kevinnaoko/TA-2122024/Poster/FRONTSIDE_BESAR.png

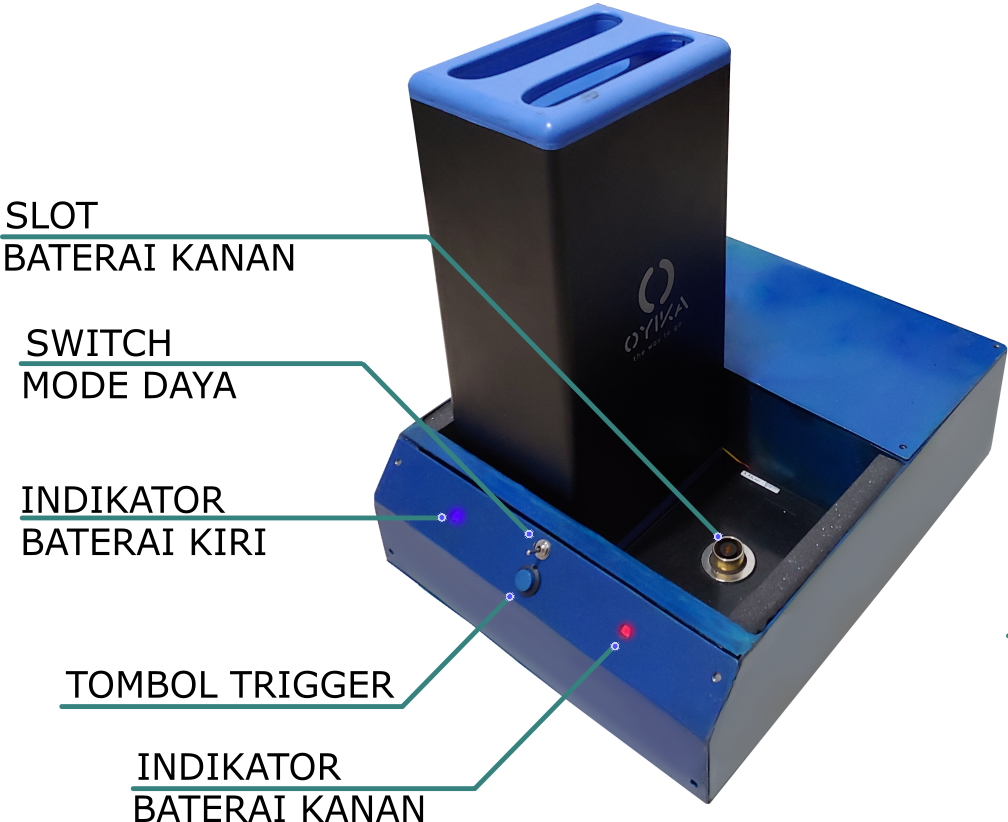
Poster/FRONTSIDE_BESAR.png
