kevinnaoko/TA-2122024/Poster/Brochure 05.jpg

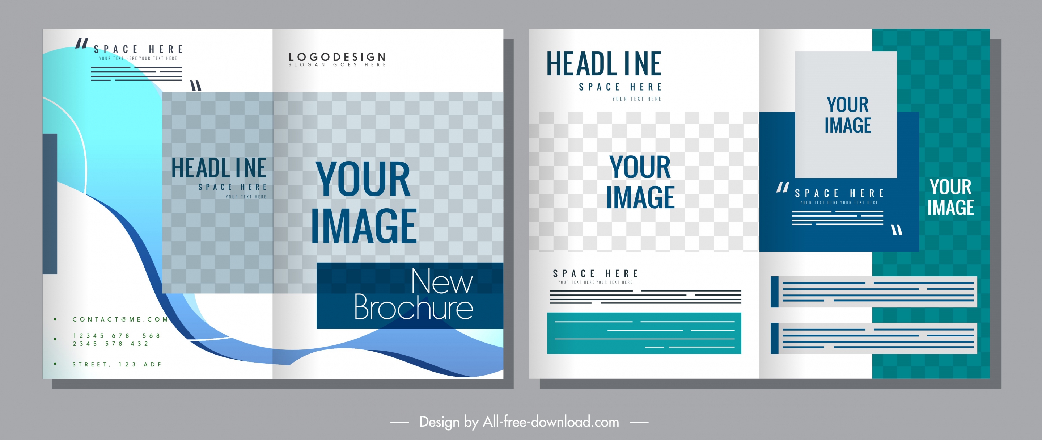
Poster/Brochure 05.jpg
