kevinnaoko/TA-2122024/README.md

# TA-2122024
Capstone Design Kelompok 24
