kevinnaoko/TA-2122024/Eagle/BRD_Charger.png

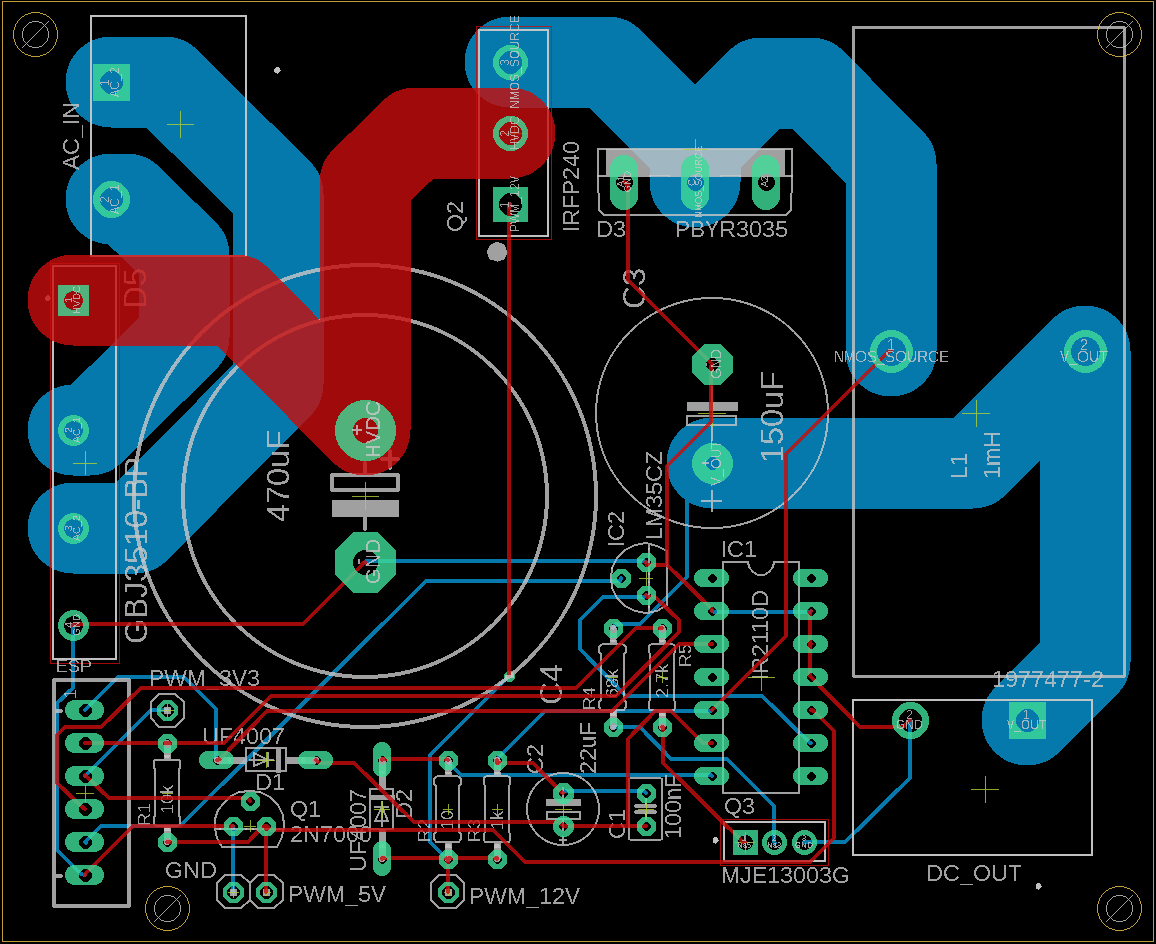
Eagle/BRD_Charger.png
