kevinnaoko/TA-2122024/Eagle/charger board v4_TLP driver circuit (tanya)/chg v4 tlp.png

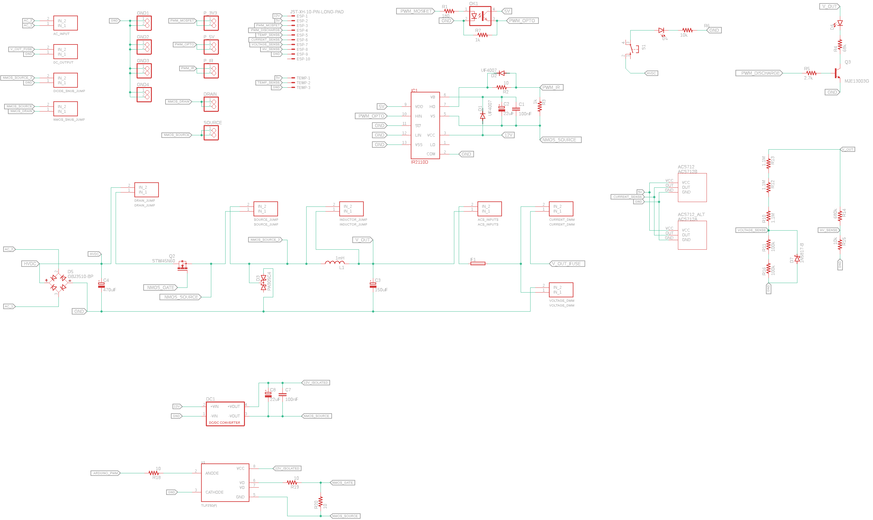
Eagle/charger board v4_TLP driver circuit (tanya)/chg v4 tlp.png
