kevinnaoko/TA-2122024/Eagle/charger board v4_TLP driver circuit/chg v4 tlp.png

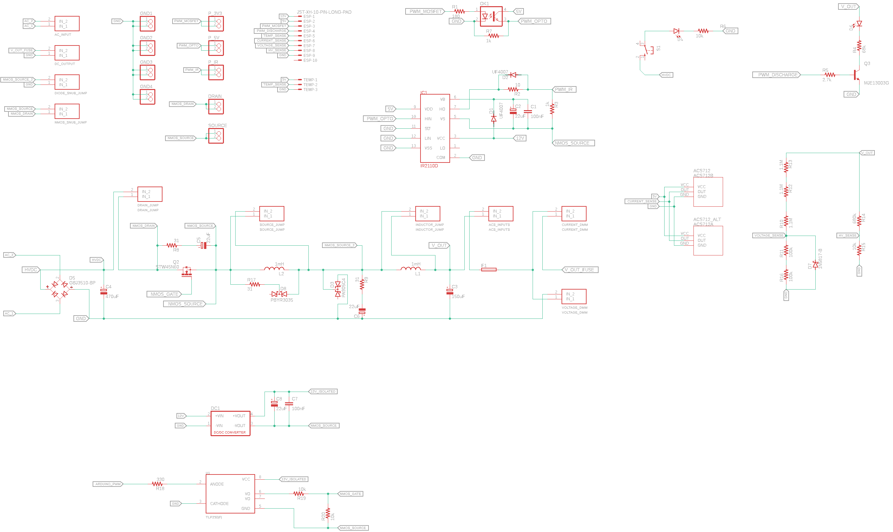
Eagle/charger board v4_TLP driver circuit/chg v4 tlp.png
