kevinnaoko/TA-2122024/Eagle/Pics/charger_v4 - Copy.png

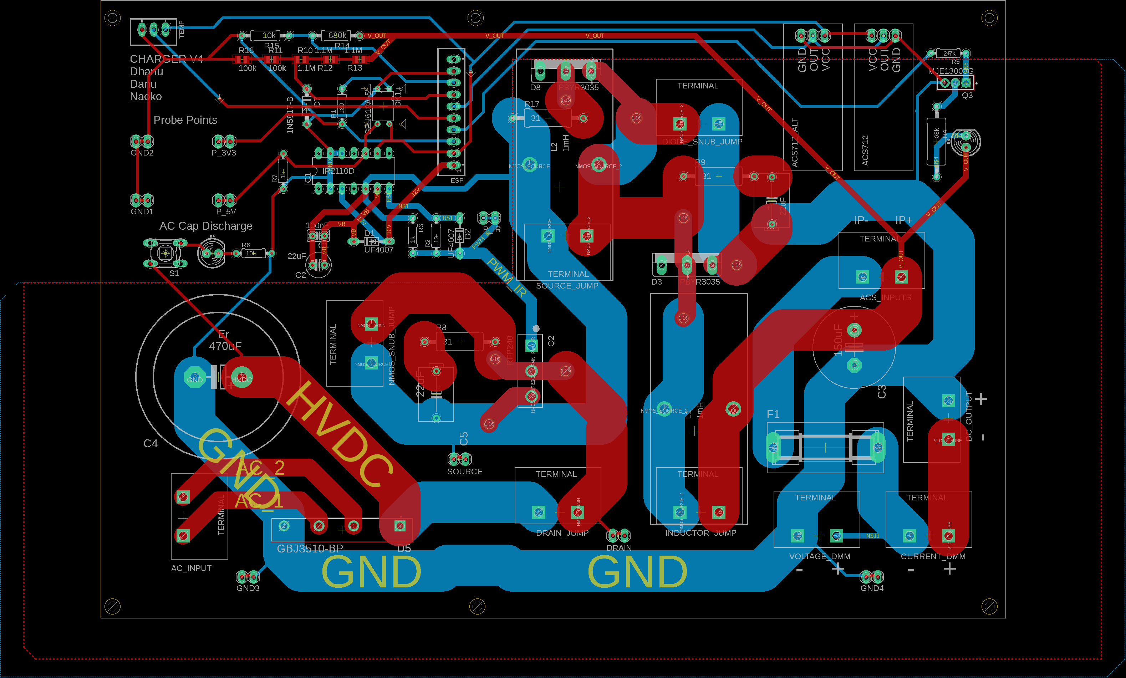
Eagle/Pics/charger_v4 - Copy.png
