kevinnaoko/TA-2122024/Eagle/Pics/charger_v4_gndplane.png

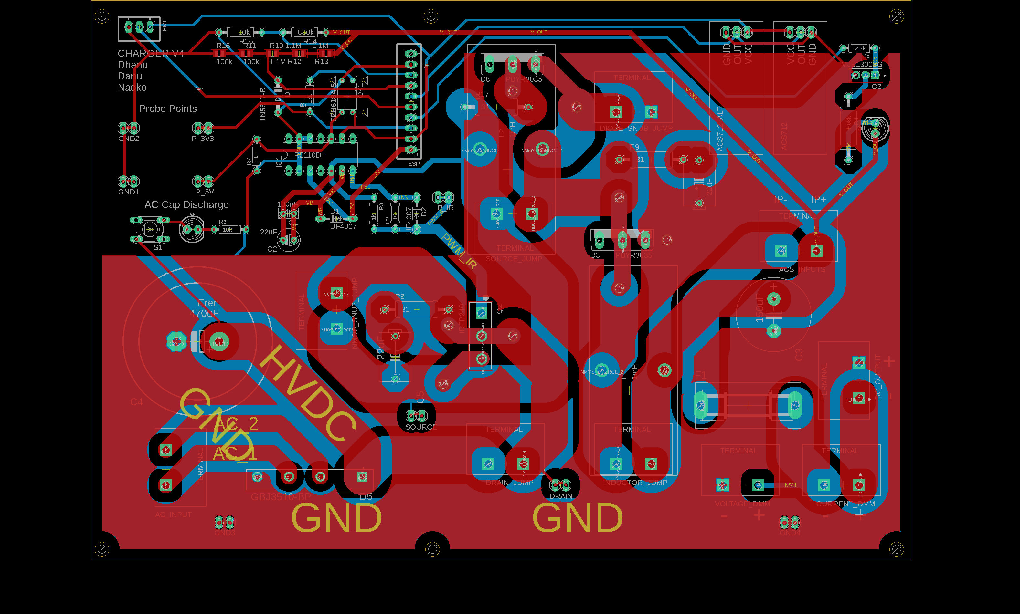
Eagle/Pics/charger_v4_gndplane.png
