kevinnaoko/TA-2122024/Eagle/Pics/charger_v4_gndplane_bottom.png

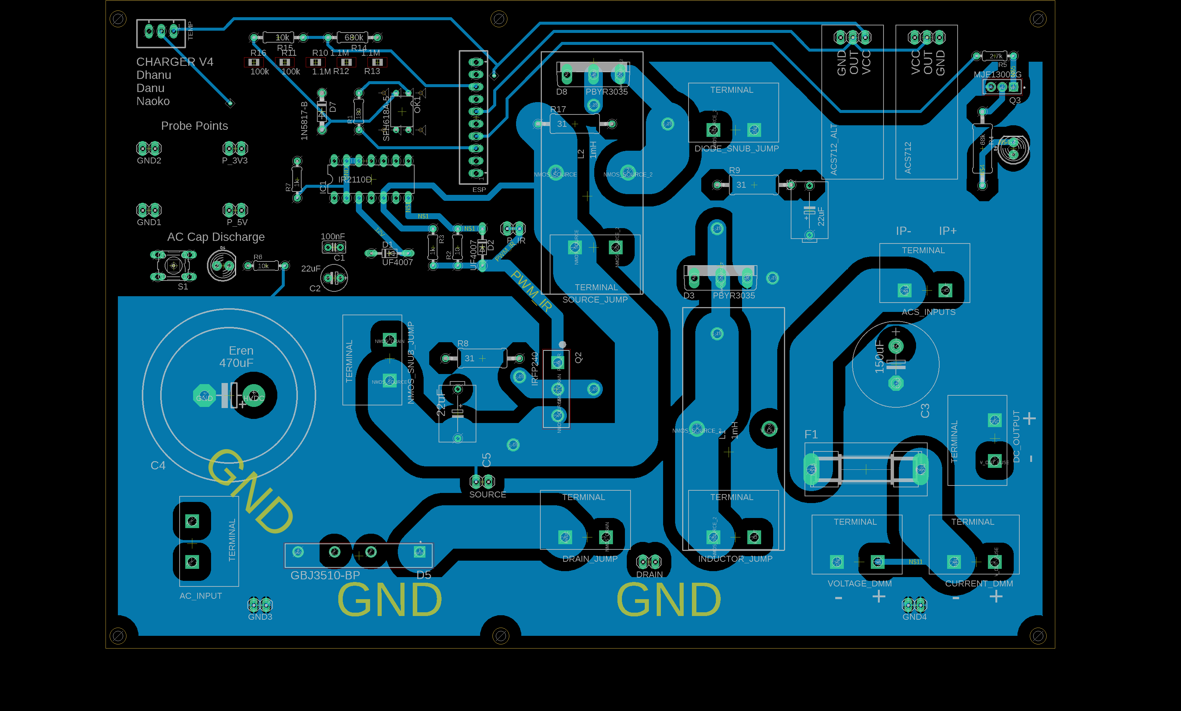
Eagle/Pics/charger_v4_gndplane_bottom.png
