kevinnaoko/TA-2122024/Eagle/Pics/charger_v4_sch.png

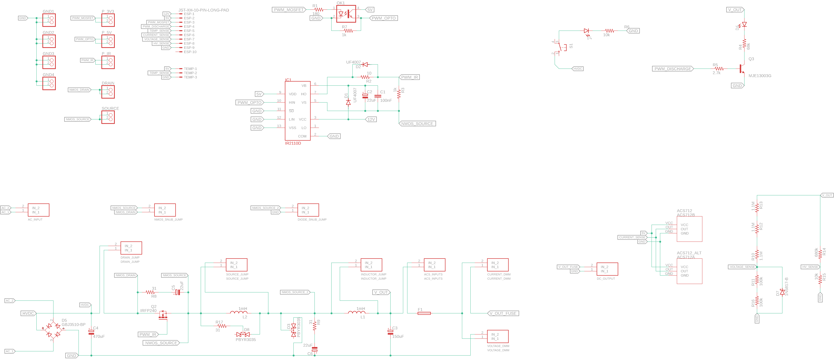
Eagle/Pics/charger_v4_sch.png
