kevinnaoko/TA-2122024/Eagle/Pics/kontrol_v2.png

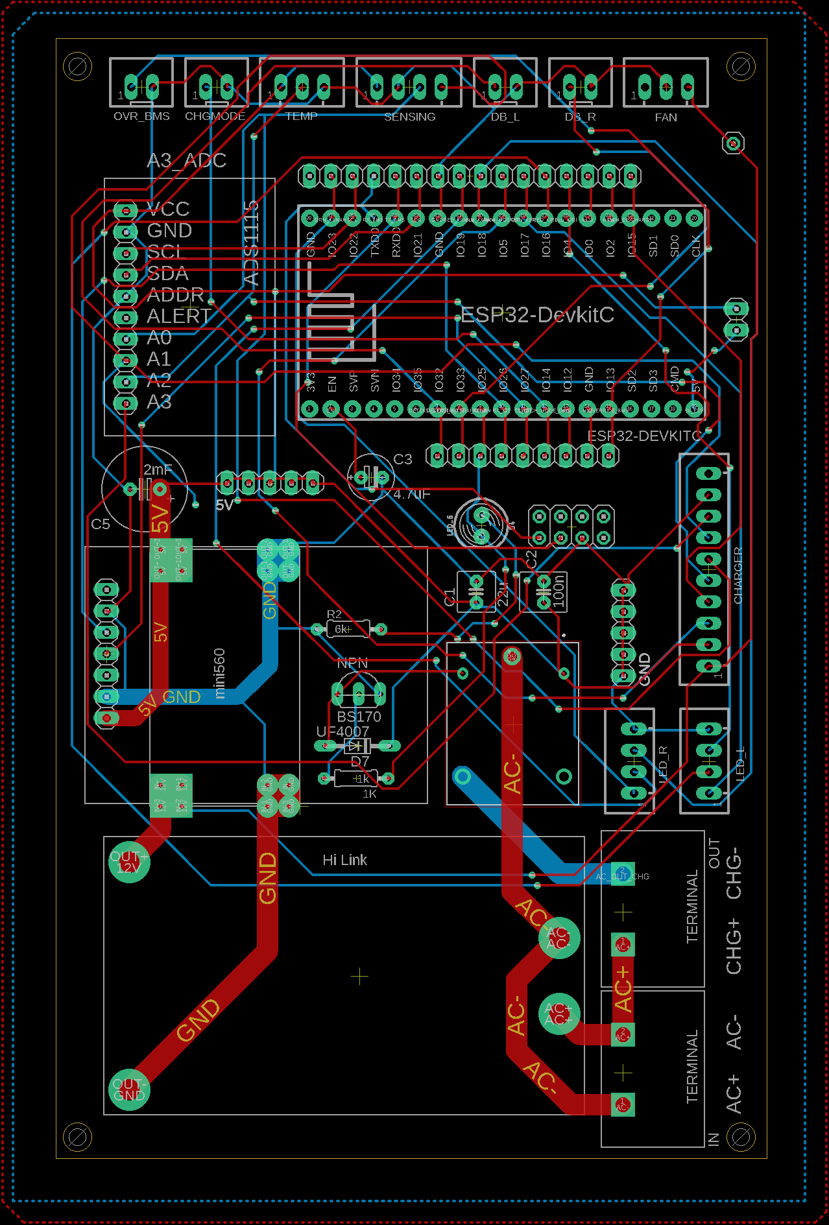
Eagle/Pics/kontrol_v2.png
