kevinnaoko/TA-2122024/Eagle/Pics/kontrol_v2_gndplane_bottom.png

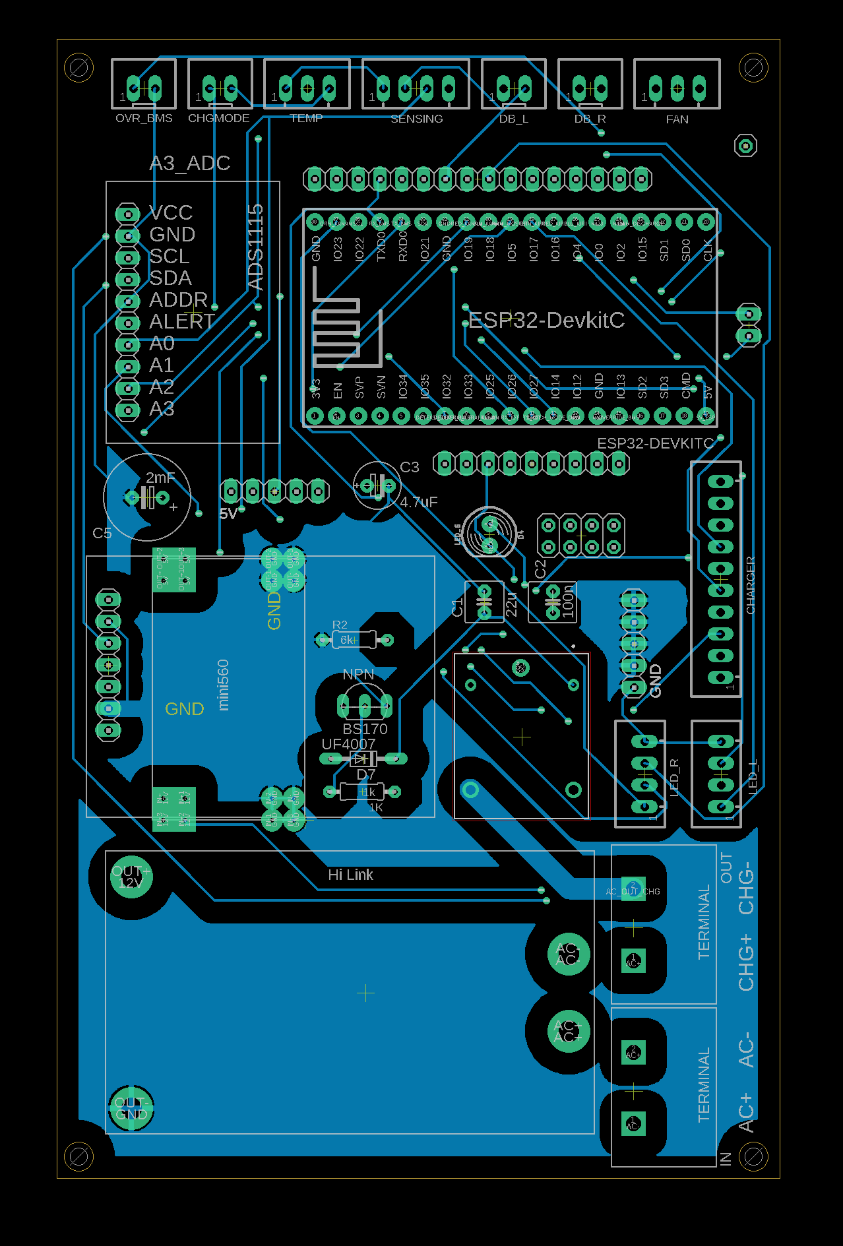
Eagle/Pics/kontrol_v2_gndplane_bottom.png
