kevinnaoko/TA-2122024/Eagle/Pics/kontrol_v2_gndplane_top.png

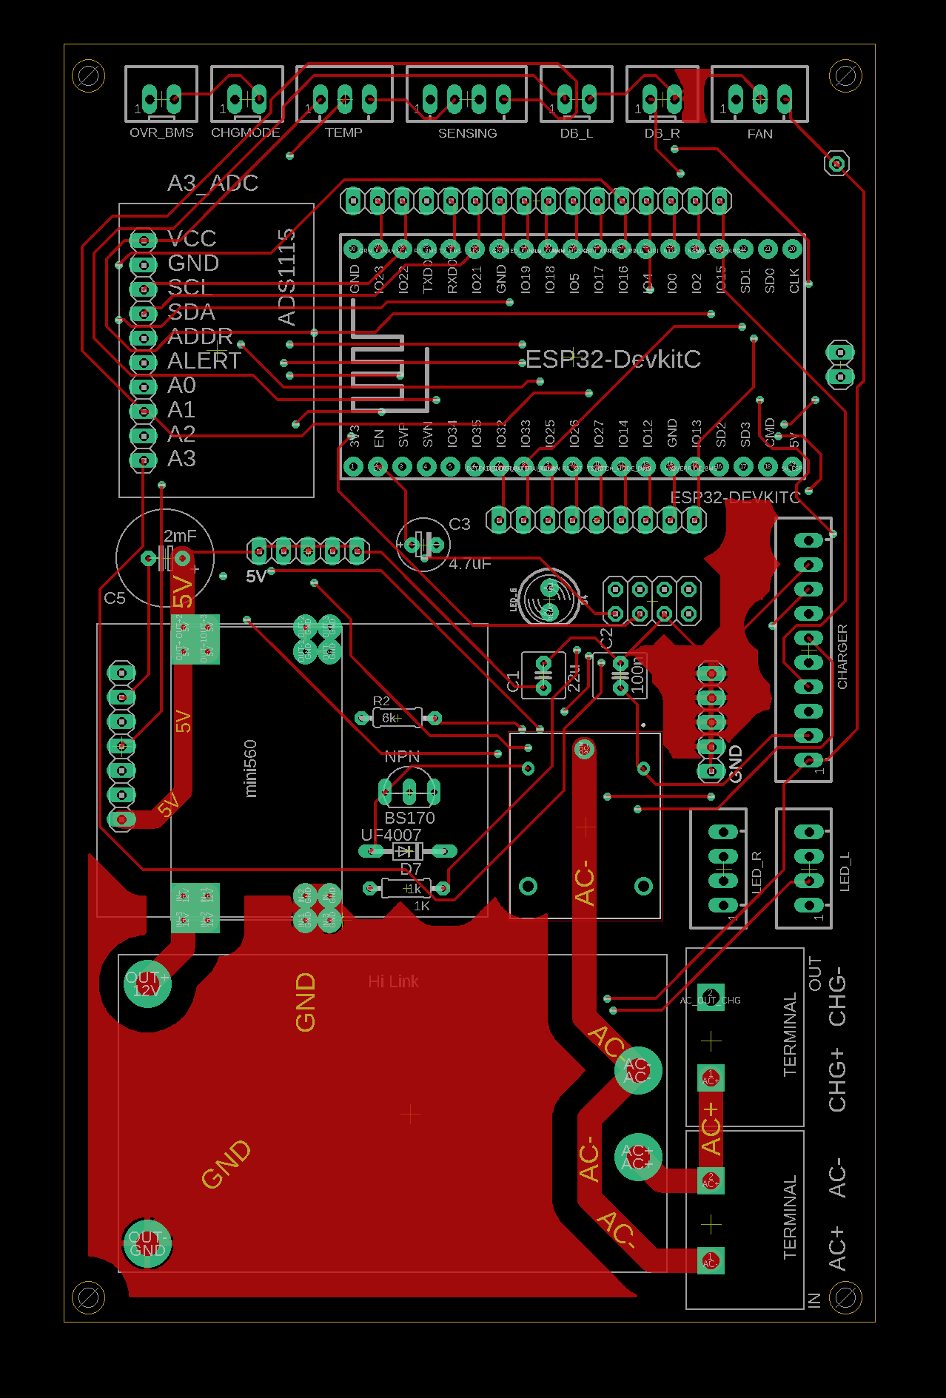
Eagle/Pics/kontrol_v2_gndplane_top.png
