kevinnaoko/TA-2122024/Eagle/SCH_Charger.png

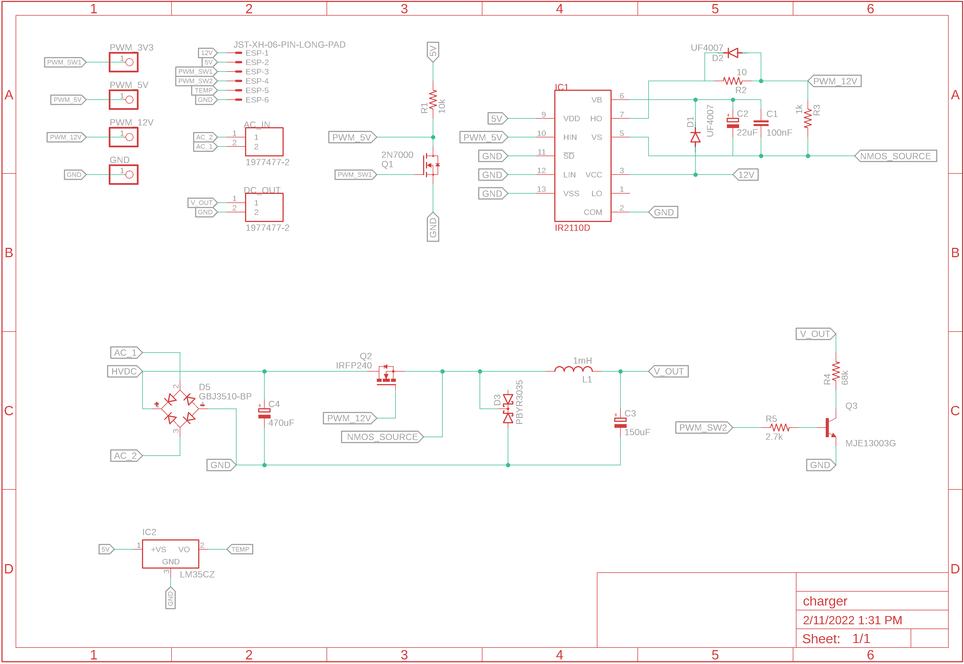
Eagle/SCH_Charger.png
