kevinnaoko/TA-2122024/Poster/BACKSIDE_BESAR.png

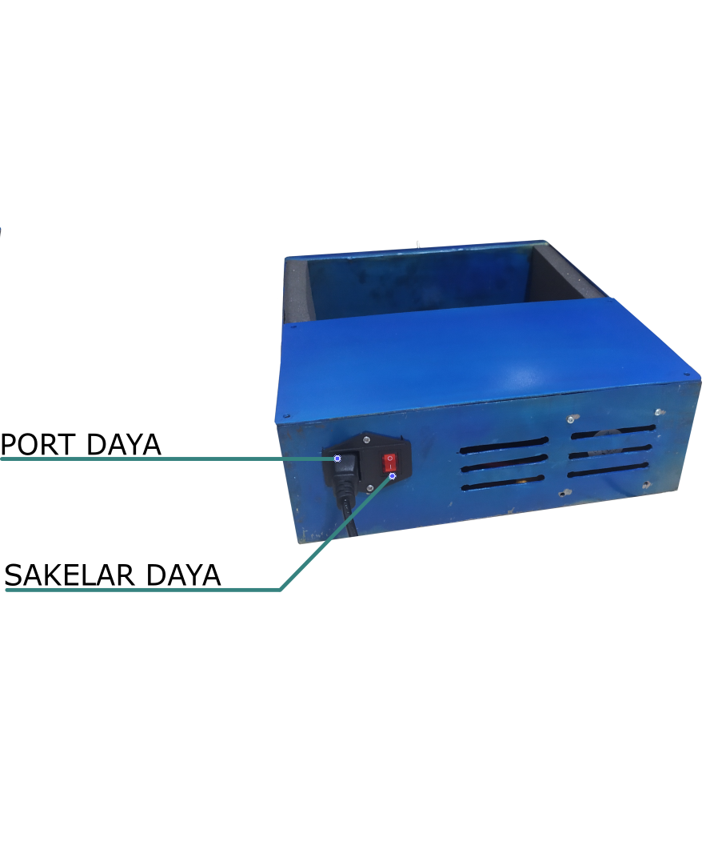
Poster/BACKSIDE_BESAR.png
