kevinnaoko/TA-2122024/Poster/Brosur A5 V2.png

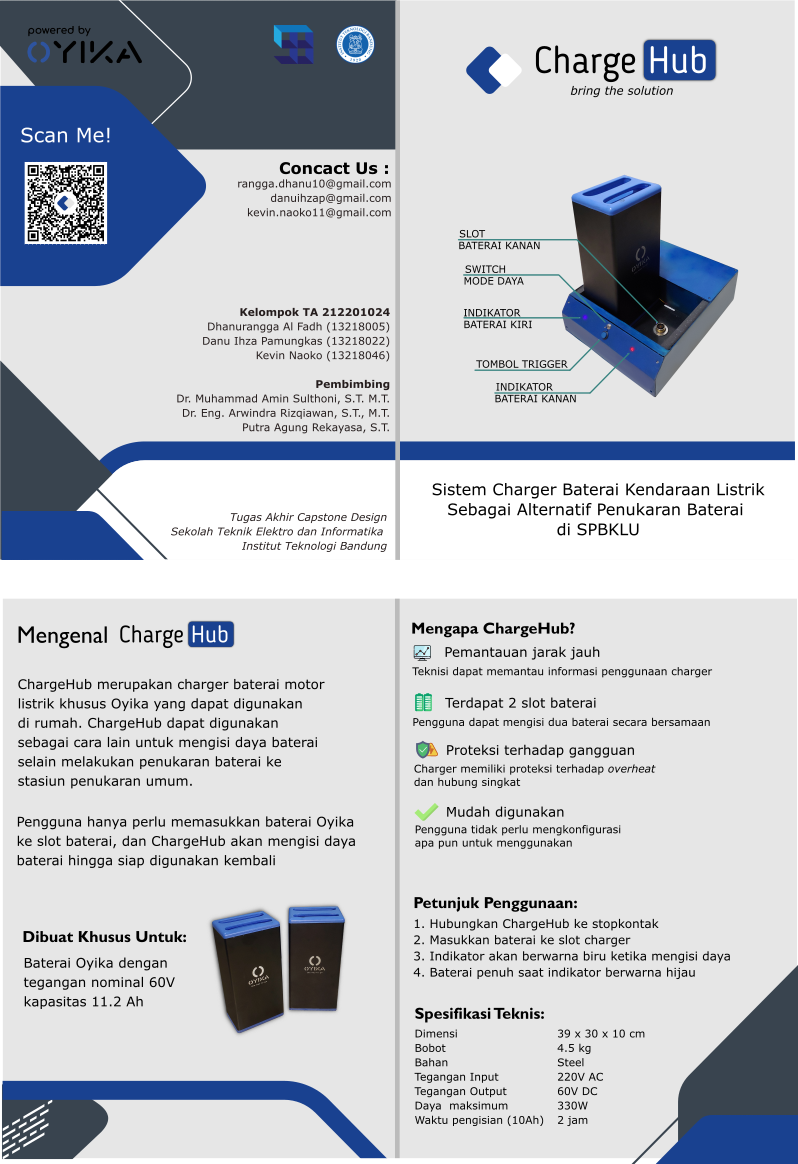
Poster/Brosur A5 V2.png
