kevinnaoko/TA-2122024/Poster/Brosur A5 V3 - Pg 1.png

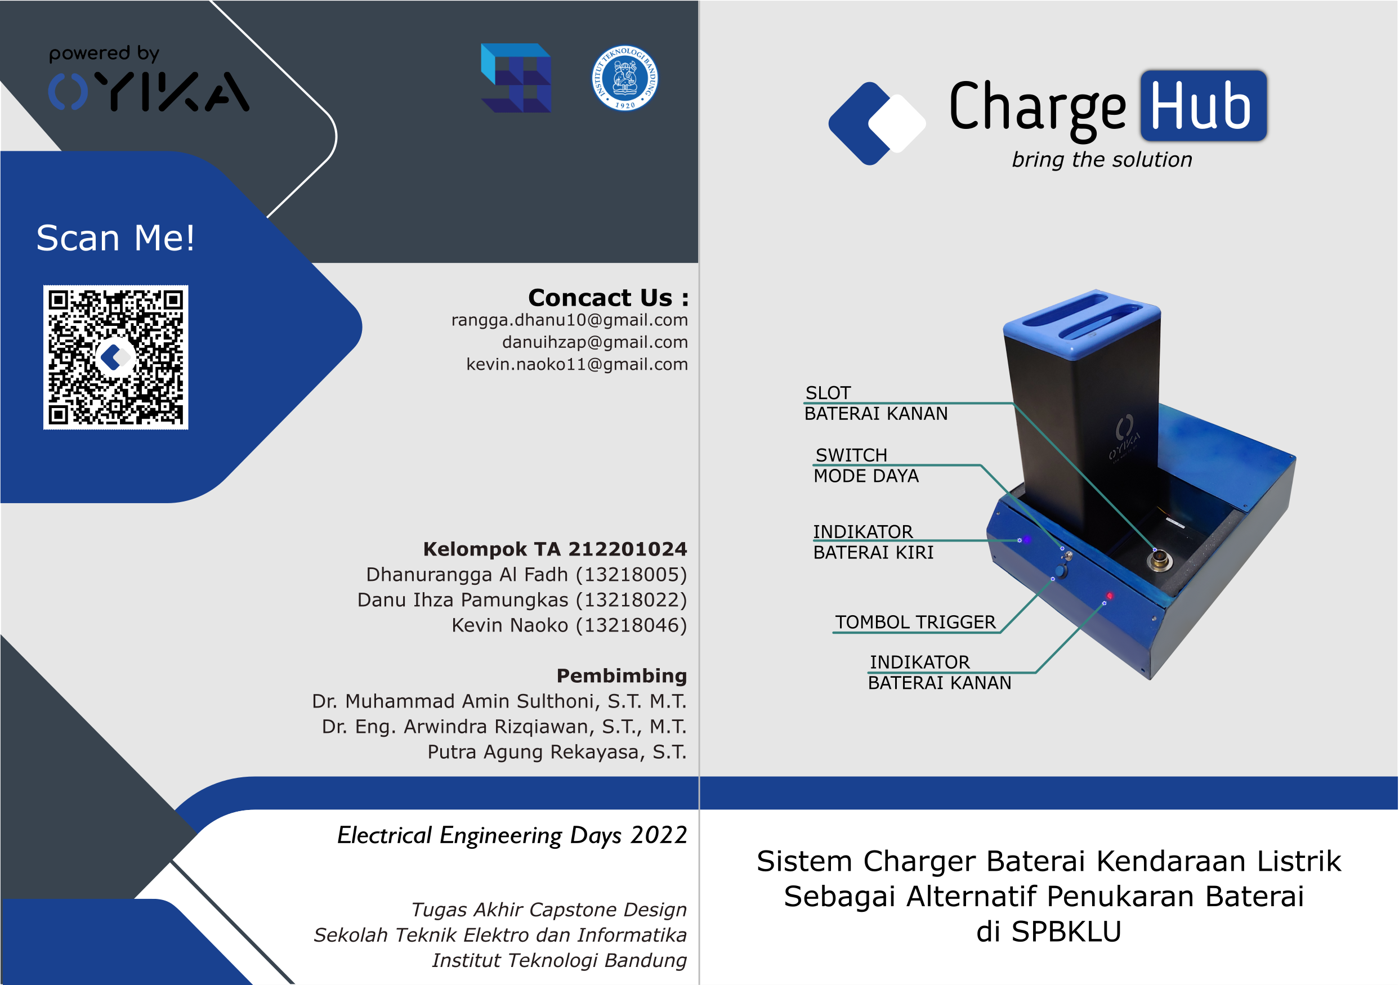
Poster/Brosur A5 V3 - Pg 1.png
