kevinnaoko/TA-2122024/Poster/Brosur A5 V3 - Pg 2.png

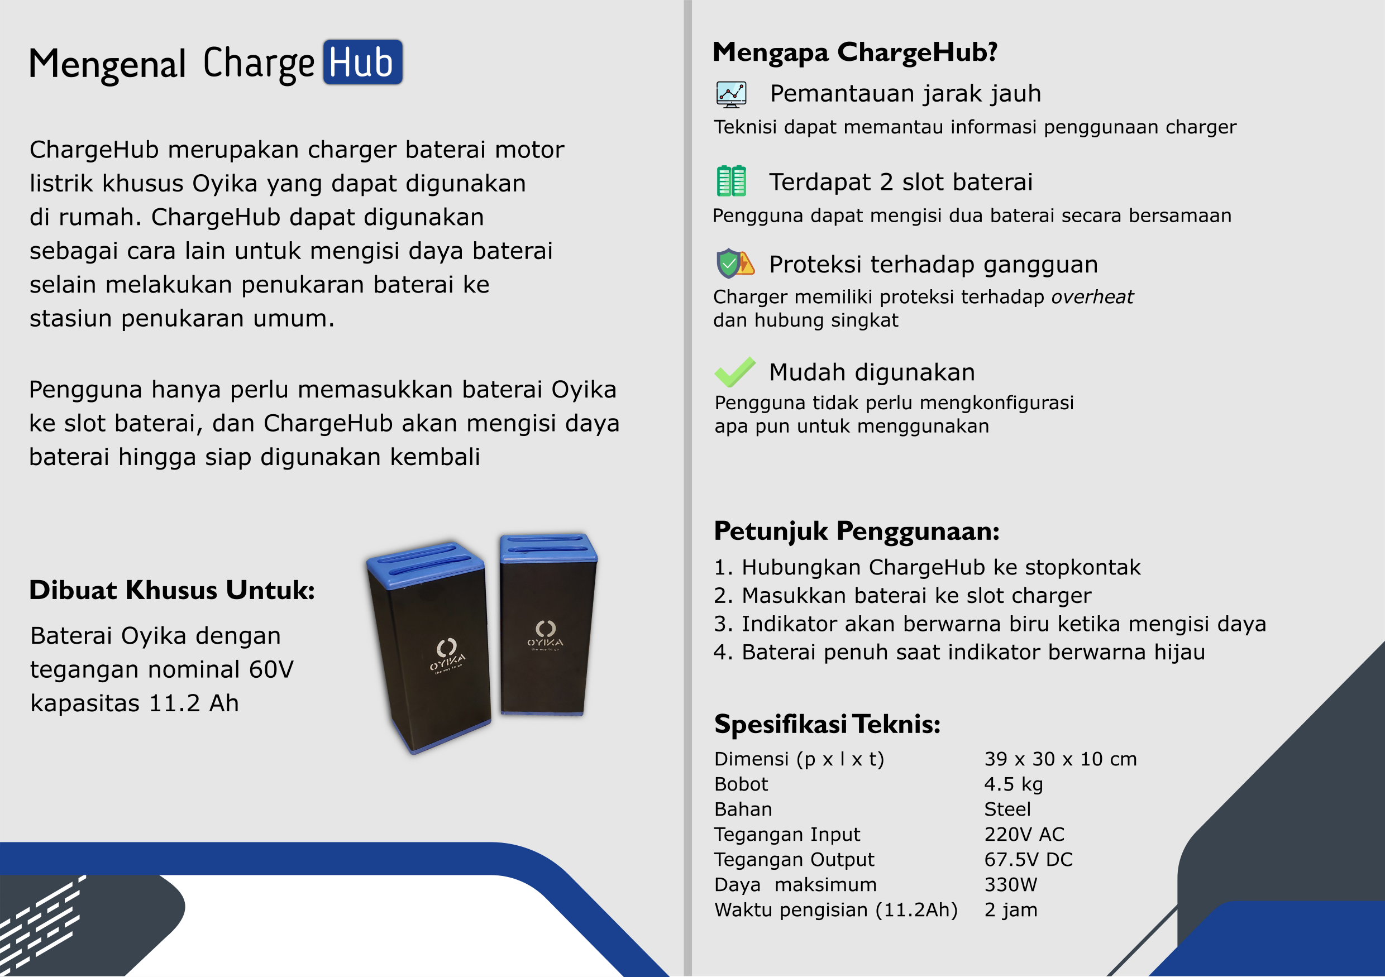
Poster/Brosur A5 V3 - Pg 2.png
