kevinnaoko/TA-2122024/Poster/Chargehub sticker black.png

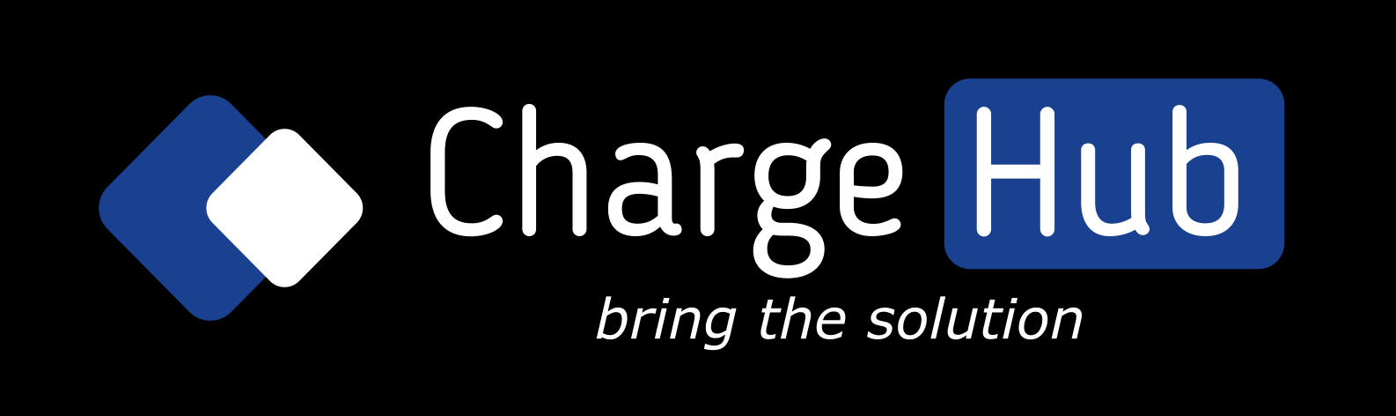
Poster/Chargehub sticker black.png
