kevinnaoko/TA-2122024/Poster/chargehub sticker white.png

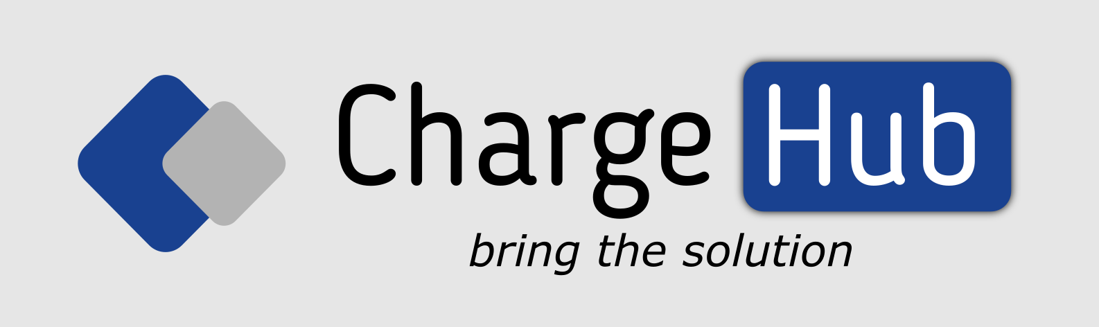
Poster/chargehub sticker white.png
