kevinnaoko/TA-2122024/Poster/CHGHUB MIN.png

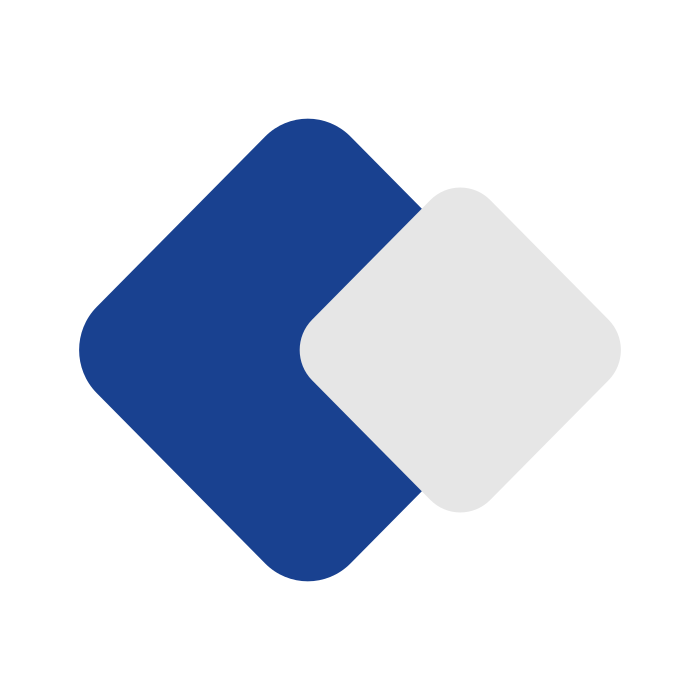
Poster/CHGHUB MIN.png
