kevinnaoko/TA-2122024/Poster/chghub no text.png

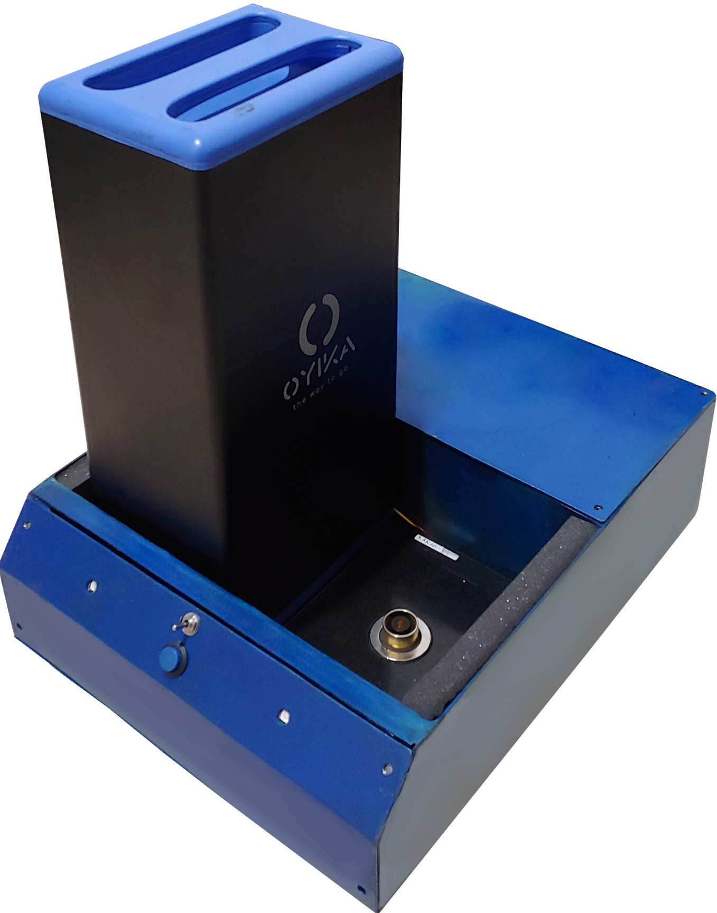
Poster/chghub no text.png
