kevinnaoko/TA-2122024/Poster/g36592.png

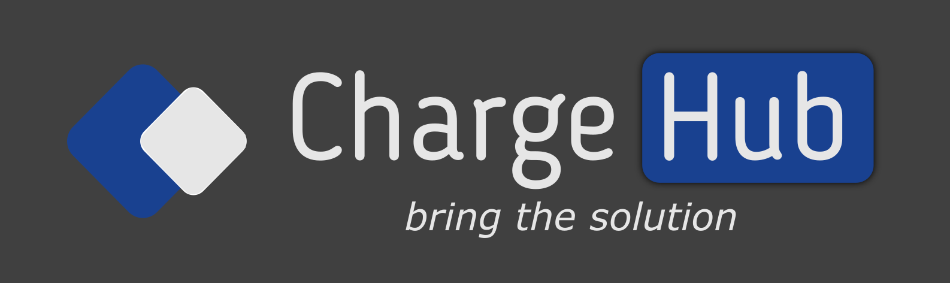
Poster/g36592.png
