kevinnaoko/TA-2122024/Poster/Poster A0 V2.png

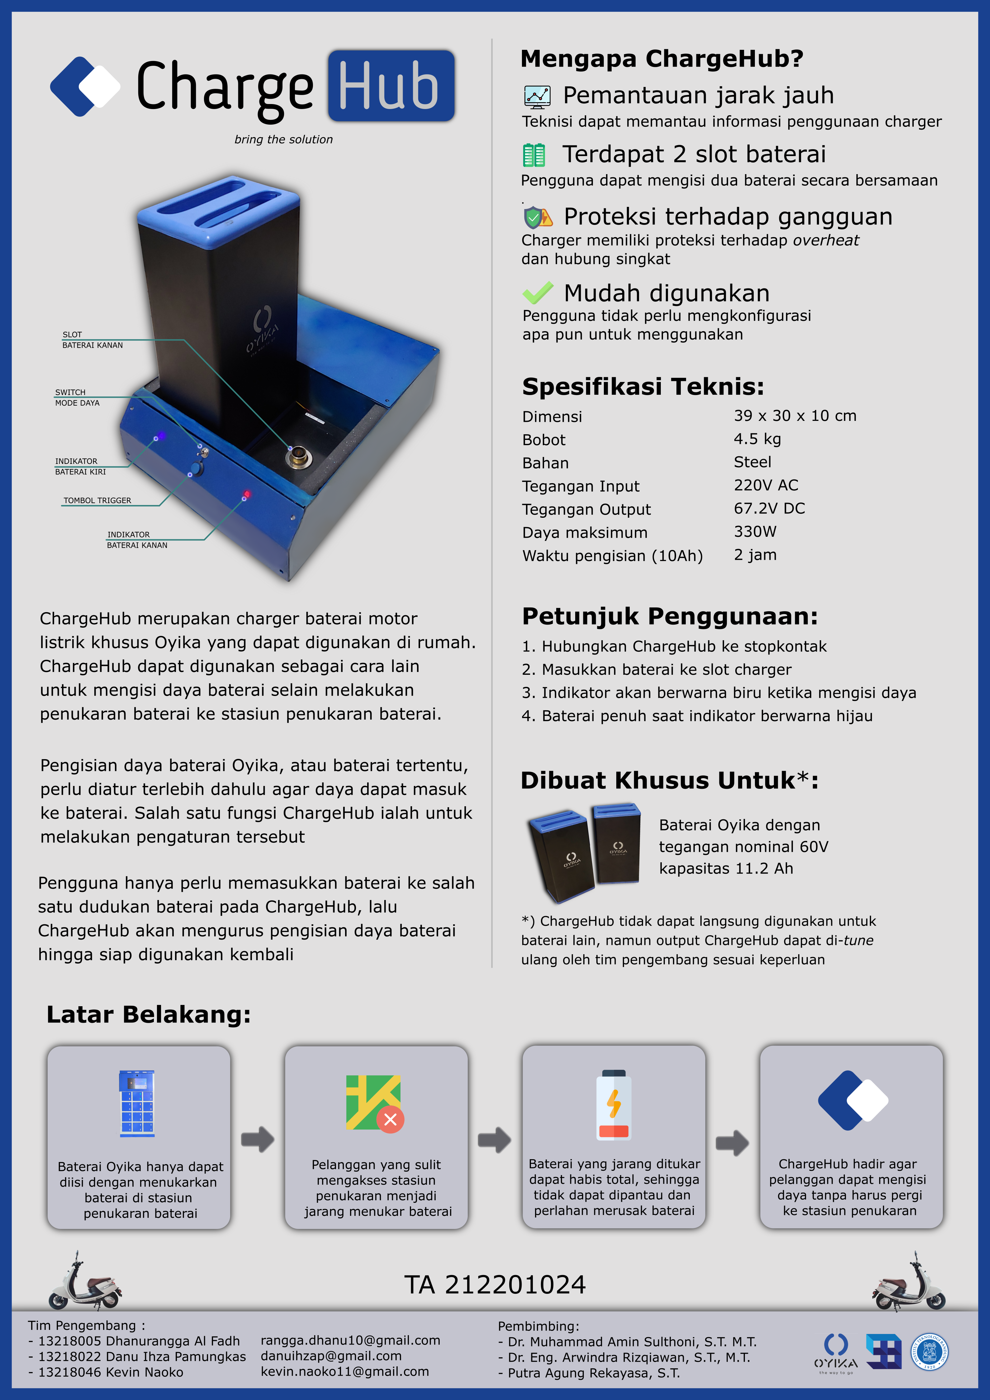
Poster/Poster A0 V2.png
