kevinnaoko/TA-2122024/Poster/Stickers.png

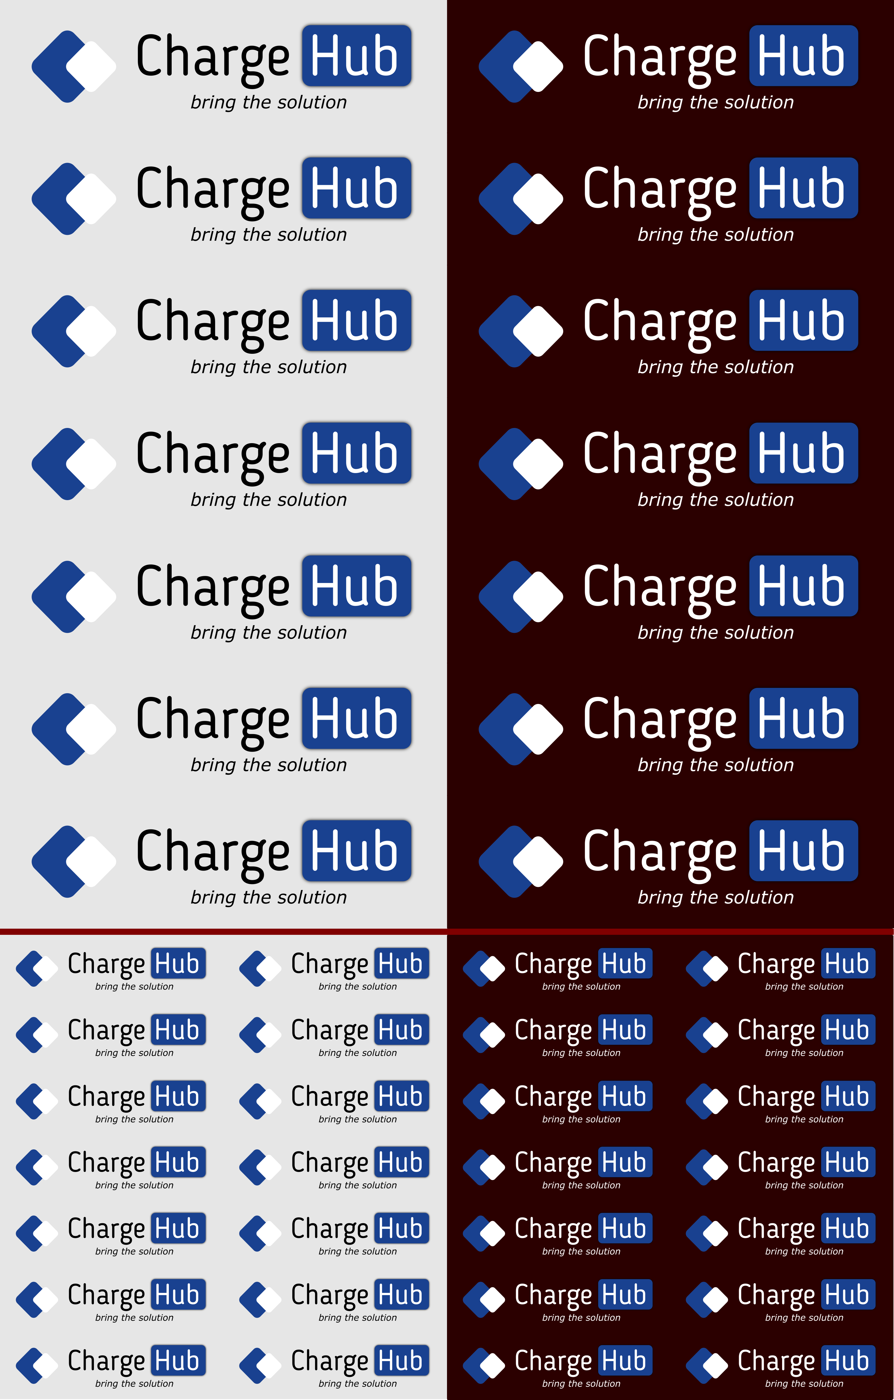
Poster/Stickers.png
