kevinnaoko/TA-2122024/Solidworks/Casing-Drawing.PNG

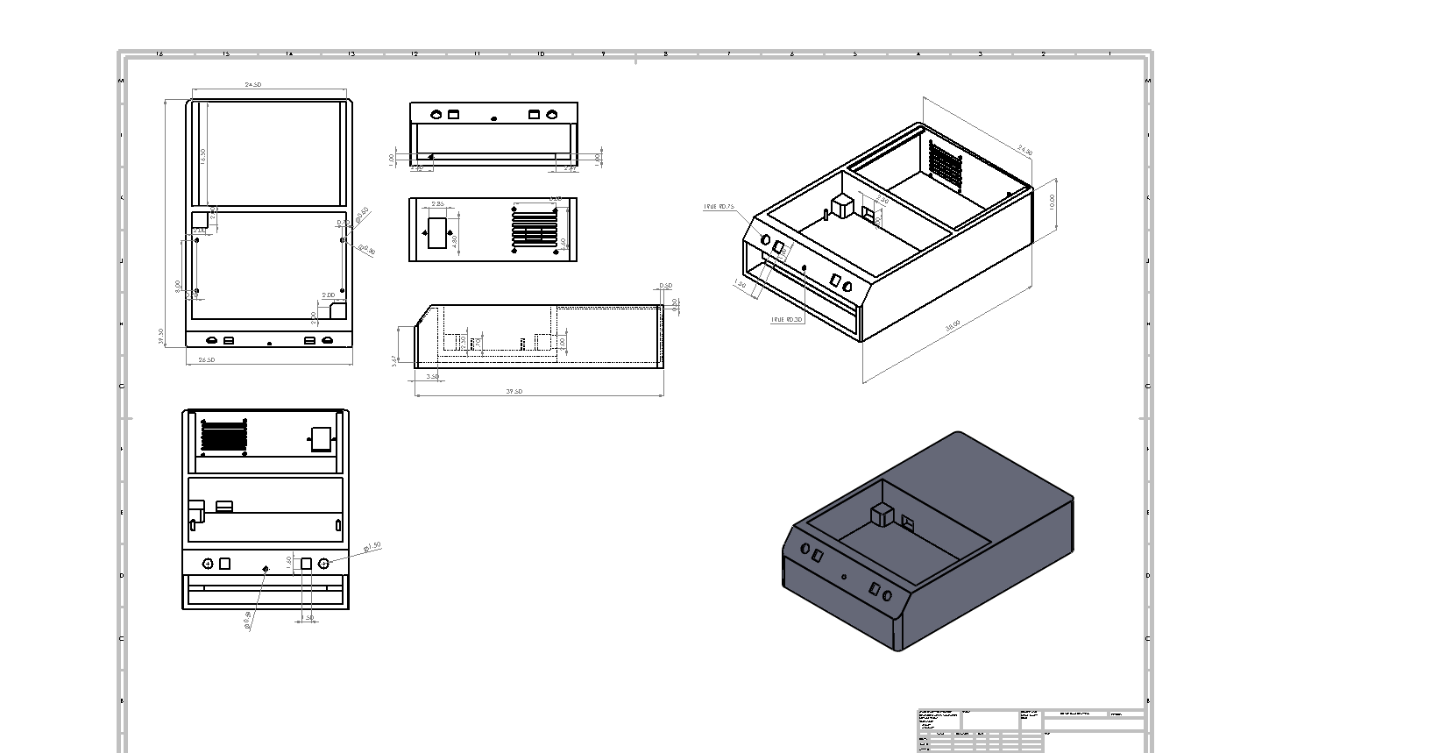
Solidworks/Casing-Drawing.PNG
