kevinnaoko/TA-2122024/Source Code/server_newDb/templates/idle.png

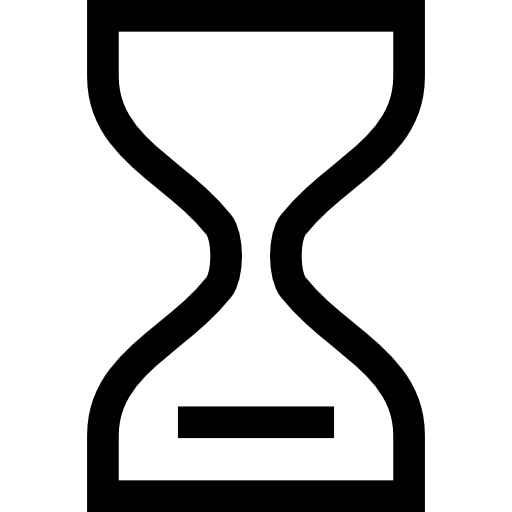
Source Code/server_newDb/templates/idle.png
