kevinnaoko/TA-2122024/Solidworks/Casing-v4.SLDPRT

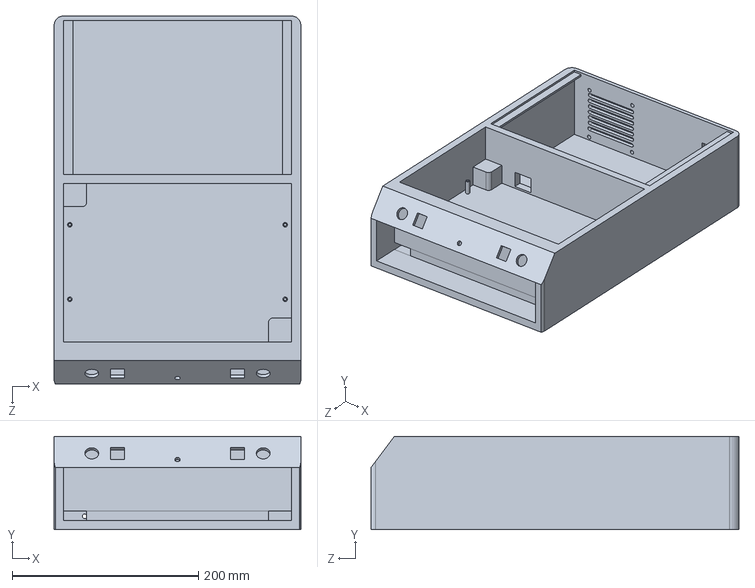
[picture p32: CAD file, 2022-04-18]
Solidworks/Casing-v4.SLDPRT
265.0 x 100.0 x 395.0 mm
