kevinnaoko/TA-2122024/Solidworks/Casing-v2.SLDPRT

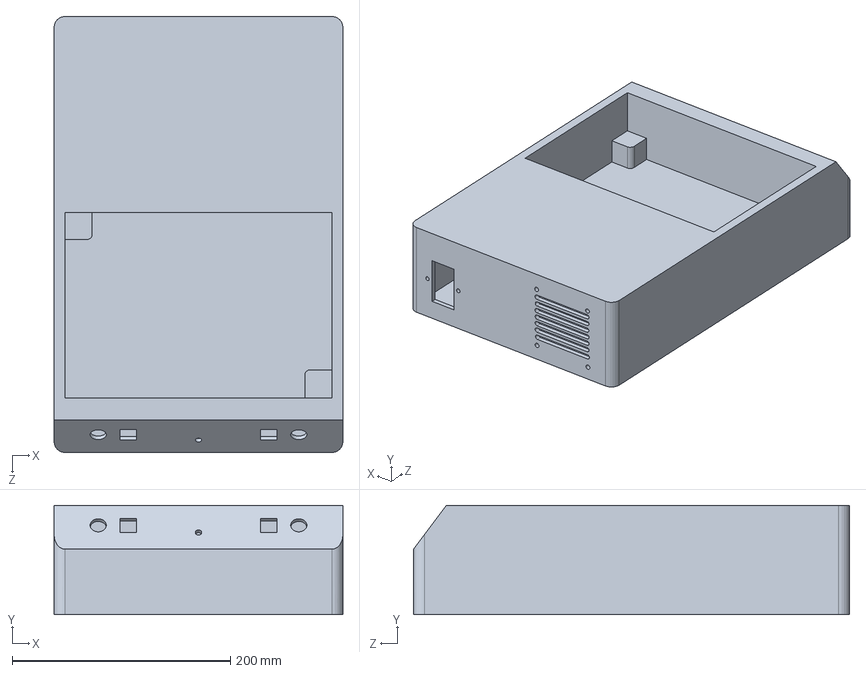
[picture p34: CAD file, 2022-04-18, an earlier design]
Solidworks/Casing-v2.SLDPRT
265.0 x 100.0 x 400.0 mm
