kevinnaoko/TA-2122024/Solidworks/Casing-v3.SLDPRT

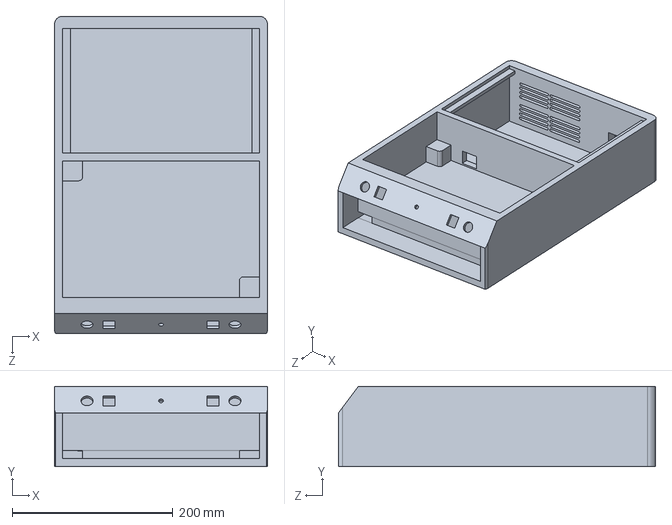
[picture p35: CAD file, 2022-04-18, an earlier design]
Solidworks/Casing-v3.SLDPRT
265.0 x 100.0 x 395.0 mm
