kevinnaoko/TA-2122024/(list of files, cad)

Other CAD files:
Sketchup/Untitled.skp
Sketchup/chRGER.skp
Solidworks/Casing-Drawing.SLDDRW
Solidworks/Casing-v41.SLDDRW
Solidworks/Charger-v1.SLDDRW
