kevinnaoko/TA-2122024/Source Code/keterangan versi b500_test.txt

b500_v2   = sama seperti b500_test_newcontrol_update1juni_pilihnet_statefailure
b500_v2.1 = b500_v2 ditambah kode sync on/off di bagian inisialisasi iot
