kevinnaoko/TA-2122024/Spice/buck.asc

C1: cap; 150µ
C2: cap; 230n; V=25 Irms=0 Rser=0 Lser=0 mfg="Murata" pn="GRM0335C1E101JA01" type="C0G"
D1: diode; KD2997A
L1: ind; 1m; Rser=1m
PWM: voltage; PULSE(0 12 1n 1n 1n 100u 200u)
R1: res; 10
R2: res; 31
U1: irfp460
V2: voltage; 311
Named nets: 0
.tran 0 4m 1u
