kevinnaoko/TA-2122024/Eagle/charger board v4_TLP driver circuit (tanya)/charger_v4.brd

## EAGLE design Eagle/charger board v4_TLP driver circuit (tanya)/charger_v4.brd (2022-06-07)

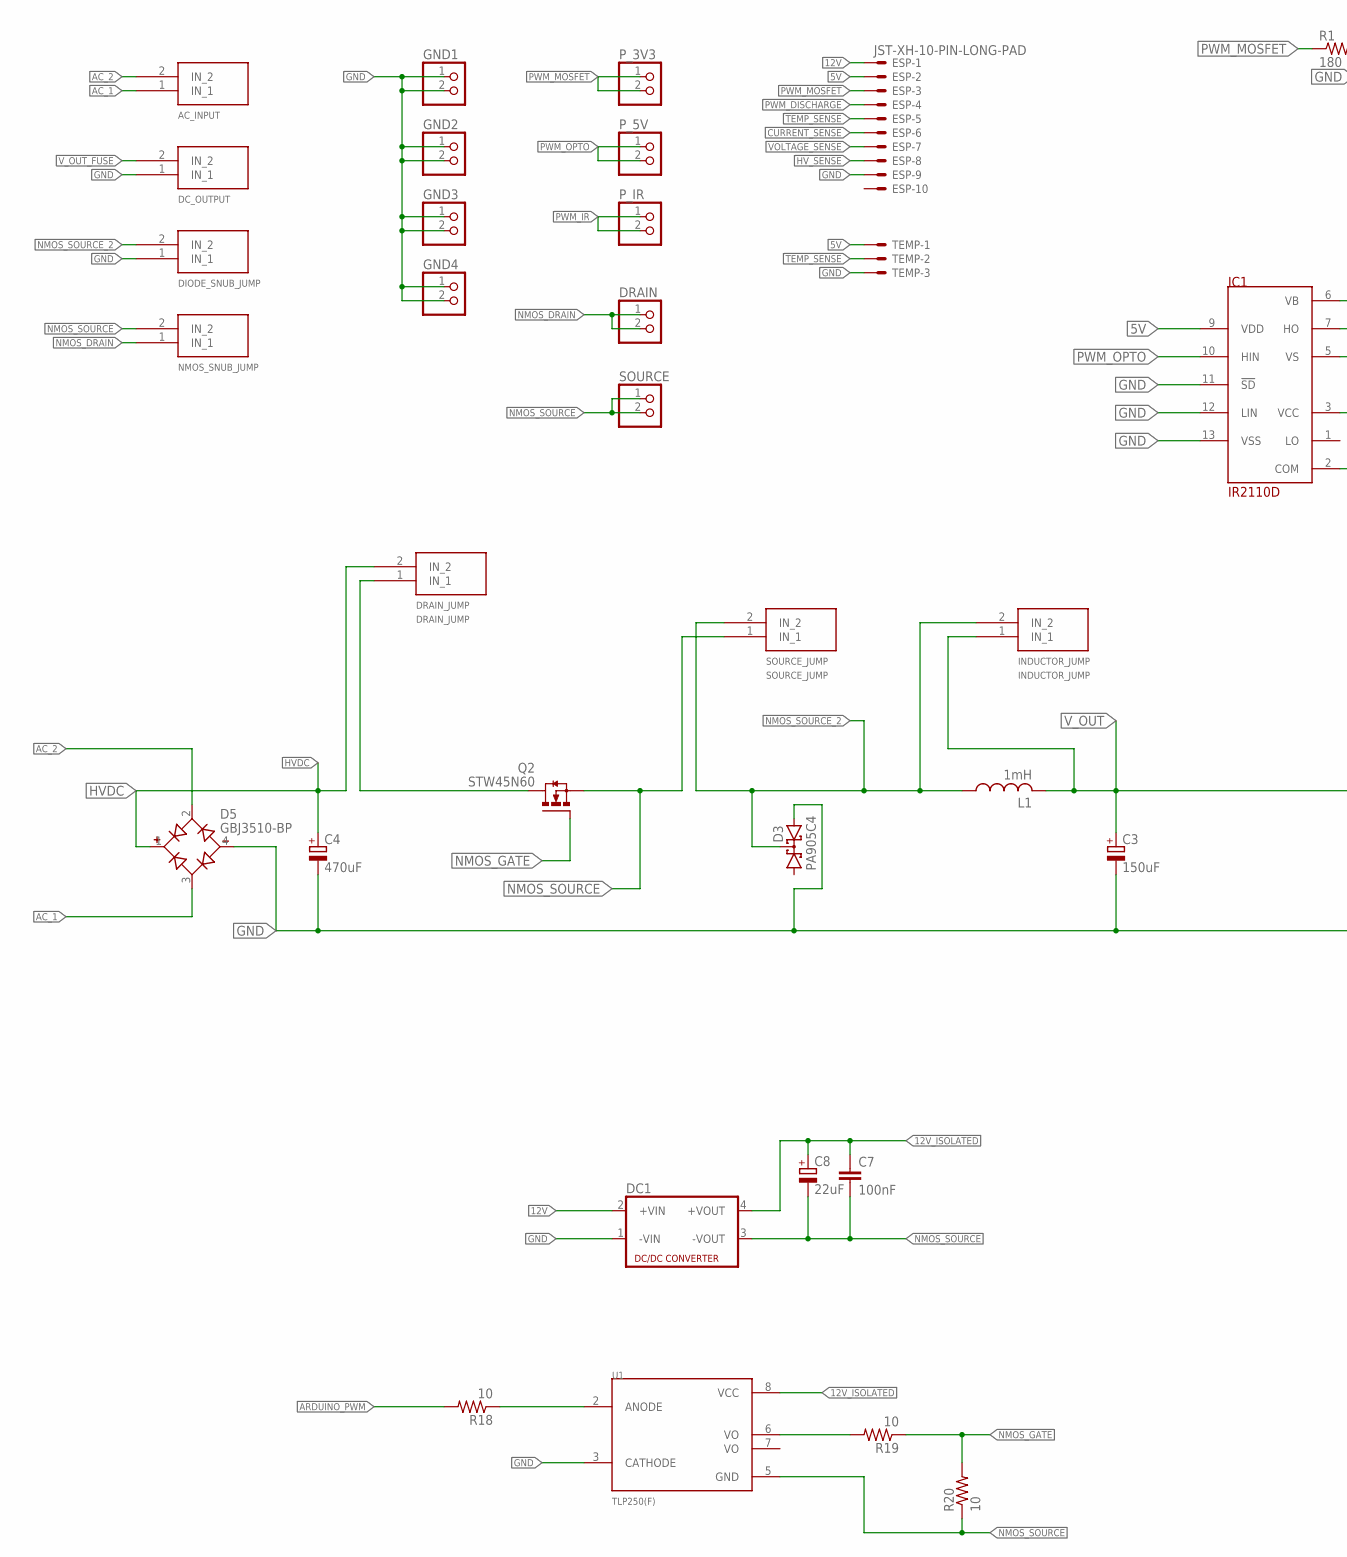
[picture p37: schematic charger_v4.sch, part in row 1, column 1]

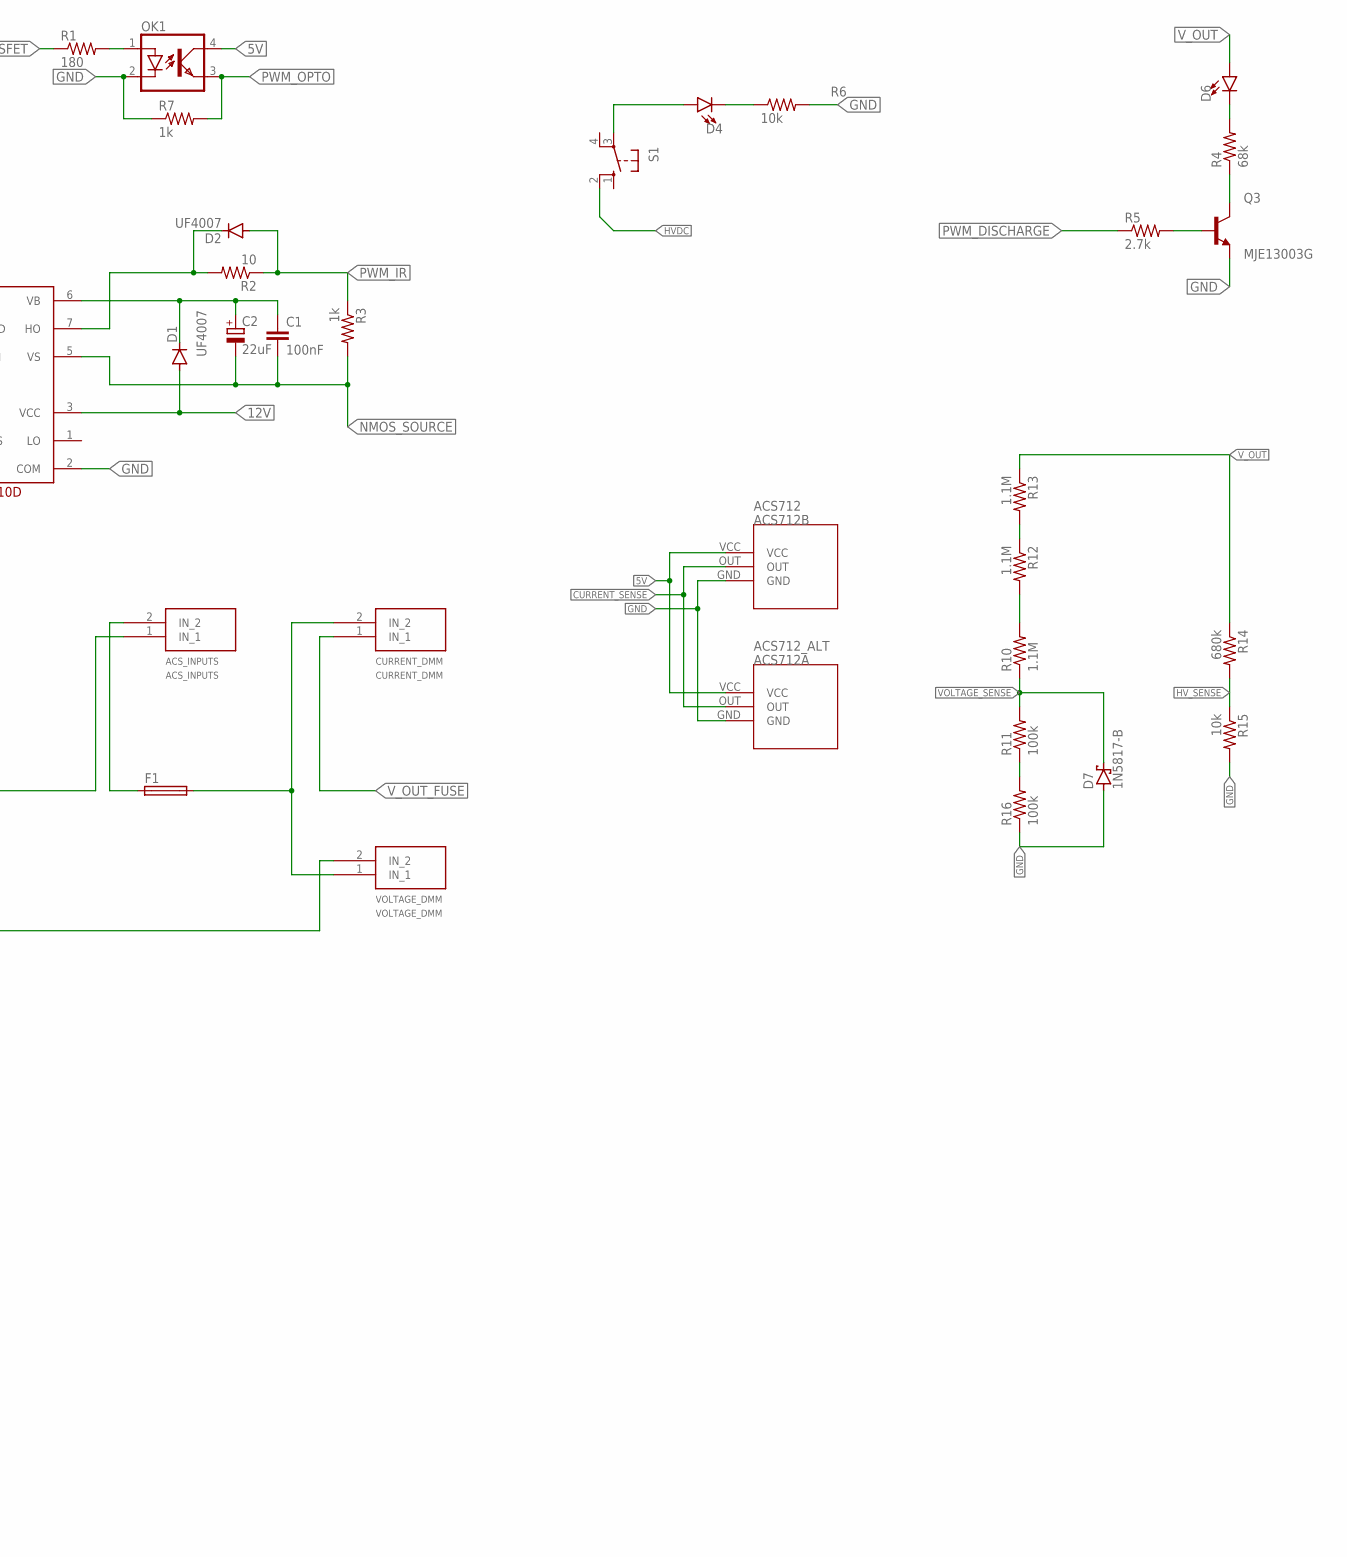
[picture p38: schematic charger_v4.sch, part in row 1, column 2]

Parts:
ACS712: ACS712B; ACS712-2
ACS712_ALT: ACS712A; ACS712-1
ACS_INPUTS: ACS_INPUTS; TERMINAL_2P
AC_INPUT: AC_INPUT; TERMINAL_2P
C1, C7: 100nF; C025-025X050
C2, C8: 22uF; E2,5-6E
C3: 150uF; E7,5-18
C4: 470uF; EB35D
CURRENT_DMM: CURRENT_DMM; TERMINAL_2P
D1, D2: UF4007; DO34-7
D3: PA905C4; SOT93S
D4, D6: LED5MM; LED_5MM
D5: GBJ3510-BP; DIOB_GBJ3510-BP
D7: 1N5817-B; DO41-7.6
DC1: NME
DC_OUTPUT: DC_OUTPUT; TERMINAL_2P
DIODE_SNUB_JUMP: DIODE_SNUB_JUMP; TERMINAL_2P
DRAIN: PINHD-1X2; 1X02
DRAIN_JUMP: DRAIN_JUMP; TERMINAL_2P
ESP: JST-XH-10-PIN-LONG-PAD; JST-XH-10-PACKAGE-LONG-PAD
F1: FUSEHOLDER
GND1, GND2, GND3, GND4: PINHD-1X2; 1X02
IC1: IR2110D; DIL14
INDUCTOR_JUMP: INDUCTOR_JUMP; TERMINAL_2P
L1: 1mH; TJ7-U1
NMOS_SNUB_JUMP: NMOS_SNUB_JUMP; TERMINAL_2P
OK1: SFH618A-5; DIP4
P_3V3, P_5V: PINHD-1X2; 1X02
P_IR: PINHD-1X2; 1X02
Q2: STW45N60; TO247AC
Q3: MJE13003G; TO229P780X300X1364-3
R1: 180; 0204/7
R2, R18, R19, R20: 10; 0204/7
R3, R7: 1k; 0204/7
R4: 68k; 0411/15
R5: 2.7k; 0204/7
R6: 10k; 0204/7
R10, R12, R13: 1.1M; R0805
R11, R16: 100k; R0805
R14: 680k; 0207/10
R15: 10k; 0207/10
S1: 10-XX; B3F-10XX
SOURCE: PINHD-1X2; 1X02
SOURCE_JUMP: SOURCE_JUMP; TERMINAL_2P
TEMP: JST-XH-03-PIN-LONG-PAD; JST-XH-03-PACKAGE-LONG-PAD
U1: TLP250(F); DIP1016W50P254L966H380Q8P
VOLTAGE_DMM: VOLTAGE_DMM; TERMINAL_2P

Connections:
5V: ACS712.VCC, ACS712_ALT.VCC, ESP.2, IC1.9 (VDD), OK1.4 (COL), TEMP.1
12V: D1.A, DC1.2 (+VIN), ESP.1, IC1.3 (VCC)
12V_ISOLATED: C7.1, C8.+, DC1.4 (+VOUT), U1.8 (VCC)
AC_1: AC_INPUT.1 (IN_1), D5.3 (AC2)
AC_2: AC_INPUT.2 (IN_2), D5.2 (AC1)
ARDUINO_PWM: R18.2
CURRENT_SENSE: ACS712.OUT, ACS712_ALT.OUT, ESP.6
GND: ACS712.GND, ACS712_ALT.GND, C3.-, C4.-, D3.A2, D5.4 (-), D7.A, DC1.1 (-VIN), DC_OUTPUT.1 (IN_1), DIODE_SNUB_JUMP.1 (IN_1), ESP.9, GND1.1, GND1.2, GND2.1, GND2.2, GND3.1, GND3.2, GND4.1, GND4.2, IC1.2 (COM), IC1.11 (!SD), IC1.12 (LIN), IC1.13 (VSS), OK1.2 (C), Q3.3 (E), R6.2, R7.1, R15.2, R16.1, TEMP.3, U1.3 (CATHODE), VOLTAGE_DMM.2 (IN_2)
HVDC: C4.+, D5.1 (+), DRAIN_JUMP.2 (IN_2), S1.2 (S1)
HV_SENSE: ESP.8, R14.2, R15.1
unnamed: D2.C, IC1.7 (HO), R2.2
unnamed: D4.A, S1.3
unnamed: Q3.2 (C), R4.1
unnamed: D6.K (C), R4.2
unnamed: Q3.1 (B), R5.2
unnamed: D4.K (C), R6.1
unnamed: OK1.1 (A), R1.2
unnamed: CURRENT_DMM.2 (IN_2), F1.2, VOLTAGE_DMM.1 (IN_1)
unnamed: R10.2, R12.2
unnamed: R12.1, R13.2
unnamed: R11.1, R16.2
unnamed: ACS_INPUTS.2 (IN_2), F1.1
unnamed: R18.1, U1.2 (ANODE)
unnamed: R19.2, U1.6 (VO)
NMOS_DRAIN: DRAIN.1, DRAIN.2, DRAIN_JUMP.1 (IN_1), NMOS_SNUB_JUMP.1 (IN_1), Q2.2 (D)
NMOS_GATE: Q2.1 (G), R19.1, R20.2
NMOS_SOURCE: C1.2, C2.-, C7.2, C8.-, DC1.3 (-VOUT), IC1.5 (VS), NMOS_SNUB_JUMP.2 (IN_2), Q2.3 (S), R3.2, R20.1, SOURCE.1, SOURCE.2, SOURCE_JUMP.1 (IN_1), U1.5 (GND)
NMOS_SOURCE_2: D3.C, DIODE_SNUB_JUMP.2 (IN_2), INDUCTOR_JUMP.2 (IN_2), L1.1, SOURCE_JUMP.2 (IN_2)
PWM_DISCHARGE: ESP.4, R5.1
PWM_IR: D2.A, P_IR.1, P_IR.2, R2.1, R3.1
PWM_MOSFET: ESP.3, P_3V3.1, P_3V3.2, R1.1
PWM_OPTO: IC1.10 (HIN), OK1.3 (EMIT), P_5V.1, P_5V.2, R7.2
TEMP_SENSE: ESP.5, TEMP.2
VB: C1.1, C2.+, D1.C, IC1.6 (VB)
VOLTAGE_SENSE: D7.C, ESP.7, R10.1, R11.2
V_OUT: ACS_INPUTS.1 (IN_1), C3.+, D6.A, INDUCTOR_JUMP.1 (IN_1), L1.2, R13.1, R14.1
V_OUT_FUSE: CURRENT_DMM.1 (IN_1), DC_OUTPUT.2 (IN_2)

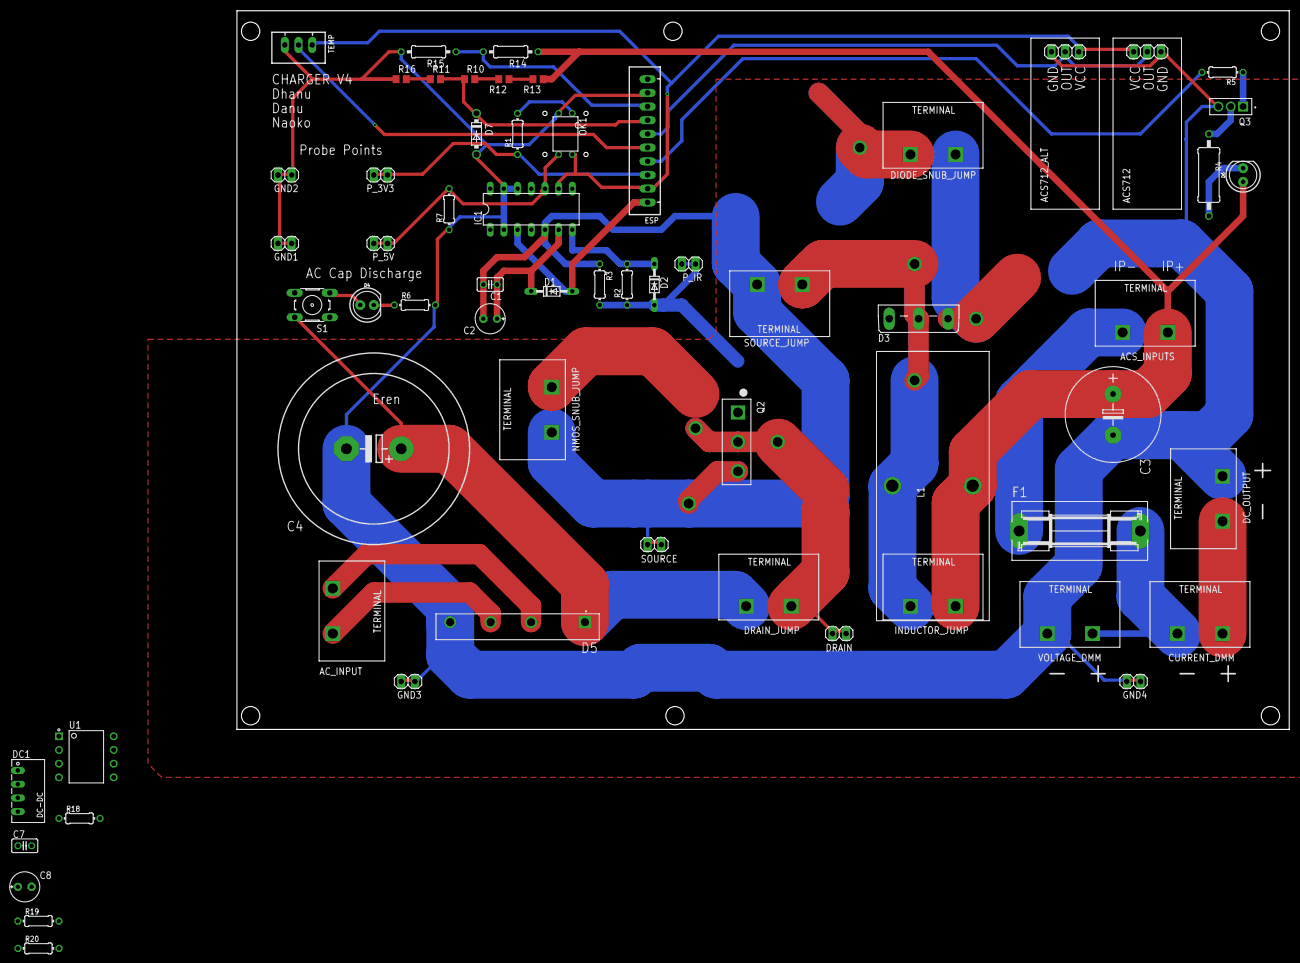
[picture p39: board charger_v4.brd from above]

Board: 2 copper layers, 195.2 x 133.3 mm, 62 parts (0 on the bottom side), 36 nets.
