kevinnaoko/TA-2122024/Eagle/warisan/Driver mosfet v1 4.brd

## EAGLE design Eagle/warisan/Driver mosfet v1 4.brd (2022-06-07)

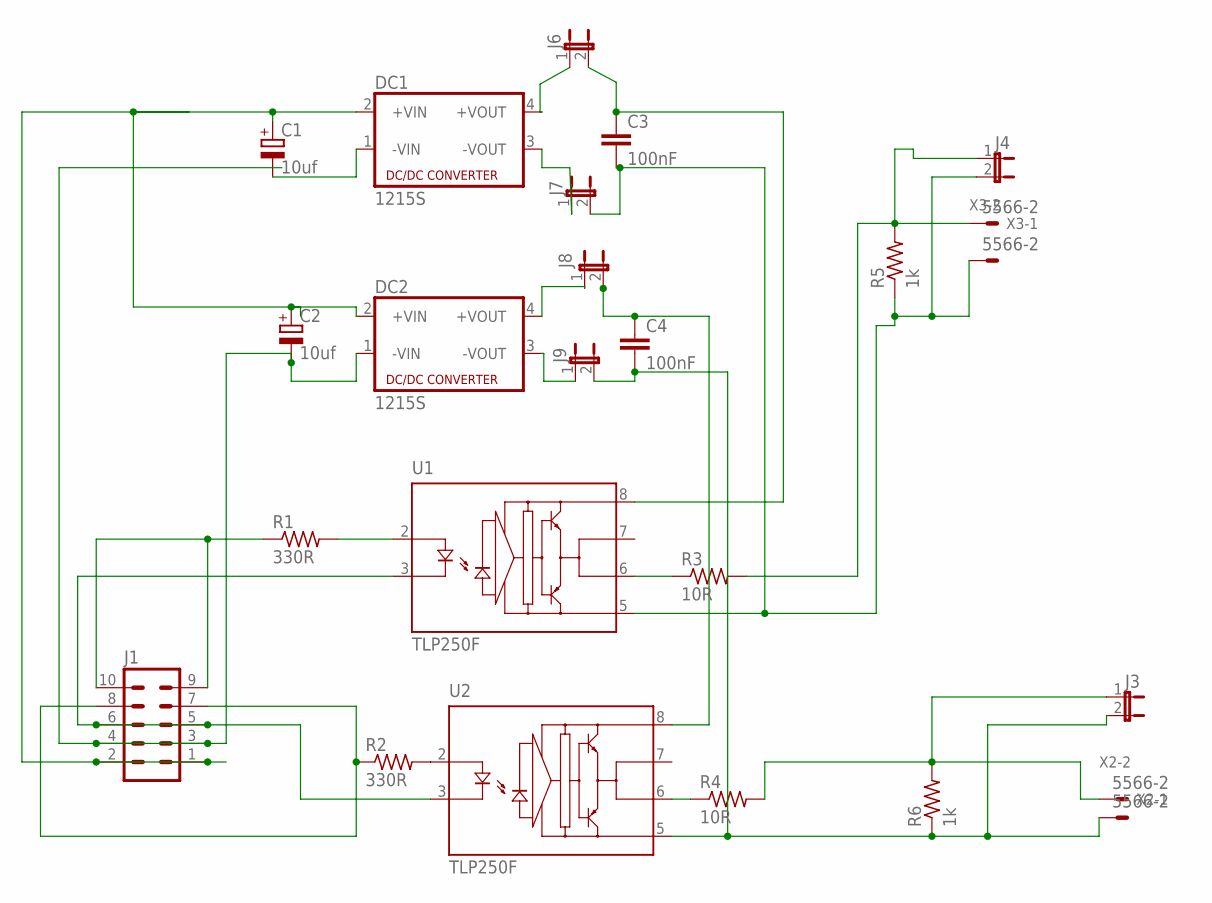
[picture p40: schematic Driver mosfet v1 4.sch]

Parts:
C1, C2: 10uf; E2,5-6
C3, C4: 100nF; C5B3.5
DC1, DC2: 1215S; 4SIL
J1: MA05-2
J3, J4, J6, J7, J8, J9: JP1E; JP1
R1, R2: 330R; 0309/12
R3, R4: 10R; 0309/12
R5, R6: 1k; 0309/12
U1, U2: TLP250F; DIL08
X2, X3: 5566-2

Connections:
unnamed: R2.2, U2.2 (A)
unnamed: C4.1, J8.2, U2.8 (VCC)
unnamed: C1.+, C2.+, DC1.2 (+VIN), DC2.2 (+VIN), J1.1, J1.2
unnamed: R4.1, U2.6 (VO)
unnamed: C3.1, J6.2, U1.8 (VCC)
unnamed: DC1.4 (+VOUT), J6.1
unnamed: R3.1, U1.6 (VO)
unnamed: R1.2, U1.2 (A)
unnamed: J1.9, J1.10, R1.1
unnamed: DC2.4 (+VOUT), J8.1
unnamed: C3.2, J4.2, J7.2, R5.1, U1.5 (GND), X3.2
unnamed: J1.5, J1.6, U1.3 (K), U2.3 (K)
unnamed: J4.1, R3.2, R5.2, X3.1
unnamed: J3.1, R4.2, R6.2, X2.1
unnamed: C4.2, J3.2, J9.2, R6.1, U2.5 (GND), X2.2
unnamed: J1.7, J1.8, R2.1
unnamed: C1.-, C2.-, DC1.1 (-VIN), DC2.1 (-VIN), J1.3, J1.4
unnamed: DC1.3 (-VOUT), J7.1
unnamed: DC2.3 (-VOUT), J9.1

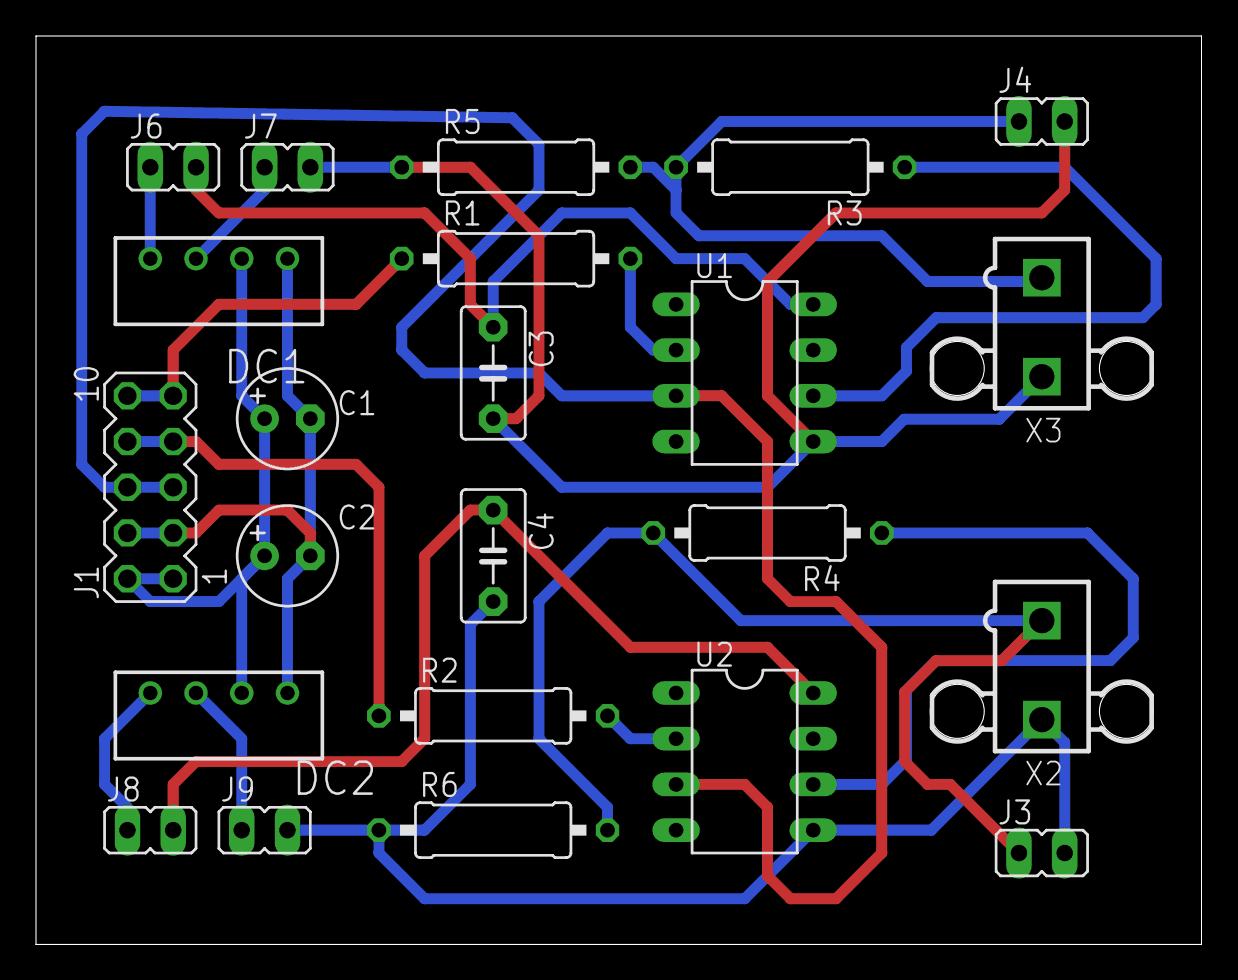
[picture p41: board Driver mosfet v1 4.brd from above]

Board: 2 copper layers, 64.8 x 50.5 mm, 23 parts (0 on the bottom side), 19 nets.
