kevinnaoko/TA-2122024/Eagle/Kontrol v2/kontrol_v2.brd

## EAGLE design Eagle/Kontrol v2/kontrol_v2.brd (2022-05-04)

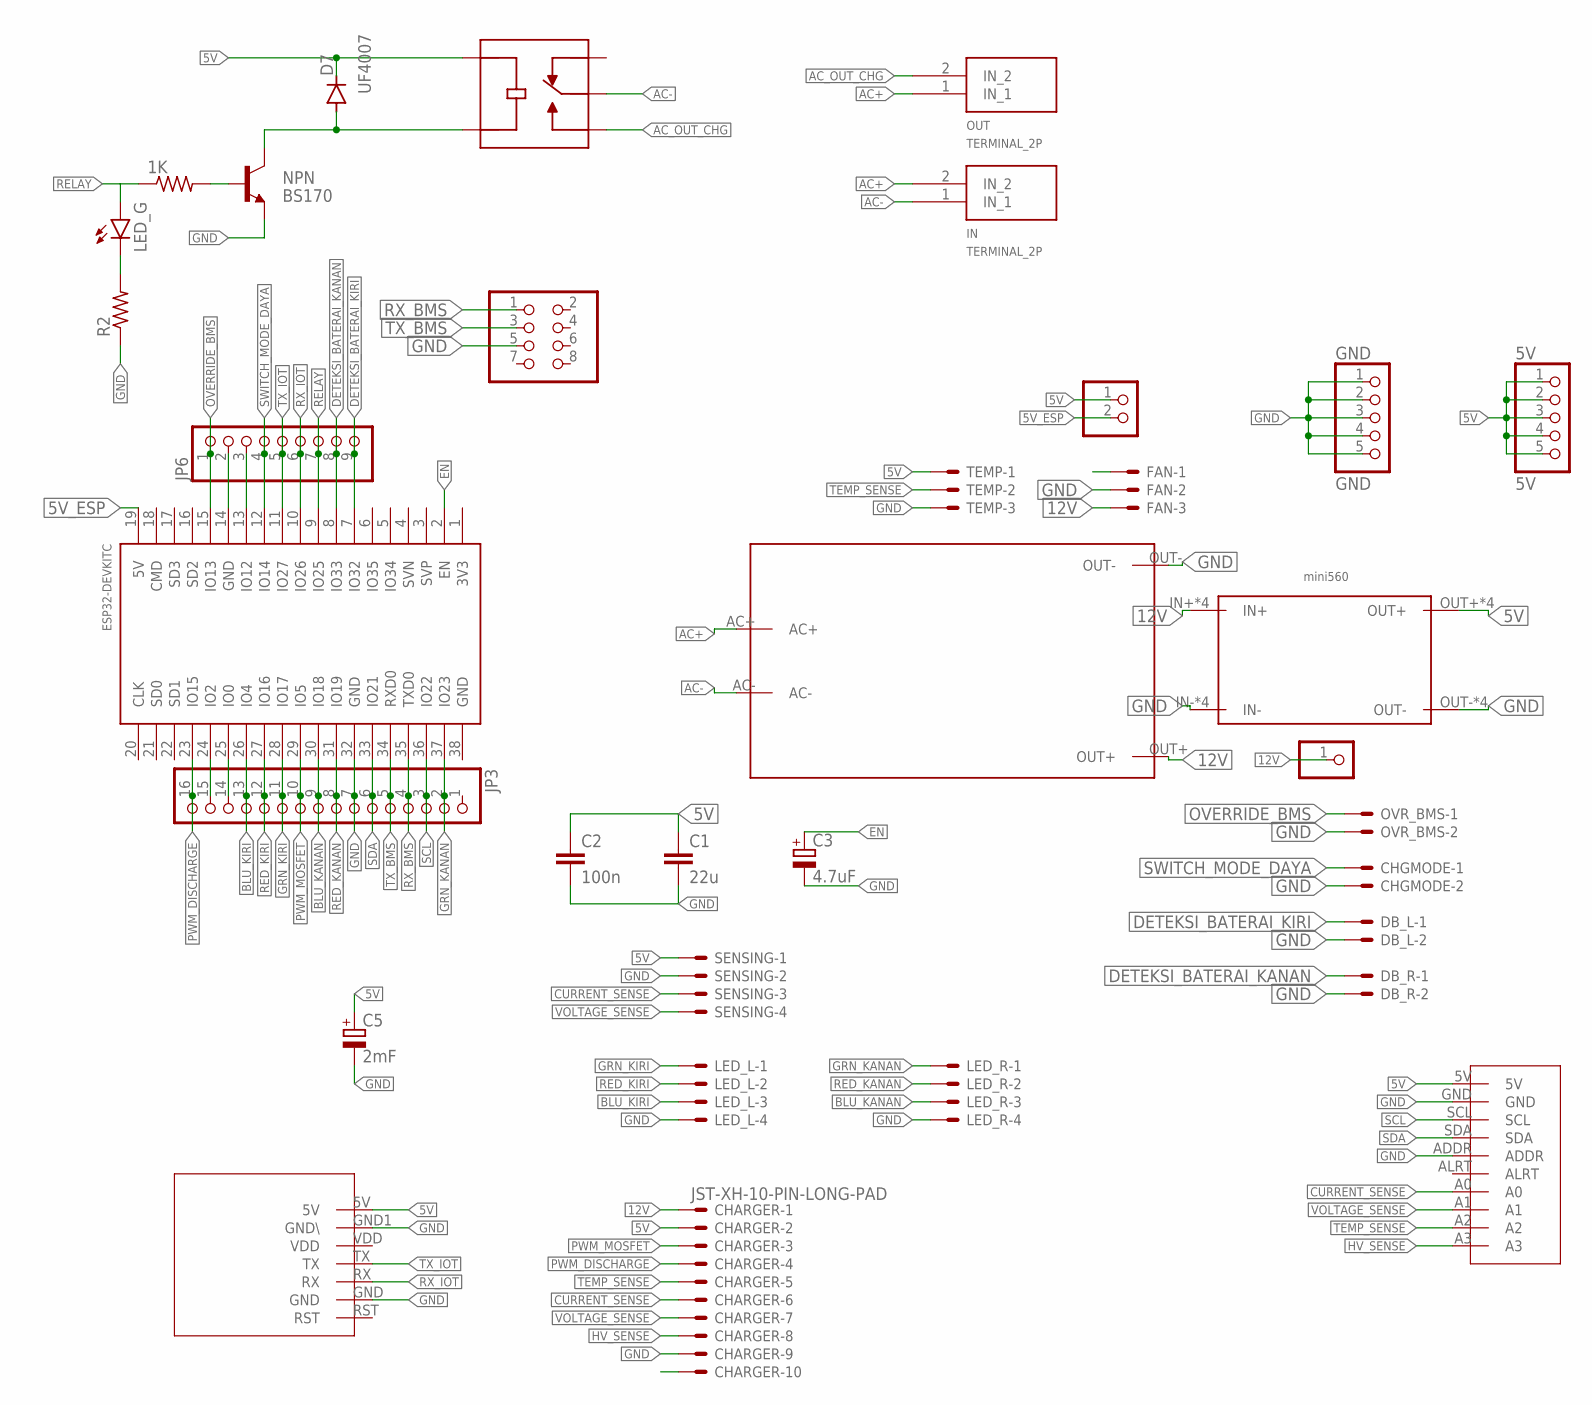
[picture p42: schematic kontrol_v2.sch]

Parts:
1K: 1k; 0204/7
5V: 5V; 1X05
C1: 22u; C2.5-5
C2: 100n; C2.5-6
C3: 4.7uF; E2,5-6E
C5: 2mF; E3,5-10
CHARGER: JST-XH-10-PIN-LONG-PAD; JST-XH-10-PACKAGE-LONG-PAD
CHGMODE: JST-XH-02-PIN-LONG-PAD; JST-XH-02-PACKAGE-LONG-PAD
D4: LED_G; LED_5MM
D7: UF4007; DO34-7
DB_L: JST-XH-02-PIN-LONG-PAD; JST-XH-02-PACKAGE-LONG-PAD
DB_R: JST-XH-02-PIN-LONG-PAD; JST-XH-02-PACKAGE-LONG-PAD
FAN: JST-XH-03-PIN-LONG-PAD; JST-XH-03-PACKAGE-LONG-PAD
GND: GND; 1X05
HI_LINK1: HI_LINK
IN: TERMINAL_2P
JP2: PINHD-2X4; 2X04
JP3: PINHD-1X16; 1X16
JP4: PINHD-1X1; 1X01
JP6: PINHD-1X9; 1X09
JP7: PINHD-1X2; 1X02
K1: SRD-12VDC-SL-C; RELAY_SRD-12VDC-SL-C
LED_L: JST-XH-04-PIN-LONG-PAD; JST-XH-04-PACKAGE-LONG-PAD
LED_R: JST-XH-04-PIN-LONG-PAD; JST-XH-04-PACKAGE-LONG-PAD
MINI1: MINI560
NPN: BS170; TO92-CBE
OUT: TERMINAL_2P
OVR_BMS: JST-XH-02-PIN-LONG-PAD; JST-XH-02-PACKAGE-LONG-PAD
R2: 6k; 0204/7
SENSING: JST-XH-04-PIN-LONG-PAD; JST-XH-04-PACKAGE-LONG-PAD
TEMP: JST-XH-03-PIN-LONG-PAD; JST-XH-03-PACKAGE-LONG-PAD
U$1: ESP32DEVKITC; ESP32-DEVKITC
U$2: ADS1115
U$3: SIM800V2

Connections:
5V: 5V.1, 5V.2, 5V.3, 5V.4, 5V.5, C1.1, C2.1, C5.+, CHARGER.2, D7.C, JP7.1, K1.COIL1, MINI1.OUT+, MINI1.OUT+1 (OUT+), MINI1.OUT+2 (OUT+), MINI1.OUT+3 (OUT+), SENSING.1, TEMP.1, U$2.5V, U$3.5V
5V_ESP: JP7.2, U$1.19 (5V)
12V: CHARGER.1, FAN.3, HI_LINK1.OUT+, JP4.1, MINI1.IN+, MINI1.IN+1 (IN+), MINI1.IN+2 (IN+), MINI1.IN+3 (IN+)
AC+: HI_LINK1.AC+, IN.2 (IN_2), OUT.1 (IN_1)
AC-: HI_LINK1.AC-, IN.1 (IN_1), K1.COM
AC_OUT_CHG: K1.NO, OUT.2 (IN_2)
BLU_KANAN: JP3.9, LED_R.3, U$1.30 (IO18)
BLU_KIRI: JP3.13, LED_L.3, U$1.26 (IO4)
CURRENT_SENSE: CHARGER.6, SENSING.3, U$2.A0
DETEKSI_BATERAI_KANAN: DB_R.1, JP6.8, U$1.8 (IO33)
DETEKSI_BATERAI_KIRI: DB_L.1, JP6.9, U$1.7 (IO32)
EN: C3.+, U$1.2 (EN)
GND: C1.2, C2.2, C3.-, C5.-, CHARGER.9, CHGMODE.2, DB_L.2, DB_R.2, FAN.2, GND.1, GND.2, GND.3, GND.4, GND.5, HI_LINK1.OUT-, JP2.5, JP3.7, LED_L.4, LED_R.4, MINI1.IN-, MINI1.IN-1 (IN-), MINI1.IN-2 (IN-), MINI1.IN-3 (IN-), MINI1.OUT-, MINI1.OUT-1 (OUT-), MINI1.OUT-2 (OUT-), MINI1.OUT-3 (OUT-), NPN.E, OVR_BMS.2, R2.1, SENSING.2, TEMP.3, U$1.32 (GND), U$2.ADDR, U$2.GND, U$3.GND, U$3.GND1 (GND\)
GRN_KANAN: JP3.2, LED_R.1, U$1.37 (IO23)
GRN_KIRI: JP3.11, LED_L.1, U$1.28 (IO17)
HV_SENSE: CHARGER.8, U$2.A3
unnamed: D4.K (C), R2.2
unnamed: JP6.2, U$1.14 (GND)
unnamed: JP6.3, U$1.13 (IO12)
unnamed: 1K.2, NPN.B
unnamed: D7.A, K1.COIL2, NPN.C
unnamed: JP3.14, U$1.25 (IO0)
unnamed: JP3.15, U$1.24 (IO2)
OVERRIDE_BMS: JP6.1, OVR_BMS.1, U$1.15 (IO13)
PWM_DISCHARGE: CHARGER.4, JP3.16, U$1.23 (IO15)
PWM_MOSFET: CHARGER.3, JP3.10, U$1.29 (IO5)
RED_KANAN: JP3.8, LED_R.2, U$1.31 (IO19)
RED_KIRI: JP3.12, LED_L.2, U$1.27 (IO16)
RELAY: 1K.1, D4.A, JP6.7, U$1.9 (IO25)
RX_BMS: JP2.1, JP3.4, U$1.35 (TXD0)
RX_IOT: JP6.6, U$1.10 (IO26), U$3.RX
SCL: JP3.3, U$1.36 (IO22), U$2.SCL
SDA: JP3.6, U$1.33 (IO21), U$2.SDA
SWITCH_MODE_DAYA: CHGMODE.1, JP6.4, U$1.12 (IO14)
TEMP_SENSE: CHARGER.5, TEMP.2, U$2.A2
TX_BMS: JP2.3, JP3.5, U$1.34 (RXD0)
TX_IOT: JP6.5, U$1.11 (IO27), U$3.TX
VOLTAGE_SENSE: CHARGER.7, SENSING.4, U$2.A1

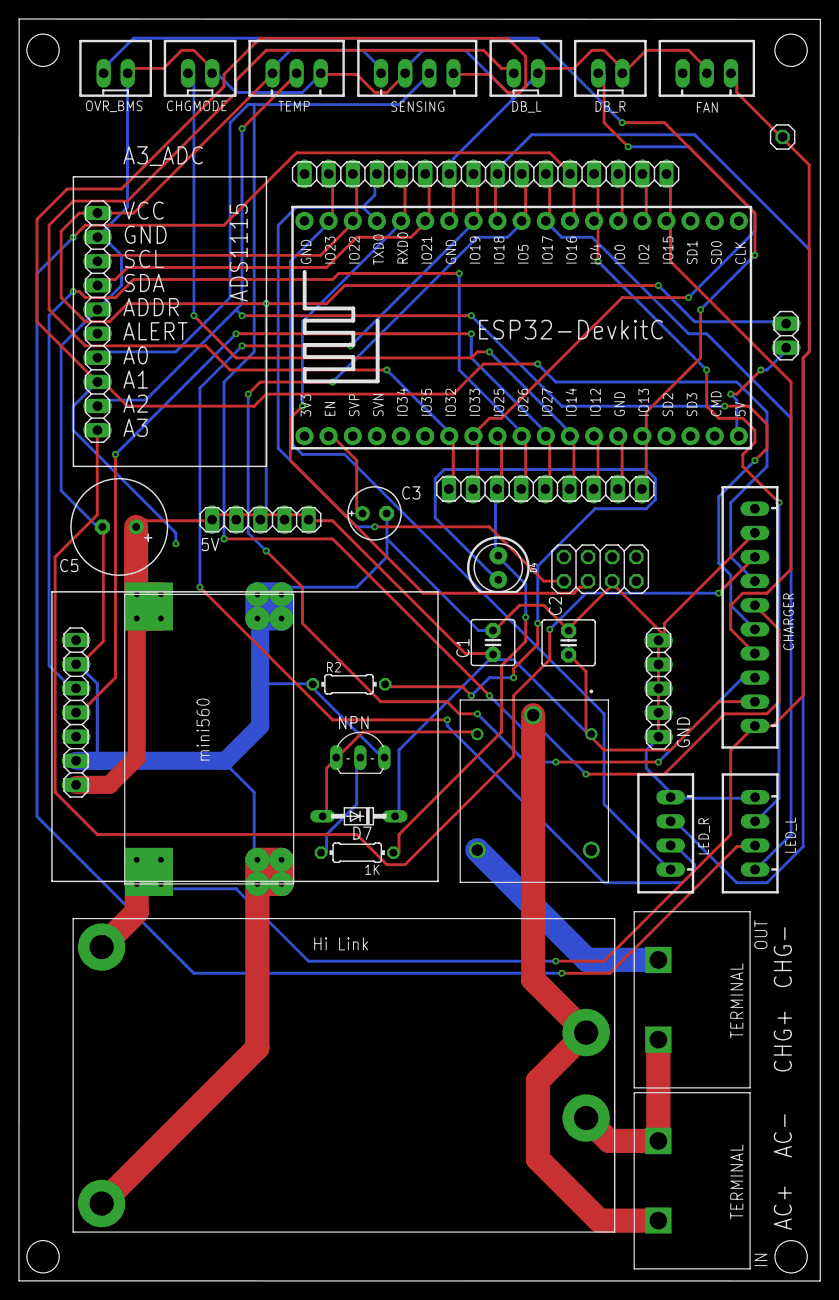
[picture p43: board kontrol_v2.brd from above]

Board: 2 copper layers, 84.3 x 132.8 mm, 34 parts (0 on the bottom side), 38 nets.
