kevinnaoko/TA-2122024/Eagle/charger board v3.1 (untuk tanya)/charger_v3.1.brd

## EAGLE design Eagle/charger board v3.1 (untuk tanya)/charger_v3.1.brd (2022-04-25)

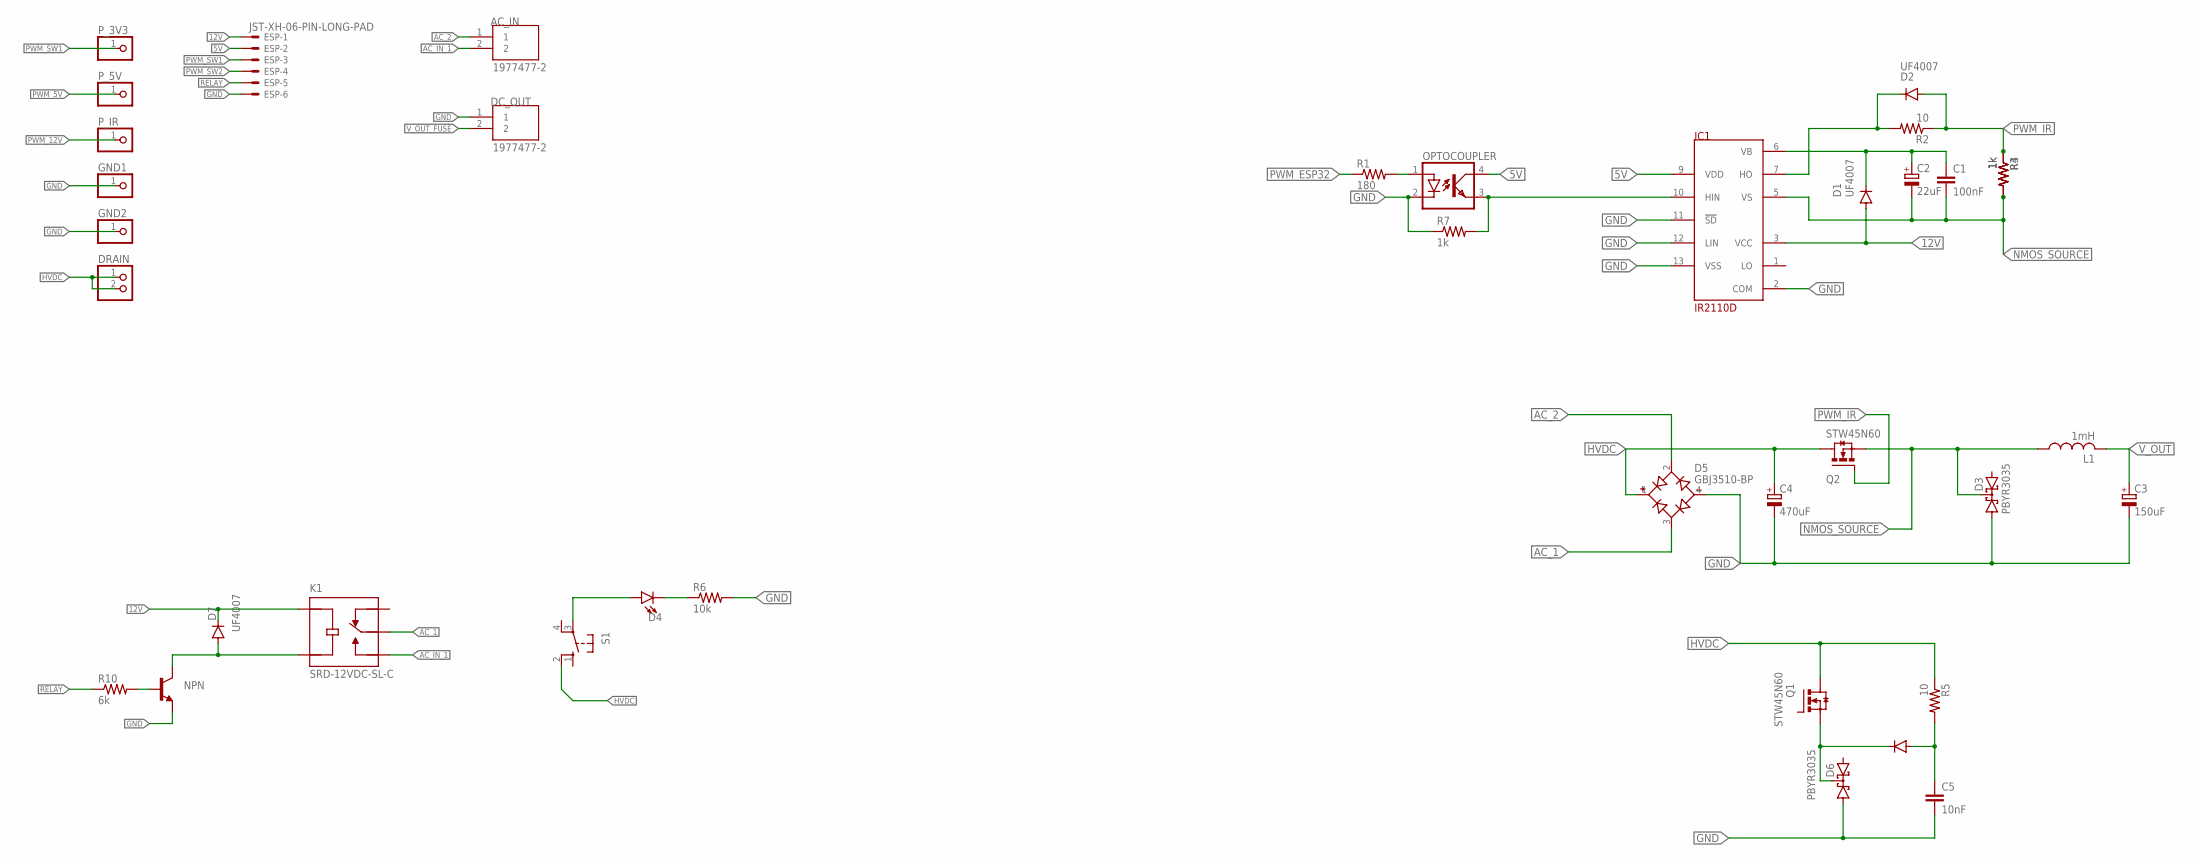
[picture p44: schematic charger_v3.1.sch]

Parts:
AC_IN: 1977477-2; TE_1977477-2
C1: 100nF; C025-025X050
C2: 22uF; E2,5-6E
C3: 150uF; E7,5-18
C4: 470uF; EB35D
C5: 10nF; C025-025X050
D1, D2, D7: UF4007; DO34-7
D3, D6: PBYR3035; SOT93S
D4: LED5MM; LED_5MM
D5: GBJ3510-BP; DIOB_GBJ3510-BP
D8: 1N4148DO35-7; DO35-7
DC_OUT: 1977477-2; TE_1977477-2
DRAIN: PINHD-1X2; 1X02
ESP: JST-XH-06-PIN-LONG-PAD; JST-XH-06-PACKAGE-LONG-PAD
GND1, GND2: PINHD-1X1; 1X01
IC1: IR2110D; DIL14
K1: SRD-12VDC-SL-C; RELAY_SRD-12VDC-SL-C
L1: 1mH; TJ7-U1
NPN: BC547A-NPN-TO92-CBE; TO92-CBE
OPTOCOUPLER: SFH618A-5; DIP4
P_3V3, P_5V: PINHD-1X1; 1X01
P_IR: PINHD-1X1; 1X01
Q1, Q2: STW45N60; TO247AC
R1: 180; 0204/7
R2, R5: 10; 0204/7
R3, R4, R7: 1k; 0204/7
R6: 10k; 0204/7
R10: 6k; 0204/7
S1: 10-XX; B3F-10XX

Connections:
5V: ESP.2, IC1.9 (VDD), OPTOCOUPLER.4 (COL)
12V: D1.A, D7.C, ESP.1, IC1.3 (VCC), K1.COIL1
AC_1: D5.3 (AC2), K1.COM
AC_2: AC_IN.1, D5.2 (AC1)
AC_IN_1: AC_IN.2, K1.NO
GND: C3.-, C4.-, D3.A1, D5.4 (-), DC_OUT.1, ESP.6, GND1.1, GND2.1, IC1.2 (COM), IC1.11 (!SD), IC1.12 (LIN), IC1.13 (VSS), NPN.E, OPTOCOUPLER.2 (C), R6.2, R7.1
HVDC: C4.+, D5.1 (+), DRAIN.1, DRAIN.2, Q2.2 (D), S1.2 (S1)
unnamed: D2.C, IC1.7 (HO), R2.2
unnamed: D4.A, S1.3
unnamed: C5.2, D6.A1
unnamed: D6.C, D8.C, Q1.3 (S)
unnamed: Q1.2 (D), R5.1
unnamed: C5.1, D8.A, R5.2
unnamed: D4.K (C), R6.1
unnamed: OPTOCOUPLER.1 (A), R1.2
unnamed: NPN.B, R10.2
unnamed: D7.A, K1.COIL2, NPN.C
NMOS_SOURCE: C1.2, C2.-, D3.C, IC1.5 (VS), L1.1, Q2.3 (S), R3.2, R4.2
PWM_5V: IC1.10 (HIN), OPTOCOUPLER.3 (EMIT), P_5V.1, R7.2
PWM_12V: P_IR.1
PWM_ESP32: R1.1
PWM_IR: D2.A, Q2.1 (G), R2.1, R3.1, R4.1
PWM_SW1: ESP.3, P_3V3.1
PWM_SW2: ESP.4
RELAY: ESP.5, R10.1
VB: C1.1, C2.+, D1.C, IC1.6 (VB)
V_OUT: C3.+, L1.2
V_OUT_FUSE: DC_OUT.2

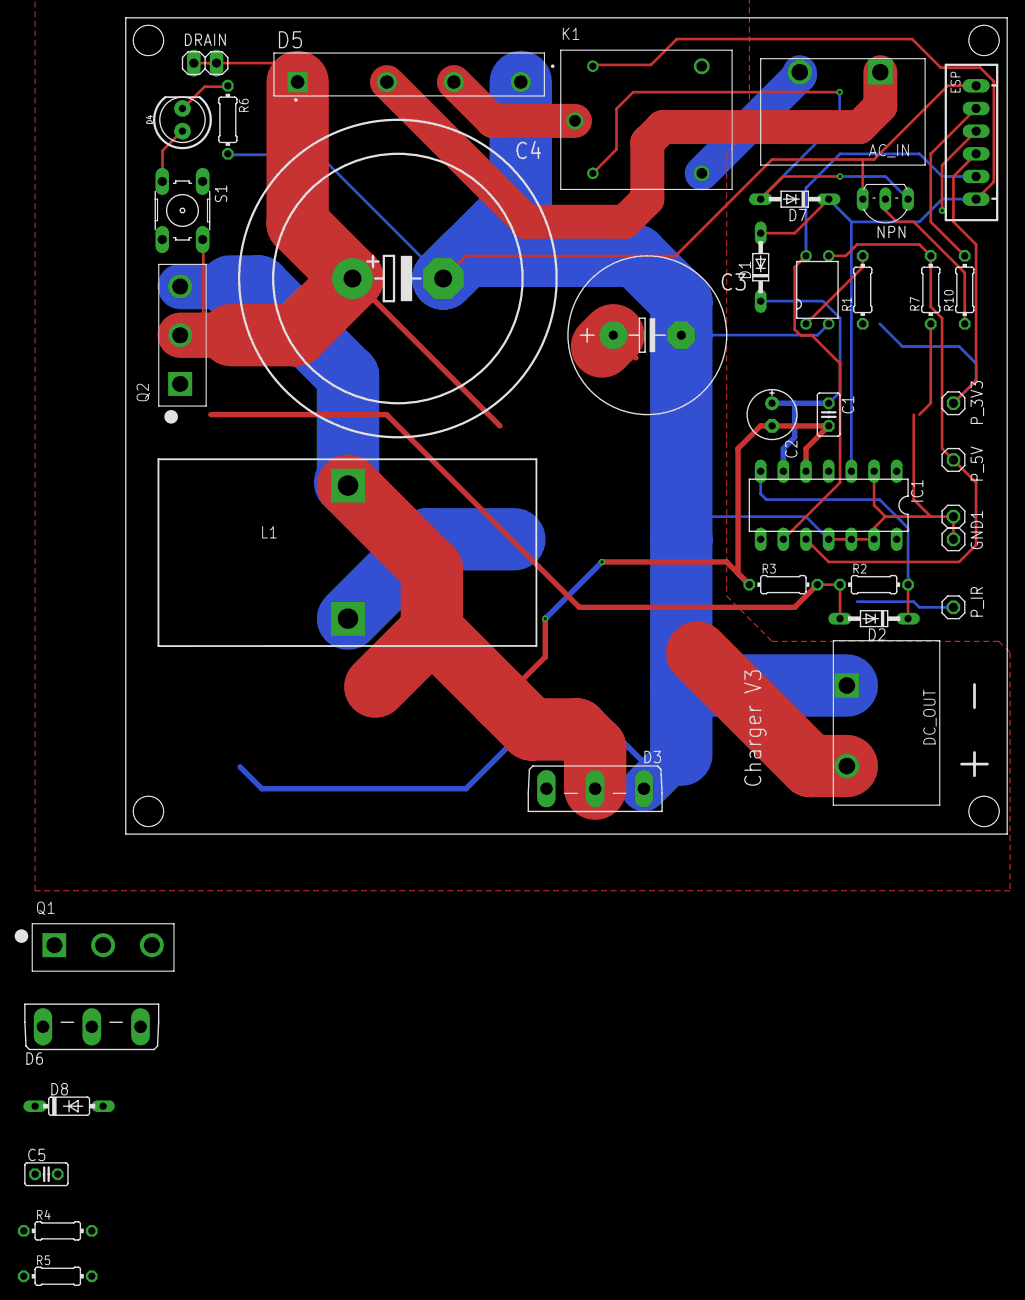
[picture p45: board charger_v3.1.brd from above]

Board: 2 copper layers, 98.7 x 91.4 mm, 38 parts (0 on the bottom side), 24 nets.
