kevinnaoko/TA-2122024/Eagle/charger board v3.1 (untuk tanya)/preroute/charger_v3.brd

## EAGLE design Eagle/charger board v3.1 (untuk tanya)/preroute/charger_v3.brd (2022-03-31)

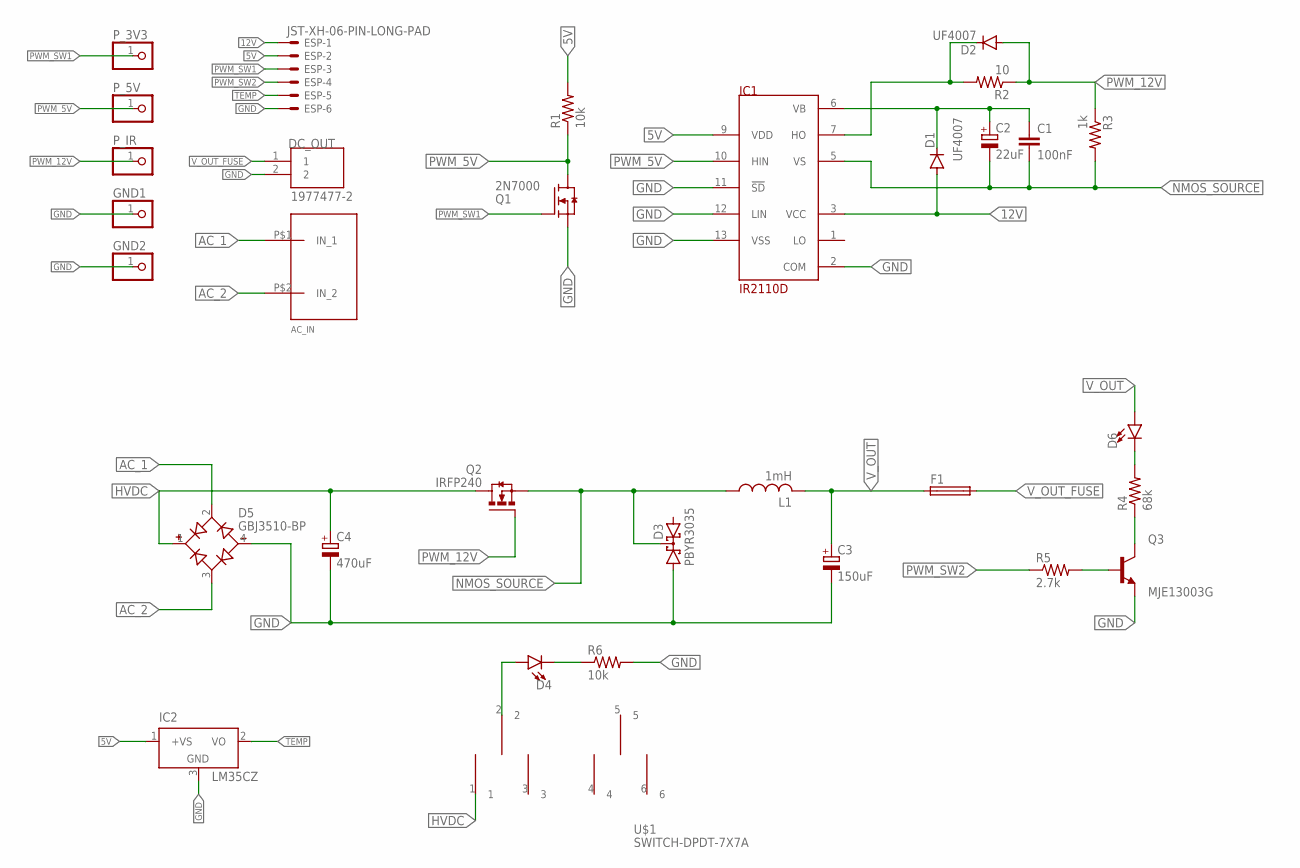
[picture p46: schematic charger_v3.sch]

Parts:
AC_IN: XT90A; XT90-PAD
C1: 100nF; C025-025X050
C2: 22uF; E2,5-6E
C3: 150uF; E7,5-18
C4: 470uF; EB35D
D1, D2: UF4007; DO34-7
D3: PBYR3035; SOT93S
D4, D6: LED5MM; LED_5MM
D5: GBJ3510-BP; DIOB_GBJ3510-BP
DC_OUT: 1977477-2; TE_1977477-2
ESP: JST-XH-06-PIN-LONG-PAD; JST-XH-06-PACKAGE-LONG-PAD
F1: SH25
GND1, GND2: PINHD-1X1; 1X01
IC1: IR2110D; DIL14
IC2: LM35CZ; TO92
L1: 1mH; TJ7-U1
P_3V3, P_5V: PINHD-1X1; 1X01
P_IR: PINHD-1X1; 1X01
Q1: 2N7000; TO92
Q2: IRFP240; TO247AC
Q3: MJE13003G; TO229P780X300X1364-3
R1, R6: 10k; 0204/7
R2: 10; 0204/7
R3: 1k; 0204/7
R4: 68k; 0309/12
R5: 2.7k; 0204/7
U$1: SWITCH-DPDT-7X7A; TL-2230

Connections:
5V: ESP.2, IC1.9 (VDD), IC2.1 (+VS), R1.2
12V: D1.A, ESP.1, IC1.3 (VCC)
AC_1: AC_IN.P$1 (IN_1), D5.2 (AC1)
AC_2: AC_IN.P$2 (IN_2), D5.3 (AC2)
GND: C3.-, C4.-, D3.A1, D5.4 (-), DC_OUT.2, ESP.6, GND1.1, GND2.1, IC1.2 (COM), IC1.11 (!SD), IC1.12 (LIN), IC1.13 (VSS), IC2.3 (GND), Q1.1 (S), Q3.3 (E), R6.2
HVDC: C4.+, D5.1 (+), Q2.2 (D), U$1.1
unnamed: D2.C, IC1.7 (HO), R2.2
unnamed: D4.A, U$1.2
unnamed: Q3.2 (C), R4.1
unnamed: D6.K (C), R4.2
unnamed: Q3.1 (B), R5.2
unnamed: D4.K (C), R6.1
NMOS_SOURCE: C1.2, C2.-, D3.C, IC1.5 (VS), L1.1, Q2.3 (S), R3.2
PWM_5V: IC1.10 (HIN), P_5V.1, Q1.3 (D), R1.1
PWM_12V: D2.A, P_IR.1, Q2.1 (G), R2.1, R3.1
PWM_SW1: ESP.3, P_3V3.1, Q1.2 (G)
PWM_SW2: ESP.4, R5.1
TEMP: ESP.5, IC2.2 (VO)
VB: C1.1, C2.+, D1.C, IC1.6 (VB)
V_OUT: C3.+, D6.A, F1.1, L1.2
V_OUT_FUSE: DC_OUT.1, F1.2
