kevinnaoko/TA-2122024/Eagle/charger board v3.1 (untuk tanya)/preroute/charger_v3.brd

## EAGLE design Eagle/charger board v3.1 (untuk tanya)/preroute/charger_v3.brd (continued)

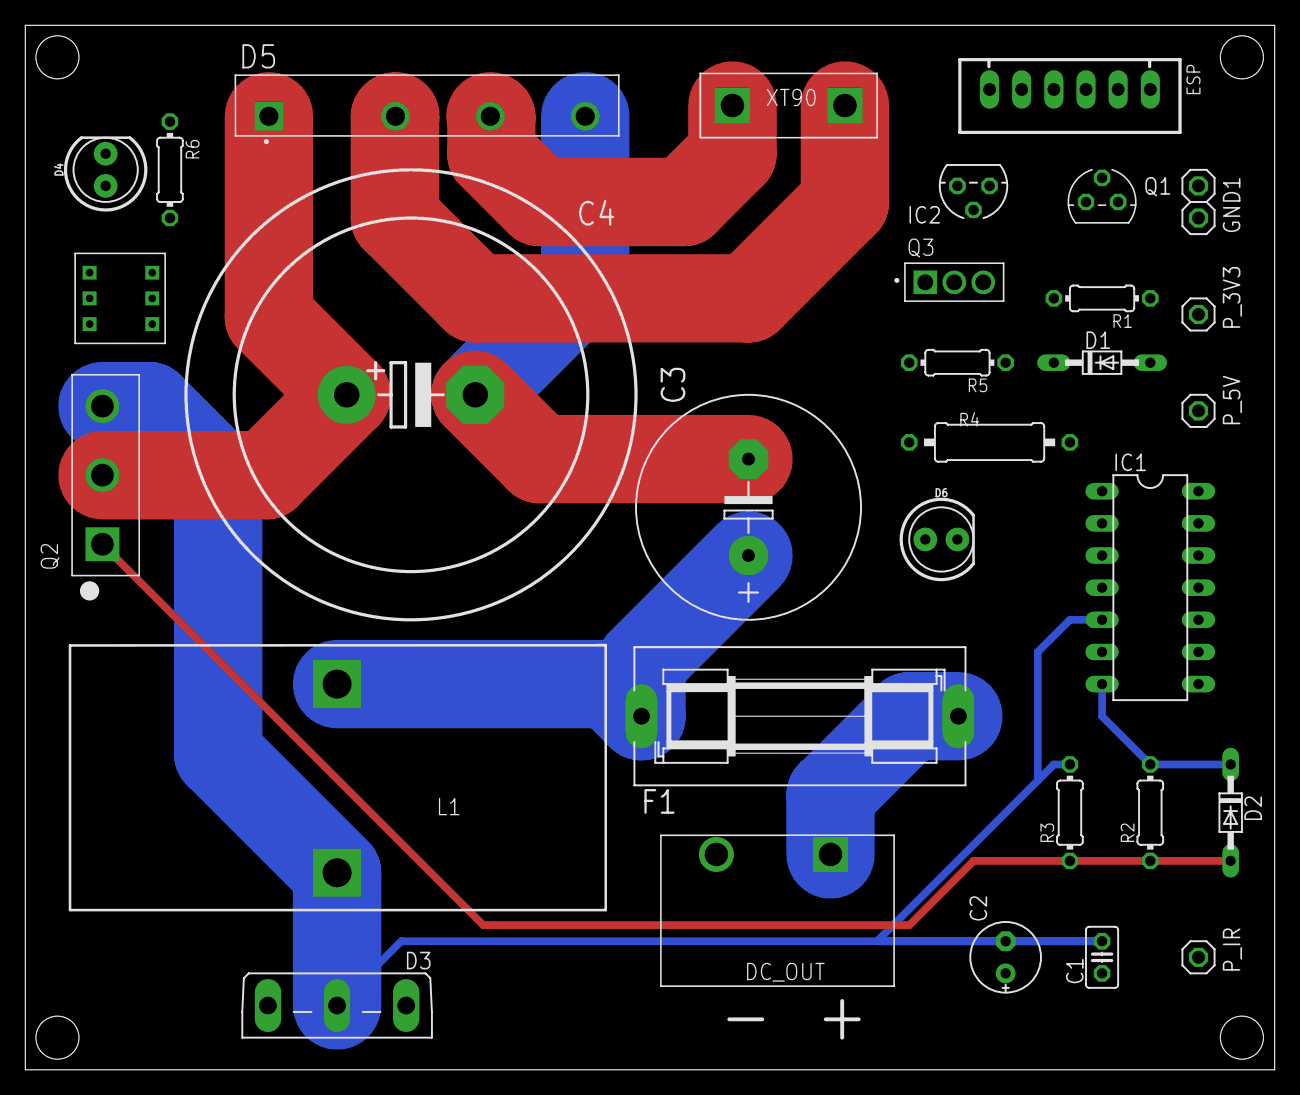
[picture p47: board charger_v3.brd from above]

Board: 2 copper layers, 98.7 x 82.5 mm, 32 parts (0 on the bottom side), 21 nets.
