kevinnaoko/TA-2122024/Eagle/sampling v2/sampling.brd

## EAGLE design Eagle/sampling v2/sampling.brd (2022-04-06)

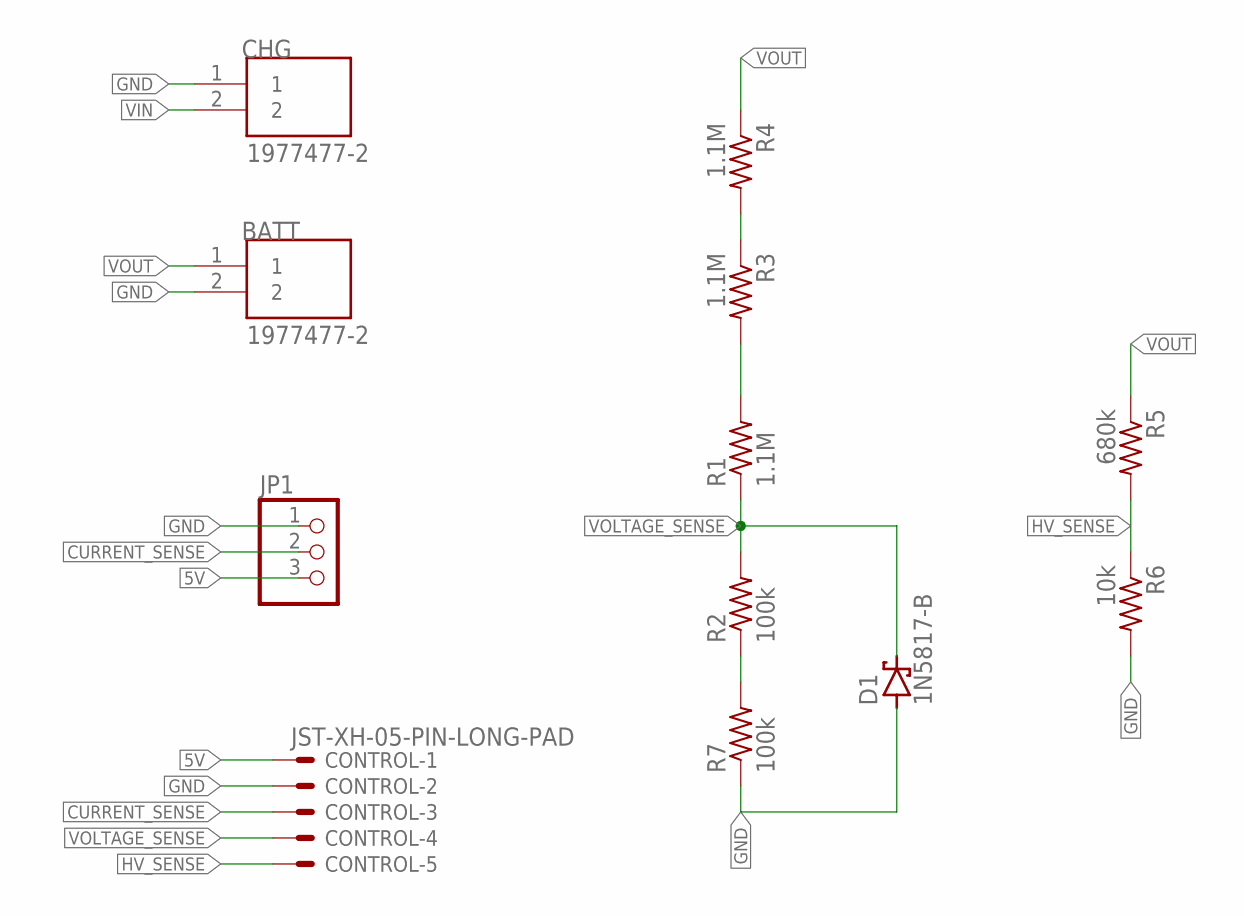
[picture p48: schematic sampling.sch]

Parts:
BATT: 1977477-2; TE_1977477-2
CHG: 1977477-2; TE_1977477-2
CONTROL: JST-XH-05-PIN-LONG-PAD; JST-XH-05-PACKAGE-LONG-PAD
D1: 1N5817-B; DO41-7.6
JP1: PINHD-1X3; 1X03
R1, R3, R4: 1.1M; R0805
R2, R7: 100k; R0805
R5: 680k; 0207/10
R6: 10k; 0207/10

Connections:
5V: CONTROL.1, JP1.3
CURRENT_SENSE: CONTROL.3, JP1.2
GND: BATT.2, CHG.1, CONTROL.2, D1.A, JP1.1, R6.2, R7.1
HV_SENSE: CONTROL.5, R5.2, R6.1
unnamed: R1.2, R3.2
unnamed: R3.1, R4.2
unnamed: R2.1, R7.2
VIN: CHG.2
VOLTAGE_SENSE: CONTROL.4, D1.C, R1.1, R2.2
VOUT: BATT.1, R4.1, R5.1

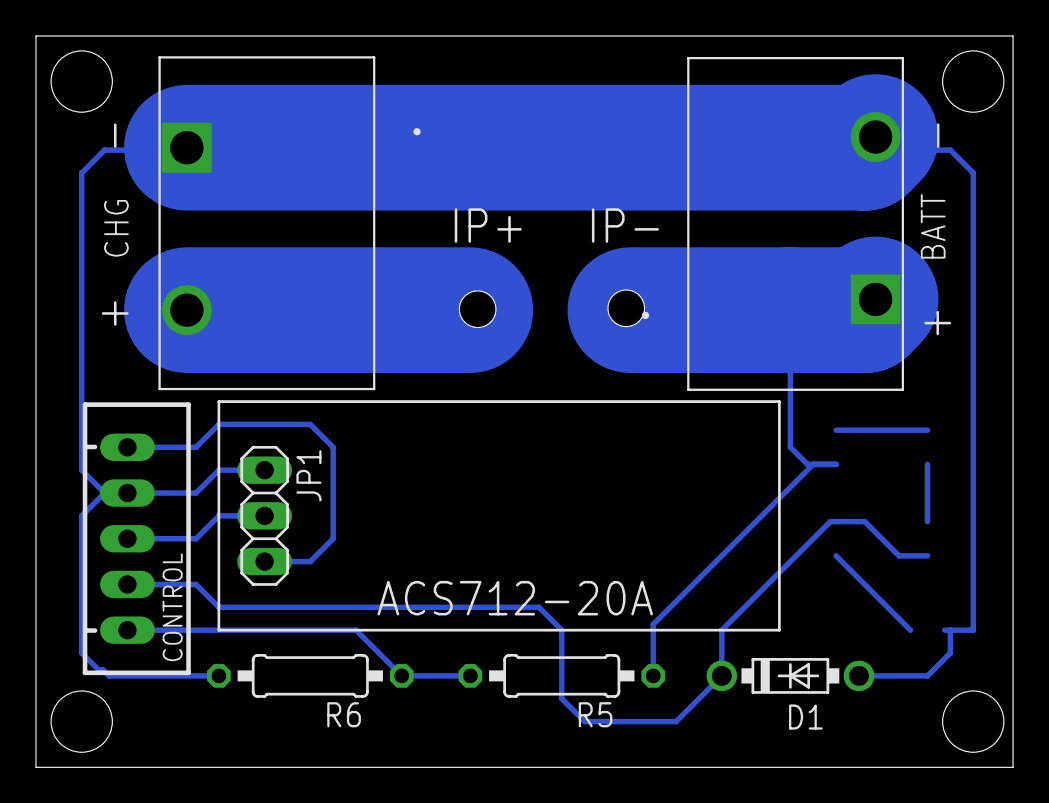
[picture p49: board sampling.brd from above]

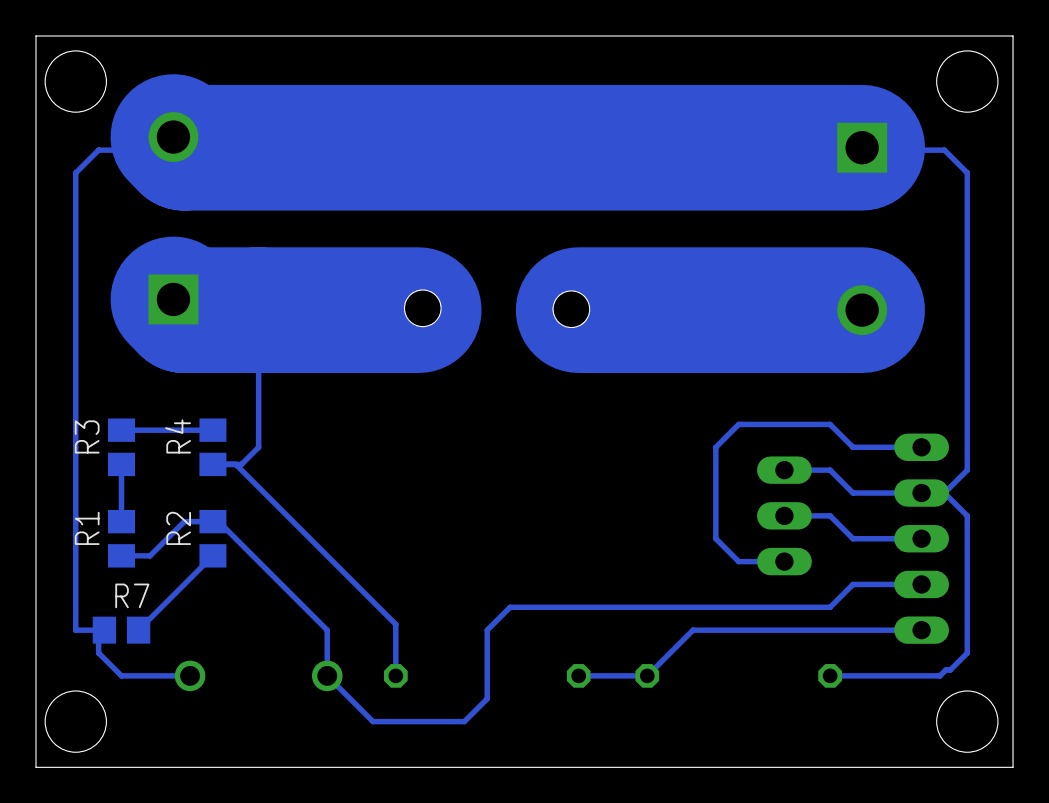
[picture p50: board sampling.brd from below]

Board: 2 copper layers, 54.3 x 40.6 mm, 12 parts (5 on the bottom side), 9 nets.
