kevinnaoko/TA-2122024/Eagle/charger board (no mje, lm35)/charger.brd

## EAGLE design Eagle/charger board (no mje, lm35)/charger.brd (2022-03-31)

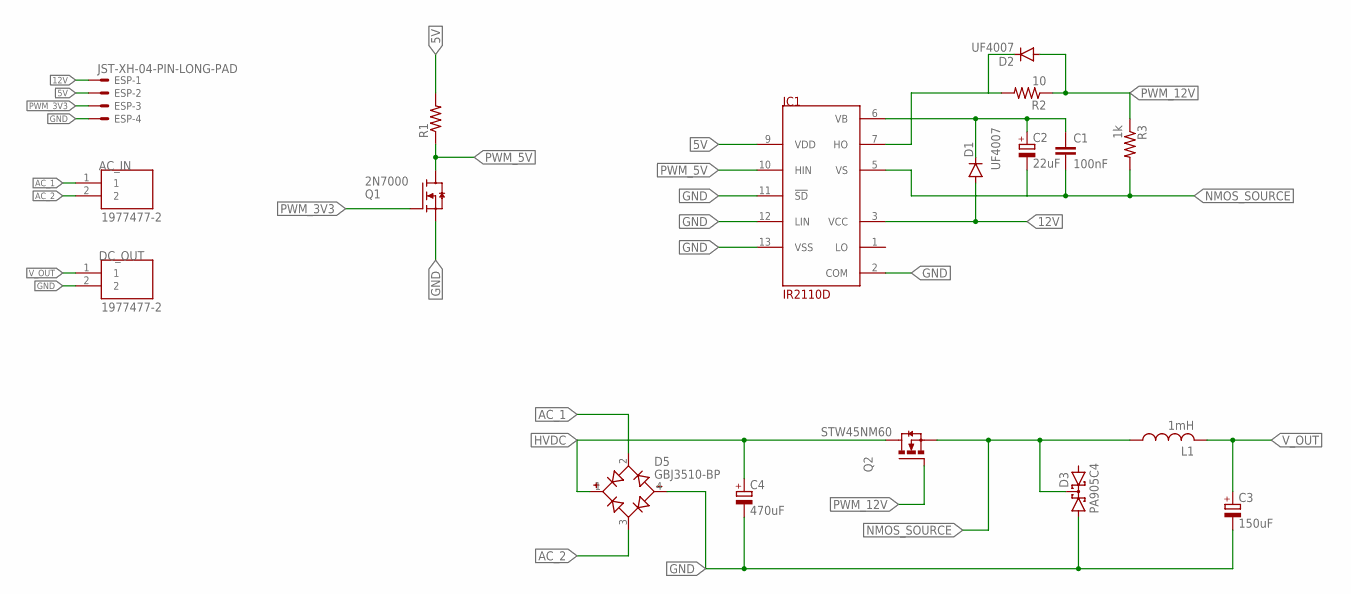
[picture p51: schematic charger.sch]

Parts:
AC_IN: 1977477-2; TE_1977477-2
C1: 100nF; C025-025X050
C2: 22uF; E2,5-6E
C3: 150uF; E7,5-18
C4: 470uF; EB35D
D1, D2: UF4007; DO34-7
D3: PA905C4; SOT93S
D5: GBJ3510-BP; DIOB_GBJ3510-BP
DC_OUT: 1977477-2; TE_1977477-2
ESP: JST-XH-04-PIN-LONG-PAD; JST-XH-04-PACKAGE-LONG-PAD
IC1: IR2110D; DIL14
L1: 1mH; TJ7-U1
Q1: 2N7000; TO92
Q2: STW45NM60; TO247AC
R1: R-US_0204/7; 0204/7
R2: 10; 0204/7
R3: 1k; 0204/7

Connections:
5V: ESP.2, IC1.9 (VDD), R1.2
12V: D1.A, ESP.1, IC1.3 (VCC)
AC_1: AC_IN.1, D5.2 (AC1)
AC_2: AC_IN.2, D5.3 (AC2)
GND: C3.-, C4.-, D3.A1, D5.4 (-), DC_OUT.2, ESP.4, IC1.2 (COM), IC1.11 (!SD), IC1.12 (LIN), IC1.13 (VSS), Q1.1 (S)
HVDC: C4.+, D5.1 (+), Q2.2 (D)
unnamed: D2.C, IC1.7 (HO), R2.2
NMOS_SOURCE: C1.2, C2.-, D3.C, IC1.5 (VS), L1.1, Q2.3 (S), R3.2
PWM_3V3: ESP.3, Q1.2 (G)
PWM_5V: IC1.10 (HIN), Q1.3 (D), R1.1
PWM_12V: D2.A, Q2.1 (G), R2.1, R3.1
VB: C1.1, C2.+, D1.C, IC1.6 (VB)
V_OUT: C3.+, DC_OUT.1, L1.2

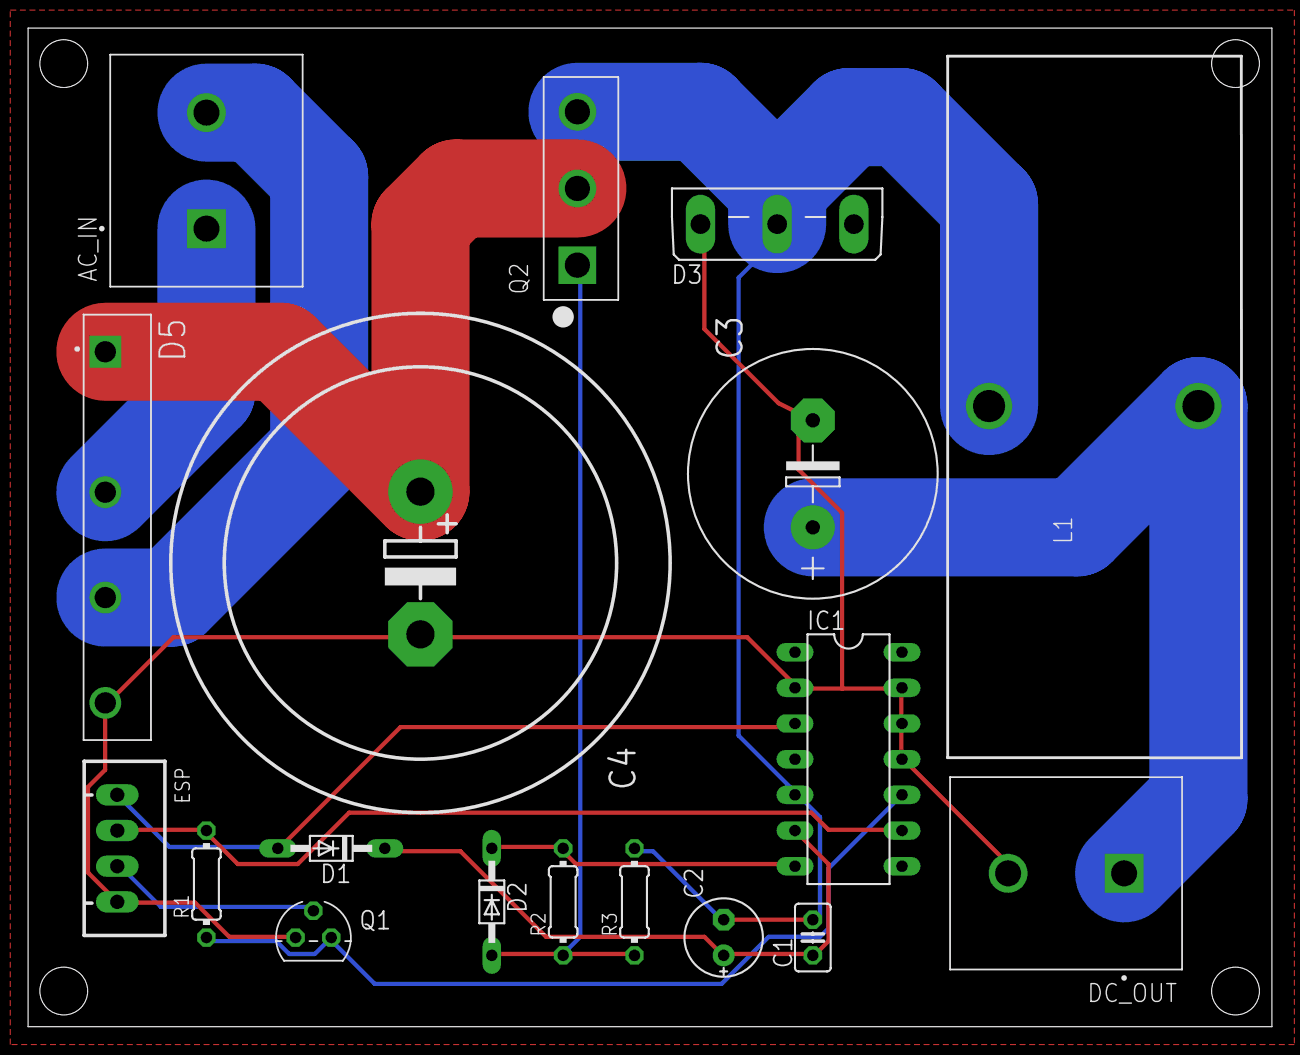
[picture p52: board charger.brd from above]

Board: 2 copper layers, 88.6 x 71.1 mm, 18 parts (0 on the bottom side), 13 nets.
