kevinnaoko/TA-2122024/Eagle/LED indicator/LED_Indicator.brd

## EAGLE design Eagle/LED indicator/LED_Indicator.brd (2022-03-31)

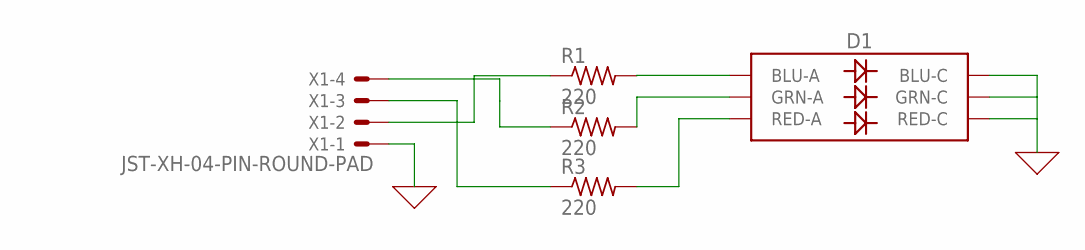
[picture p55: schematic LED_Indicator.sch]

Parts:
D1: LED-RGBBRG; LED-TRICOLOR-5050
R1, R2, R3: 220; R1206
X1: JST-XH-04-PIN-ROUND-PAD; JST-XH-04-PACKAGE-ROUND-PAD

Connections:
0: D1.1 (BLU-C), D1.2 (RED-C), D1.3 (GRN-C), X1.1
unnamed: D1.6 (BLU-A), R1.2
unnamed: D1.4 (GRN-A), R2.2
unnamed: D1.5 (RED-A), R3.2
unnamed: R1.1, X1.2
unnamed: R2.1, X1.4
unnamed: R3.1, X1.3

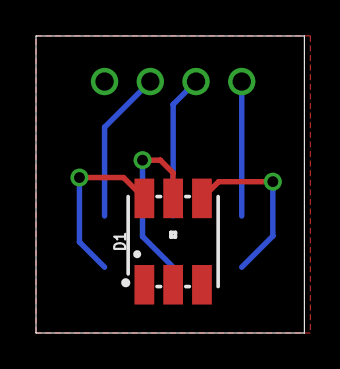
[picture p56: board LED_Indicator.brd from above]

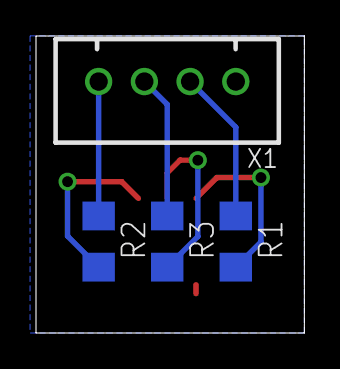
[picture p57: board LED_Indicator.brd from below]

Board: 2 copper layers, 14.9 x 16.5 mm, 5 parts (4 on the bottom side), 7 nets.
