kevinnaoko/TA-2122024/Source Code/B500_V2.1/B500_V2.1.ino

/*  Filename: ??
 *  Description: Program for Control, IoT, and Sensing Subsystem
 *  Contributors:
 *    Danu Ihza Pamungkas
 *    Dhanurangga Al Fadh
 *    Kevin Naoko
 */ 
#include <EEPROM.h>
#define EEPROM_SIZE 1

#define DEMO 0                // 1 = true, 0 = false
// #define NOT_DEMO
#define TINY_GSM_MODEM_SIM800 // Modem is SIM800L 

// Pilih salah satu 
//#define NETWORK_WIFI 
#define NETWORK_GPRS
 
#include <WiFi.h> 
//#include <SoftwareSerial.h>
//SoftwareSerial Sim800l(26, 27);
#include <TinyGsmClient.h>  // Untuk GSM
#include <PubSubClient.h> // Untuk Wifi

// Library for ADS1115
#include <Wire.h>
#include <Adafruit_ADS1X15.h>

#define RELAY_ACTIVE_HIGH
#ifdef RELAY_ACTIVE_HIGH
    #define RELAY_ON 1
    #define RELAY_OFF 0
#else
    #define RELAY_ON 0
    #define RELAY_OFF 1
#endif

#define PRODUCT_ID 3
#define Sim800l Serial1 
TinyGsm modem(Sim800l);


#ifdef NETWORK_WIFI 
    //untuk wifi
    WiFiClient espClient;
    PubSubClient client(espClient);
#else
    //untuk gsm
    TinyGsmClient clientelle(modem);
    PubSubClient client(clientelle);
#endif  

// delay definition 
#define MAX_DELAY_MS_GEOLOC 10000
#define MAX_DELAY_MS_TIME 1000
#define LOOP_DELAY_MS 2 
#define MAX_INITIAL_RETRIEVE 2
#define MAX_RETRIEVE 30

// State Definition
#define STARTUP 9
#define IDLE 0
#define RETRIEVE_SERIAL 1
#define TRIGGER 2
#define INIT_CHARGING 3
#define CHARGING 5
#define FINISH_CHARGING 4

// Pin Definition
// Right Side
#define batteryButtonR 33   //12
#define chargerSW1R 32      //gakepake
#define chargerSW2R 33      //gakepake
#define redR 19     //23     //19     //4
#define greenR 18 //23
#define blueR 23 //18

// Left Side
#define batteryButtonL 32   //14
#define chargerSW1L 23  // gapake
#define chargerSW2L 18  // gapake
#define redL 16//17 //16     //15   
#define greenL 4 //17   //0
#define blueL 17//4     //2

// Others
#define chargingModePin 14  //19
#define SDA 21
#define SCL 22
#define txBMS 10
#define rxBMS 9
#define txGSM 26    //25
#define rxGSM 27    //26
#define relayCharger 25    //27
#define triggerButton 13

#define delayChargingState 15 * 1000    // seconds * 1000
#define delayBatterySampling 5 * 60000  // minutes * 60000 

// mqtt
//#define brokerIP "192.168.1.102"
#define brokerIP "34.101.49.52"

// wifi param
//#define wifi_ssid "ASUS"
//#define wifi_password "12345678"
#define wifi_ssid "HUAWEI-UKva"
#define wifi_password "74A3Fkw7"
//#define wifi_ssid "ThinQ"
//#define wifi_password "kentnaoko"
//#define wifi_ssid "G7"
//#define wifi_password "1234567890"

// sim800 + gprs param
#define MODEM_TX 27
#define MODEM_RX 26
const char apn[] = "internet";

// Global Variables
// Right Side
byte stateR = 0;
int PWM_FREQUENCYR = 50000;
int PWM_CHANNELR = 0;
int PWM_RESOUTIONR = 8;
unsigned short SoHR;
unsigned short remainingCapacityR;
unsigned short totalCapacityR;
double SoCR;
double voltR;
char msgR[200];
char serialNumberR[16] = "";
byte cmd_sendSlotR = 0;
byte cmd_periodicBattInfoSampleR = 0;
byte isValid_initialBattInfoR = 0;
long t_lastSampleR = millis();
byte stat_initialChargeDelayR = 0;

// Left Side
byte stateL = 0;
int PWM_FREQUENCYL = 50000;
int PWM_CHANNELL = 0;
int PWM_RESOUTIONL = 8;
unsigned short SoHL;
unsigned short remainingCapacityL;
unsigned short totalCapacityL;
double SoCL;
double voltL;
char msgL[200];
char msgBattInfoL[200];
char serialNumberL[16] = "";
byte cmd_sendSlotL = 0;
byte cmd_periodicBattInfoSampleL = 0;
byte isValid_initialBattInfoL = 0;
long t_lastSampleL = millis();
byte stat_initialChargeDelayL = 0;

// Others
byte isEnabledCmd = 0;
int previousChargingMode = 0;
int locDetails[5];
int chargingMode = 0;
byte isGetLocation = 0;
long lastGprsAttempt = 0;
long lastDebugUpload = 0;
char topics[3][20] = {
    "sys/s1",
    "sys/s2",
    "sys/device", 
};

int readAdcCurrent;
float current;  
int readAdcVoltage;
float voltage;
int readAdcTemperature;
float temperature;
int driftVoltage = -62;
int qov = 2500;
int overheatFlag = 0;
int overcurrentFlag = 0;
int triggerFlag = 0;
long t = millis();
long t1 = millis();
long t_overcurrentFlag = millis();
byte initialUpload = 0;
byte initialSyncEnable = 0;

int adc_ads1[5];

// char topics[3][20]; 
char commandTopic[25];
char commandTopicCallback[50];
char syncEnableTopic[50];
char syncEnableTopicCallback[50];

Adafruit_ADS1015 ads1015;    // ADS1115 untuk temperatur
//Adafruit_ADS1015 ads1015VI;    // ADS1115 untuk tegangan dan arus

// Mutex Definition
SemaphoreHandle_t xMutex;
 
void setup()
{ 
    // Initialize serial communication
    Serial.begin(9600); 
    Sim800l.begin(9600, SERIAL_8N1, rxGSM, txGSM); 
    
    // Set commandTopic
    sprintf(commandTopic, "sys/charger%d/commands", PRODUCT_ID); 
    sprintf(commandTopicCallback, "sys/charger%d/commandsCallback", PRODUCT_ID); 
    sprintf(syncEnableTopic, "sys/enableStatus/%d", PRODUCT_ID); 
    sprintf(syncEnableTopicCallback, "sys/enableStatusCallback/%d", PRODUCT_ID); 

    // load enable/disable status dari EEPROM 
    EEPROM.begin(EEPROM_SIZE);
    isEnabledCmd = EEPROM.read(0);
    Serial.print("isEnabled: ");
    Serial.println(isEnabledCmd);
    
    // Right Side Pin Configuration
    pinMode(batteryButtonR, INPUT_PULLUP);
    //pinMode(chargerSW1R, OUTPUT);
    //pinMode(chargerSW2R, OUTPUT);
    pinMode(redR, OUTPUT);
    pinMode(greenR, OUTPUT);
    pinMode(blueR, OUTPUT);

    // Left Side Pin Configuration
    pinMode(batteryButtonL, INPUT_PULLUP);
    //pinMode(chargerSW1L, OUTPUT);
    //pinMode(chargerSW2L, OUTPUT);
    pinMode(redL, OUTPUT);
    pinMode(greenL, OUTPUT);
    pinMode(blueL, OUTPUT);

    // Other pins configuration
    pinMode(triggerButton, INPUT_PULLUP);
    pinMode(chargingModePin, INPUT_PULLUP);
    pinMode(relayCharger, OUTPUT);

    #ifdef NETWORK_WIFI 
        // Connect to WiFi
        WiFi.disconnect();
        delay(3000);
        Serial.println("System Start"); 
        WiFi.begin(wifi_ssid, wifi_password);
        while ((!(WiFi.status() == WL_CONNECTED))){
            delay(300);
            Serial.print("...");
        }
        Serial.println("Connected");
        Serial.println("Your IP is");
        Serial.println((WiFi.localIP()));

    #else
        // Connect to GPRS
        if (checkGsmNetwork() == 1){
            gprsConnectFuction();     
        } 
        else{
            Serial.println("Network unavailable, retrying GPRS in 30secs");
        }
    #endif

    // mqtt params
    client.setServer(brokerIP, 1883);
    client.setCallback(callback);

    Serial.println("HAI");


    // Inisialisasi ADS
    ads1015.begin(0x48);   // Temperatur 

    // Mematikan relay
    digitalWrite(relayCharger, RELAY_OFF);

    // Mutex definition
    xMutex = xSemaphoreCreateMutex();
     
    // Task Idle R and L
    xTaskCreatePinnedToCore(LeftCode, "Left", 10000, NULL, 1, NULL, 0);
    xTaskCreatePinnedToCore(Sampling, "Sampling", 10000, NULL, 1, NULL, 0);
    xTaskCreatePinnedToCore(RightCode, "Right", 10000, NULL, 1, NULL, 1);
    xTaskCreatePinnedToCore(MQTTLoop, "MQTTLoop", 10000, NULL, 2, NULL, 1);
    xTaskCreatePinnedToCore(BattInfoTask, "BattInfoTask", 10000, NULL, 1, NULL, 0);  
}

void loop()
{
}

void Sampling(void *parameter)
{
    for (;;)
    {
        int triggerDetected;
        if (millis() - t > 2000){
        //   Serial.print("Current: "); SF
        //   Serial.println(current);
        //   Serial.print("Voltage: ");
        //   Serial.println(voltage);
        //   Serial.print("Temperature: ");
        //   Serial.println(temperature+3); 

          
        //   Serial.print("A0: ");
        //   Serial.println(adc_ads1[0]); 
          
        //   Serial.print("A1: ");
        //   Serial.println(adc_ads1[1]); 
          
        //   Serial.print("A2: ");
        //   Serial.println(adc_ads1[2]); 
          
        //   Serial.print("A3: ");
        //   Serial.println(adc_ads1[3]); 
           t = millis(); 
        }

        // button ubah mode daya
        byte btnSwitchPowerMode = digitalRead(chargingModePin);
        chargingMode = btnSwitchPowerMode;

        triggerDetected = !(digitalRead(triggerButton));
        if( triggerDetected && stateL == IDLE && stateR == IDLE){
            triggerFlag = 1;
        }
        
        readAdcCurrent = ads1015.readADC_SingleEnded(0);
        current = ((float(  (readAdcCurrent*3 + driftVoltage)  ) - float(qov)) ) / 0.093 ;
        
        readAdcVoltage = ads1015.readADC_SingleEnded(1);
        voltage = readAdcVoltage;
        voltage = float( readAdcVoltage*3 );
        voltage *= 34;
        
        readAdcTemperature = ads1015.readADC_SingleEnded(2);

        adc_ads1[0] = ads1015.readADC_SingleEnded(0);
        adc_ads1[1] = ads1015.readADC_SingleEnded(1);
        adc_ads1[2] = ads1015.readADC_SingleEnded(2);
        adc_ads1[3] = ads1015.readADC_SingleEnded(3);
        
        temperature = (float( readAdcTemperature*3 )/7.2) - 8.5;

        if(temperature > 67){
            Serial.println("OVERHEAT DETECTED");
            overheatFlag = 1;
        }
        
        if (overheatFlag == 1 && temperature < 57){
            Serial.println("Resume normal operation");
            overheatFlag = 0;
        }

        if(current > 15000){
            Serial.println("OVERCURRENT DETECTED");
            overcurrentFlag = 1;
            t_overcurrentFlag = millis();
        }
        if (overcurrentFlag == 1 && millis() - t_overcurrentFlag > 30000 ){
            Serial.println("Resume normal operation");
            overcurrentFlag = 0;
        }
        
        vTaskDelay(3 / portTICK_PERIOD_MS);
    }
}

void MQTTLoop(void *parameter)
{
    for (;;)
    { 
        char blank[1] = ""; 
        char stringHolder[256];

        int gsmStatus = checkGsmNetwork();
        int modemStatus = modem.isGprsConnected();

        // Setiap 15 detik, apabila koneksi GPRS belum ada, dipanggil fungsi koneksi GPRS 
        if (millis() - lastGprsAttempt > 15000 && gsmStatus == 1 && modemStatus == 0){
            if (modem.isGprsConnected()){
                Serial.println("GPRS Connected");
            }
            else{ 
                Serial.println("GPRS not connected, connecting..."); 
                lastGprsAttempt = millis();
                gprsConnectFuction();  
                if (modem.isGprsConnected()){
                      
                }
            }
        }
        
        // else{
        //     Serial.println("Network unavailable, cant connect to GPRS & broker");
        // }

        // if (!modem.isGprsConnected() && millis() - lastGprsAttempt > 30000){
        //     lastGprsAttempt = millis();
        //     gprsConnectFuction();
        // }

        // Bila sudah terkoneksi GPRS namun belum terkoneksi ke broker MQTT dipanggil fungsi koneksi ke broker
        if (!client.connected() && modem.isGprsConnected()){
            reconnectmqttserver();
        } 

        if (!client.connected() && WiFi.status() == WL_CONNECTED)
        {
            reconnectmqttserver();
        }
        
        // fungsi untuk keberjalanan modul PubSubClient.h
        client.loop(); 
        
        // test doang, delete nanti 
        // if (millis() - lastDebugUpload > 5000){
        //     Serial.print("Network status: ");
        //     Serial.println(gsmStatus);
        //     Serial.print("GPRS status: ");
        //     Serial.println(modemStatus);
        //     lastDebugUpload = millis();
        //     Serial.println("debug set cmd_sendSlotL = 1");
        //     cmd_sendSlotL = 1;

        //    strcpy(stringHolder, blank);
        //    buildStringBatteryInfo(0, stringHolder);
        //    Serial.println(stringHolder);
        //    client.publish(topics[0], stringHolder);
        //    strcpy(stringHolder, blank);
        //    buildStringDeviceInfo(stringHolder);
        //    Serial.println(stringHolder);
        //    client.publish(topics[2], stringHolder);

        // }

        if (initialUpload == 0 && client.connected() && gsmStatus == 1){  
            strcpy(stringHolder, blank);
            buildStringBatteryInfo(0, stringHolder);
            Serial.println(stringHolder);
            client.publish(topics[0], stringHolder);
            
            strcpy(stringHolder, blank);
            buildStringBatteryInfo(1, stringHolder);
            Serial.println(stringHolder);
            client.publish(topics[1], stringHolder); 
            
            initialUpload = 1;

            
            strcpy(stringHolder, blank);
            buildStringBatteryInfo(0, stringHolder);
            Serial.println(stringHolder);
            client.publish(topics[0], stringHolder);
            
            strcpy(stringHolder, blank);
            buildStringBatteryInfo(1, stringHolder);
            Serial.println(stringHolder);
            client.publish(topics[1], stringHolder); 
        }

        if  (initialUpload == 1 && initialSyncEnable == 0){
            client.publish(syncEnableTopic, "srand()");
        }
        
        if (initialUpload == 1 && initialSyncEnable == 1){
            // Sampling lokasi apabila informasi belum didapatkan 
            if (!(isGetLocation))
            {   
                if (checkGsm() == 1){
                    getLocation(locDetails);
                    Serial.println("Loc:");
                    for (int l = 0; l < 4; l++){
                        Serial.println(locDetails[l]);
                    }  
                    
                    isGetLocation = 1;
                }
                    
            }
    
            // Proses bila sudah terkoneksi ke broker
            // terdapat beberapa variabel command yang diset 1 pada state tertentu di Task Left dan Right battery
            // proses publish harus dilakukan terpisah dengan Task Left dan Right
            // karena proses komunikasi dengan SIM800L harus ada di task yang level prioritas nya lebih tinggi
            if (client.connected()){
                // command publsih data slot kiri (slot 1)
                if (cmd_sendSlotL == 1){  
                    strcpy(stringHolder, blank);
                    buildStringBatteryInfo(0, stringHolder);
                    Serial.println(stringHolder);
                    client.publish(topics[0], stringHolder);
                    strcpy(stringHolder, blank);
                    buildStringDeviceInfo(stringHolder);
                    Serial.println(stringHolder);
                    client.publish(topics[2], stringHolder);
        
                    cmd_sendSlotL = 0;
                }
                // command publsih data slot kiri (slot 2)
                if (cmd_sendSlotR == 1){  
                    strcpy(stringHolder, blank);
                    buildStringBatteryInfo(1, stringHolder);
                    Serial.println(stringHolder);
                    client.publish(topics[1], stringHolder);
                    strcpy(stringHolder, blank);
                    buildStringDeviceInfo(stringHolder);
                    Serial.println(stringHolder);
                    client.publish(topics[2], stringHolder);
        
                    cmd_sendSlotR = 0;
                }
    
                // command publish bila switch mode daya diflip
                if (previousChargingMode != chargingMode){
                    strcpy(stringHolder, blank);
                    buildStringBatteryInfo(0, stringHolder);
                    Serial.println(stringHolder);
                    client.publish(topics[0], stringHolder);
                    
                    strcpy(stringHolder, blank);
                    buildStringBatteryInfo(1, stringHolder);
                    Serial.println(stringHolder);
                    client.publish(topics[1], stringHolder);
                    
                    strcpy(stringHolder, blank);
                    buildStringDeviceInfo(stringHolder);
                    Serial.println(stringHolder);
                    client.publish(topics[2], stringHolder);
                }
                previousChargingMode = chargingMode;
            }
    
            // bila koneksi ke broker belum ada, command publish ditahan dulu
            // publish dilakukan setelah koneksi ke broker berhasil dilakukan  
            else{
                Serial.println("Can't upload, MQTT / GPRS unavailable");
                Serial.print("Network status: ");
                Serial.println(gsmStatus);
                Serial.print("GPRS status: ");
                Serial.println(modemStatus);
            }
                      
            vTaskDelay(2 / portTICK_PERIOD_MS);
        }
    }
}

void BattInfoTask(void *parameter){
    for (;;)
    {
        
        int serialValid = 0;
        int battDataValid = 0;
        int counter = 0; 

        if (cmd_periodicBattInfoSampleL == 1){
            unsigned short temp_SoHL;
            unsigned short temp_remainingCapacityL;
            unsigned short temp_totalCapacityL;
            double temp_SoCL;   
            
            Serial.println("Masuk command periodic data sampling L");

            Serial.println("OLD INFO:");
            Serial.println(SoHL);
            Serial.println(remainingCapacityL);
            Serial.println(totalCapacityL);
            Serial.println(SoCL);   

            temp_SoHL = SoHL; 
            temp_remainingCapacityL = remainingCapacityL;
            temp_totalCapacityL = totalCapacityL;
            temp_SoCL = SoCL;

            byte battSW = digitalRead(batteryButtonL);
            // sampling data (copas dari bagian stateRetreiveSerialL. Update bagian ini juga bila ada perubahan di sana
            while(!(battDataValid) && counter < MAX_RETRIEVE && battSW){
                battDataValid = readBattData('L');
                battSW = digitalRead(batteryButtonL);
                counter++;
                vTaskDelay(1500 / portTICK_PERIOD_MS);
            }

            Serial.println("NEW INFO:");
            Serial.println(SoHL);
            Serial.println(remainingCapacityL);
            Serial.println(totalCapacityL);
            Serial.println(SoCL);   

            if (totalCapacityL > 105 && totalCapacityL < 5){
                // kondisi ini berarti data yang diparse masih salah
                if (isValid_initialBattInfoL == 0){
                    // cmd bersangkutan tidak diset 0, fungsi diulang terus hingga initial data didapatkan
                }
                else{
                    SoHL = temp_SoHL; 
                    remainingCapacityL = temp_remainingCapacityL;
                    totalCapacityL = temp_totalCapacityL;
                    SoCL = temp_SoCL; 
            
                    Serial.println("REFRESHED INFO:");
                    Serial.println(SoHL);
                    Serial.println(remainingCapacityL);
                    Serial.println(totalCapacityL);
                    Serial.println(SoCL);   
                
                    cmd_periodicBattInfoSampleL = 0;
                }
                
            }
            else{ 
                if (isValid_initialBattInfoL == 0){
                    isValid_initialBattInfoL = 1;
                    cmd_sendSlotL = 1;
                }
                cmd_periodicBattInfoSampleL = 0;
                isValid_initialBattInfoL = 1;
            }


            

        }

        
        if (cmd_periodicBattInfoSampleR == 1){
            unsigned short temp_SoHR;
            unsigned short temp_remainingCapacityR;
            unsigned short temp_totalCapacityR;
            double temp_SoCR;   
            
            Serial.println("Masuk command periodic data sampling R");

            Serial.println("OLD INFO:");
            Serial.println(SoHR);
            Serial.println(remainingCapacityR);
            Serial.println(totalCapacityR);
            Serial.println(SoCR);  
            
            temp_SoHR = SoHR; 
            temp_remainingCapacityR = remainingCapacityR;
            temp_totalCapacityR = totalCapacityR;
            temp_SoCR = SoCR;

            byte battSW = digitalRead(batteryButtonR);
            // sampling data (copas dari bagian stateRetreiveSerialR. Update bagian ini juga bila ada perubahan di sana
            while(!(battDataValid) && counter < MAX_RETRIEVE && battSW){
                battDataValid = readBattData('R');
                battSW = digitalRead(batteryButtonR);
                counter++;
                vTaskDelay(1500 / portTICK_PERIOD_MS);
            }

            
            Serial.println("NEW INFO:");
            Serial.println(SoHR);
            Serial.println(remainingCapacityR);
            Serial.println(totalCapacityR);
            Serial.println(SoCR);  

            // Sampai sini, data baterai mungkin sudah diperoleh atau belum
            // Diberikan counter agar tidak stuck ketika tidak dapat membaca info baterai


            if (totalCapacityR > 105 && totalCapacityR < 5){
                // kondisi ini berarti data yang diparse masih salah
                if (isValid_initialBattInfoR == 0){
                    // cmd bersangkutan tidak diset 0, fungsi diulang terus hingga initial data didapatkan
                }
                else{
                    SoHR = temp_SoHR; 
                    remainingCapacityR = temp_remainingCapacityR;
                    totalCapacityR = temp_totalCapacityR;
                    SoCR = temp_SoCR; 
            
                    Serial.println("REFRESHED INFO:");
                    Serial.println(SoHR);
                    Serial.println(remainingCapacityR);
                    Serial.println(totalCapacityR);
                    Serial.println(SoCR);   
                
                    cmd_periodicBattInfoSampleR = 0;
                }
                
            }
            else{ 
                if (isValid_initialBattInfoR == 0){
                    isValid_initialBattInfoR = 1;
                    cmd_sendSlotR = 1;
                }
                cmd_periodicBattInfoSampleR = 0;
                isValid_initialBattInfoR = 1;
            }

        }


        vTaskDelay(3 / portTICK_PERIOD_MS);
    }
}

void LeftCode(void *parameter)
{
    for (;;)
    {
    //    if (millis() - t > 1000){
    //        Serial.print("StateL : ");
    //        Serial.println(stateL);
    //        t = millis();
    //    }

        
        if(overheatFlag || overcurrentFlag || !isEnabledCmd){
          stateFaultL();
        }
        else if(triggerFlag){
            stateTriggerBMS();
        }
        else{
          if (stateL == IDLE)
          {
              stateIdleL();
              idleTransitionL();
          }
          else if (stateL == RETRIEVE_SERIAL)
          {
              stateRetrieveSerialL();
          }
          else if (stateL == INIT_CHARGING)
          {
              initChargingL();
          }
          else if (stateL == FINISH_CHARGING)
          {
              stateFinishChargeL();
          }
          else if (stateL == CHARGING)
          {
              stateChargingL();
          } 
        }
        
        vTaskDelay(3 / portTICK_PERIOD_MS);
    }
}

void RightCode(void *parameter)
{
    for (;;)
    {
//        if (millis() - t1 > 1000){
//            Serial.print("StateR : ");
//            Serial.println(stateR);
//            t1 = millis();
//        }

        if(overheatFlag || overcurrentFlag || !isEnabledCmd){
          // tidak melakukan apapaun
          // stateFaultR();
        }
        else if(triggerFlag){
            // TIdak melakukan apapun
        }
        else{
          if (stateR == IDLE)
          {
              stateIdleR();
              idleTransitionR();
          }
          else if (stateR == RETRIEVE_SERIAL)
          {
              stateRetrieveSerialR();
          }
          else if (stateR == INIT_CHARGING)
          {
              initChargingR();
          }
          else if (stateR == FINISH_CHARGING)
          {
              stateFinishChargeR();
          }
          else if (stateR == CHARGING)
          {
              stateChargingR();
          } 
        }

        vTaskDelay(3 / portTICK_PERIOD_MS);
    }
}

// -----Left Functions----- //
void LED_1L(int red_light_value_1, int green_light_value_1, int blue_light_value_1)
{
    digitalWrite(redL, red_light_value_1);
    digitalWrite(greenL, green_light_value_1);
    digitalWrite(blueL, blue_light_value_1);
}

void stateFaultL(){
    digitalWrite(relayCharger, RELAY_OFF);
    
    LED_1L(HIGH, LOW, LOW);
    LED_1R(HIGH, LOW, LOW);
    vTaskDelay(500 / portTICK_PERIOD_MS);
    LED_1L(LOW, LOW, LOW);
    LED_1R(LOW, LOW, LOW);
    vTaskDelay(500 / portTICK_PERIOD_MS);
    stateL = IDLE;
    stateR = IDLE;
    
}

void idleTransitionL()
{

    // Serial.println(stateL);

    byte triggerDetectedL;                      // Untuk mendeteksi trigger button ditekan
    byte battSWL = digitalRead(batteryButtonL); // Untuk mendeteksi switch pada dudukan baterai ditekan
    int16_t adc;
    float vBattery = 0;

    triggerDetectedL = digitalRead(triggerButton);

    
//    Serial.print(battSWL);
//    Serial.println(voltage);

    // Apabila terdeteksi ada baterai, pindah ke state 1. Selain itu, pindah ke state 2
    if (voltage > 40000)
    {
        if(battSWL == 1 && stateR != RETRIEVE_SERIAL && stateR != INIT_CHARGING){
            stateL = RETRIEVE_SERIAL;   
        }
    }
    else
    {
        stateL = IDLE;
    }
}

void stateIdleL()
{
    //  Serial.print("L Idle\n");

    // Memberika indikator LED merah
    LED_1L(HIGH, LOW, LOW);

    // Delay
    vTaskDelay(50 / portTICK_PERIOD_MS);
}

int readSerial(char LorR){
    int readIdx = 0;
    int msgIdx = 0;
    int plusCount = 0;
    int serialNumberCount = 0;
    int serialNumberIdx = 0;

    // Mengirim request serial number. request dikirimkan dua kali karena ada delay respon dari BMS sebesar satu request
    if(LorR == 'L'){
        Serial.write("LSerial_Number");        
    }
    else if(LorR == 'R'){
        Serial.write("RSerial_Number");
    }
    else{
        Serial.println("LorR tidak didefinisikan!");
    }

    // Membaca respon dari request
    while (Serial.available() > 0)
    {
        if(LorR == 'L'){
            msgL[readIdx] = Serial.read();
        }
        else if(LorR == 'R'){
            msgR[readIdx] = Serial.read();
        }
        else{
            Serial.println("LorR tidak didefinisikan!");
        }
        readIdx++;
    }

  // Parsing pesan
    if( LorR == 'L' ){
        if(msgL[0] == 'L'){
            // Menghitung karakter '+'
            while (msgIdx < readIdx + 1)
            {
                if (plusCount == 1)
                {
                    serialNumberCount++;
                }
        
                if (msgL[msgIdx] == '+')
                {
                    plusCount++;
                    if (plusCount == 1)
                    {
                        serialNumberIdx = msgIdx + 1;
                    }
                }
        
                msgIdx++;
            }
        
            msgIdx = 0;
        
            // Memindahkan nomor serial baterai ke variabel serialNumberL
            while (msgL[serialNumberIdx] != '+' && serialNumberIdx < readIdx + 1)
            {
                serialNumberL[msgIdx] = msgL[serialNumberIdx];
                serialNumberIdx++;
                msgIdx++;
            }
        
            // Terminasi string
            serialNumberL[msgIdx] = '\0';
        
            // Untuk troubleshooting
            Serial.println();
            Serial.print("Serial Number Slot Kiri: ");
            Serial.println(serialNumberL); 
        }
        else{
            Serial.println("Data yang diterima tidak valid");
        }
    }   
    else if( LorR == 'R' ){
        if(msgR[0] == 'R'){
            // Menghitung karakter '+'
            while (msgIdx < readIdx + 1)
            {
                if (plusCount == 1)
                {
                    serialNumberCount++;
                }
        
                if (msgR[msgIdx] == '+')
                {
                    plusCount++;
                    if (plusCount == 1)
                    {
                        serialNumberIdx = msgIdx + 1;
                    }
                }
        
                msgIdx++;
            }
        
            msgIdx = 0;
        
            // Memindahkan nomor serial baterai ke variabel serialNumberL
            while (msgR[serialNumberIdx] != '+' && serialNumberIdx < readIdx + 1)
            {
                serialNumberR[msgIdx] = msgR[serialNumberIdx];
                serialNumberIdx++;
                msgIdx++;
            }
        
            // Terminasi string
            serialNumberR[msgIdx] = '\0';
        
            // Untuk troubleshooting
            Serial.println();
            Serial.print("Serial Number Slot Kanan: ");
            Serial.println(serialNumberR); 
        }
        else{
            Serial.println("Data yang diterima tidak valid");
        }
    }
    
    if(plusCount == 2 && serialNumberCount > 1){
        return 1;
    }
    else{
        return 0;
    }
}

int readBattData(char LorR){
    int readIdx = 0;
    int msgIdx = 0;
    int plusCount = 0;
    int serialNumberCount = 0;
    int checksum = 0;

    // Mengirimkan request
    if(LorR == 'L'){
        Serial.write("LBatt_Info");   
    }
    else if(LorR == 'R'){
        Serial.write("RBatt_Info");
    }
    else{
        Serial.println("LorR tidak terdefinisi");
    }

    // Membaca respon dari request
    while (Serial.available() > 0)
    {
        if(LorR == 'L'){
            msgL[readIdx] = Serial.read();   
        }
        else if(LorR == 'R'){
            msgR[readIdx] = Serial.read();
        }
        readIdx++;
    }

    // print msg
    while(msgIdx < readIdx+1){
        if(LorR == 'L'){
            Serial.print(msgL[msgIdx]);
            Serial.print(" , ");
            Serial.println(msgL[msgIdx], HEX); 
        }
        else if(LorR == 'R'){
            Serial.print(msgR[msgIdx]);
            Serial.print(" , ");
            Serial.println(msgR[msgIdx], HEX);
        }
        msgIdx++;
    }    

    for(int i = 1; i < readIdx-3; i++){
        checksum += msgL[i];
    }

    // Parsing respon dari BMS
    if(LorR == 'L'){
        if( strncmp(msgL, "Lerror", 6) == 0 ){
            Serial.println("Data battery info tidak valid!");
            SoHL = -1;
            remainingCapacityL = -1;
            totalCapacityL = -1;
            SoCL = -1;
        }
        else{
            if(checksum % 256 == 0){
                SoHL = (msgL[80] << 8) | (msgL[81]);
                remainingCapacityL = (msgL[76] << 8) | (msgL[77]);
                totalCapacityL = (msgL[78] << 8) | (msgL[79]);
                SoCL = (double) remainingCapacityL / (double) totalCapacityL;   
            }     
            else{
                Serial.println("Data salah");
            }
        }
    
        Serial.println(SoHL);
        Serial.println(remainingCapacityL);
        Serial.println(totalCapacityL);
        Serial.println(SoCL);   
    } 
    else if(LorR == 'R'){
        if( strncmp(msgR, "Rerror", 6) == 0 ){
            Serial.println("Data battery info tidak valid!");
            SoHL = -1;
            remainingCapacityL = -1;
            totalCapacityL = -1;
            SoCL = -1;
        }
        else{
            if(checksum % 256 == 0){
                SoHR = (msgR[80] << 8) | (msgR[81]);
                remainingCapacityR = (msgR[76] << 8) | (msgR[77]);
                totalCapacityR = (msgR[78] << 8) | (msgR[79]);
                SoCR = (double) remainingCapacityR / (double) totalCapacityR;   
            }     
            else{
                Serial.println("Data salah");
            }
        }
    
        Serial.println(SoHR);
        Serial.println(remainingCapacityR);
        Serial.println(totalCapacityR);
        Serial.println(SoCR); 
    }
 

    if(checksum % 256 == 0){
        if (LorR == 'L' && SoHL != 0){
            return 1;
        }
        else if (LorR == 'R' && SoHR != 0){
            return 1;
        }
        else{
            return 0;
        }
    }
    else{
        return 0;
    }
}

void stateRetrieveSerialL(){
    LED_1L(HIGH, HIGH, LOW);
    int serialValid = 0;
    int battDataValid = 0;
    int counter = 0;
    byte battSWL = digitalRead(batteryButtonL);

    while(!(serialValid) && battSWL){
        serialValid = readSerial('L');
        battSWL = digitalRead(batteryButtonL);
        vTaskDelay(700 / portTICK_PERIOD_MS);
    }

    // Sampai sini, data serial sudah diperoleh
    while(!(battDataValid) && counter < MAX_INITIAL_RETRIEVE && battSWL){
        battDataValid = readBattData('L');
        battSWL = digitalRead(batteryButtonL);
        counter++;
        vTaskDelay(1500 / portTICK_PERIOD_MS);
    }

    // Sampai sini, data baterai mungkin sudah diperoleh atau belum
    // Diberikan counter agar tidak stuck ketika tidak dapat membaca info baterai

    // bila data baterai belum diperoleh, akan dicoba diambil kembali setelah masuk mode charging
    if (battDataValid == 0){
        isValid_initialBattInfoL = 0;
        // pada state charging, akan diset cmd_periodicBattInfoSampleL = 1;
    } 
    else{
        isValid_initialBattInfoL = 1;
    }

    // perpindahan state
    if (battSWL == 1 && voltage > 40000)
    {
        stateL = INIT_CHARGING;
    }
    else
    {
        stateL = IDLE;
    }     
}

void stateTriggerBMS()
{
    //  Serial.print("L Triggered\n");
    LED_1L(HIGH, HIGH, LOW);
    LED_1R(HIGH, HIGH, LOW);
    vTaskDelay(500 / portTICK_PERIOD_MS);
    LED_1L(LOW, LOW, LOW);
    LED_1R(LOW, LOW, LOW);
    vTaskDelay(500 / portTICK_PERIOD_MS);
    LED_1L(HIGH, HIGH, LOW);
    LED_1R(HIGH, HIGH, LOW);
    vTaskDelay(500 / portTICK_PERIOD_MS);
    LED_1L(LOW, LOW, LOW);
    LED_1R(LOW, LOW, LOW);
    vTaskDelay(500 / portTICK_PERIOD_MS);
    LED_1L(HIGH, HIGH, LOW);
    LED_1R(HIGH, HIGH, LOW);

    digitalWrite(relayCharger, RELAY_ON);   

    vTaskDelay(1000 / portTICK_PERIOD_MS);

    digitalWrite(relayCharger, RELAY_OFF);   

    stateL = IDLE;
    stateR = IDLE;
    triggerFlag = 0;
}

int requestStartCharging(char LorR){
    int readIdx = 0;
    int msgIdx = 0;
    
    // Meminta request
    if(LorR == 'L'){
        Serial.write("LCharge");
    }
    else if(LorR == 'R'){
        Serial.write("RCharge");
    }
    else{
        Serial.write("LorR tidak terdefinisi");
    }

    // Membaca respon yang didapat
    while (Serial.available() > 0)
    {
        if(LorR == 'L'){
            msgL[readIdx] = Serial.read();
        }
        else if(LorR == 'R'){
            msgR[readIdx] = Serial.read();
        }
        
        readIdx++;
    }

    // Terminasi string
    if(LorR == 'L'){
        msgL[readIdx] = '\0';
        // Untuk troubleshooting
        Serial.println();
        Serial.print("Mode charge baterai kiri: ");
        Serial.println(msgL);
        if(strncmp(msgL, "Lok", 3) == 0){
            return 1;
        }
        else{
            return 0;
        }
    }
    else if(LorR == 'R'){
        msgR[readIdx] = '\0';
        // Untuk troubleshooting
        Serial.println();
        Serial.print("Mode charge baterai kanan: ");
        Serial.println(msgR);
        if(strncmp(msgR, "Rok", 3) == 0){
            return 1;
        }
        else{
            return 0;
        }
    }

    
}

void initChargingL(){
    byte battSW = digitalRead(batteryButtonL);
    int chargeReady = 0;
    char stringHolder[256];
    char blank[1] = "";

    while(!(chargeReady) && battSW){
        // Indikator blink biru
        LED_1L(LOW, LOW, LOW);
        vTaskDelay(500 / portTICK_PERIOD_MS);
        LED_1L(LOW, LOW, HIGH);
        vTaskDelay(500 / portTICK_PERIOD_MS);
        chargeReady = requestStartCharging('L');
        battSW = digitalRead(batteryButtonL);
        vTaskDelay(1000 / portTICK_PERIOD_MS);
    }

    if (battSW == 1 && voltage > 40000)
    {
        if (chargeReady)
        {
            stat_initialChargeDelayL = 0;
            stateL = CHARGING;
            if (isValid_initialBattInfoL == 1){
                cmd_sendSlotL = 1; 
            }
        }
    }
    else
    {
        stateL = IDLE;
    }
}

void stateChargingL()
{
    //  Serial.print("L Charging\n");
    byte battSWL = digitalRead(batteryButtonL);
    float tegangan;
    float arus;

    LED_1L(LOW, LOW, HIGH);
    
    // Mengaktifkan relay
    digitalWrite(relayCharger, RELAY_ON);
    
    if (stat_initialChargeDelayL == 0){ 
        vTaskDelay(delayChargingState / portTICK_PERIOD_MS); // Nanti diubah
        stat_initialChargeDelayL = 1;
    }
    vTaskDelay(1000 / portTICK_PERIOD_MS);
    if (battSWL == 1 && voltage > 40000)
    {
        if (DEMO == 1){
            if(stateR != CHARGING){
                digitalWrite(relayCharger, RELAY_OFF);
            }
            stateL = FINISH_CHARGING;
            if (!overheatFlag & !overcurrentFlag & isEnabledCmd){
                cmd_sendSlotL = 1; 
            }  
        }

        else {
            if(current < 0){
                if(stateR != CHARGING){
                    digitalWrite(relayCharger, RELAY_OFF);
                }
                stateL = FINISH_CHARGING;
                if (!overheatFlag & !overcurrentFlag & isEnabledCmd){
                    cmd_sendSlotL = 1;  
                }
            }
            else{
                stateL = CHARGING;
            }
        }

        // send periodic sampling command slot L
        if (millis() - t_lastSampleL > delayBatterySampling){
            t_lastSampleL = millis();
            cmd_periodicBattInfoSampleL = 1;
        }

        // bila initial battery data sudah berhasil didapatkan, send cmd ambil battery data
        if (isValid_initialBattInfoL == 0){
            cmd_periodicBattInfoSampleL = 1;
        }
    }
    else
    {
        stateL = IDLE;
        digitalWrite(relayCharger, RELAY_OFF);
        if (!overheatFlag & !overcurrentFlag & isEnabledCmd){
            cmd_sendSlotL = 1;  
        }
    }
}

void stateFinishChargeL()
{
    //  Serial.print("L Finish Charging\n");
    byte battSWL = digitalRead(batteryButtonL);

    LED_1L(LOW, HIGH, LOW);

    if (battSWL == 1 && voltage > 40000)
    {
        stateL = FINISH_CHARGING;
    }
    else
    {
        stateL = IDLE;
        cmd_sendSlotL = 1;
    }
    vTaskDelay(50 / portTICK_PERIOD_MS);
}

// -----Right Functions----- //
void LED_1R(int red_light_value_1, int green_light_value_1, int blue_light_value_1)
{
    digitalWrite(redR, red_light_value_1);
    digitalWrite(greenR, green_light_value_1);
    digitalWrite(blueR, blue_light_value_1);
}

void stateFaultR(){
    digitalWrite(relayCharger, RELAY_OFF); 
    
    LED_1R(HIGH, LOW, LOW);
    vTaskDelay(500 / portTICK_PERIOD_MS);
    LED_1R(LOW, LOW, LOW);
    vTaskDelay(500 / portTICK_PERIOD_MS);
    stateR = IDLE;
    
}

void idleTransitionR()
{
    byte triggerDetectedR;
    byte battSWR = digitalRead(batteryButtonR);
    byte battSWL = digitalRead(batteryButtonL);
    int16_t adc;
    float vBattery;

//    Serial.print("voltage:");
//    Serial.print(voltage);
//    Serial.print("  battSWR:");
//    Serial.print(battSWR);
//    Serial.print("  battSWL:");
//    Serial.print(battSWL);
//    Serial.print("  stateL:");
//    Serial.println(stateL);

    if (voltage > 40000)
    {
        if(battSWR == 1 && stateL != RETRIEVE_SERIAL && stateL != INIT_CHARGING){
            stateR = RETRIEVE_SERIAL;   
        }
    }
    else
    {
        stateR = IDLE;
    }
}

void stateIdleR()
{
    //  Serial.print("R Idle\n");

    LED_1R(HIGH, LOW, LOW);
    vTaskDelay(50 / portTICK_PERIOD_MS);
}

void stateRetrieveSerialR()
{
    LED_1R(HIGH, HIGH, LOW);
    int serialValid = 0;
    int battDataValid = 0;
    int counter = 0;
    byte battSW = digitalRead(batteryButtonR);

    while(!(serialValid) && battSW){
        serialValid = readSerial('R');
        battSW = digitalRead(batteryButtonR);
        vTaskDelay(700 / portTICK_PERIOD_MS);
    }

    // Sampai sini, data serial sudah diperoleh 
    while(!(battDataValid) && counter < MAX_INITIAL_RETRIEVE && battSW){
        battDataValid = readBattData('R');
        battSW = digitalRead(batteryButtonR);
        counter++;
        vTaskDelay(1500 / portTICK_PERIOD_MS);
    }

    // Sampai sini, data baterai mungkin sudah diperoleh atau belum
    // Diberikan counter agar tidak stuck ketika tidak dapat membaca info baterai

    // bila data baterai belum diperoleh, akan dicoba kembali setelah masuk state charging
    if (battDataValid == 0){
        isValid_initialBattInfoR = 0;
        // pada state charging, akan diset cmd_periodicBattInfoSampleR = 1;
    } 
    else{
        isValid_initialBattInfoR = 1;
    }

    // perpindahan state
    if (battSW == 1 && voltage > 40000)
    {
        stateR = INIT_CHARGING;
    }
    else
    {
        stateR = IDLE;
    }
}

void initChargingR(){
    byte battSW = digitalRead(batteryButtonR);
    int chargeReady = 0;
    char stringHolder[256];
    char blank[1] = "";

    while(!(chargeReady) && battSW){
    // Indikator blink biru
        LED_1R(LOW, LOW, LOW);
        vTaskDelay(500 / portTICK_PERIOD_MS);
        LED_1R(LOW, LOW, HIGH);
        vTaskDelay(500 / portTICK_PERIOD_MS);
        chargeReady = requestStartCharging('R');
        battSW = digitalRead(batteryButtonR);
        vTaskDelay(1000 / portTICK_PERIOD_MS);
    }

    if (battSW == 1 && voltage > 40000)
    {
        if (chargeReady)
        { 
            stat_initialChargeDelayR = 0;
            stateR = CHARGING;
            if (isValid_initialBattInfoR == 1){
                cmd_sendSlotR = 1; 
            }
        }
    }
    else
    {
        stateR = IDLE;
    }
}

void stateChargingR()
{
    //  Serial.print("R Charging\n");
    byte battSWR = digitalRead(batteryButtonR);
    LED_1R(LOW, LOW, HIGH);

    digitalWrite(relayCharger, RELAY_ON);

    if (stat_initialChargeDelayR == 0){ 
        vTaskDelay(delayChargingState / portTICK_PERIOD_MS); // Nanti diubah
        stat_initialChargeDelayR = 1;
    } 
    vTaskDelay(1000 / portTICK_PERIOD_MS);
    if (battSWR == 1 && voltage > 40000)
    {
        if (DEMO == 1){
            if(stateL != CHARGING){
                digitalWrite(relayCharger, RELAY_OFF);
            }
            stateR = FINISH_CHARGING;
            if (!overheatFlag & !overcurrentFlag & isEnabledCmd){
                cmd_sendSlotR = 1;  
            }
        }

        else {
            if(current < 0){
                if(stateL != CHARGING){
                    digitalWrite(relayCharger, RELAY_OFF);
                }
                stateR = FINISH_CHARGING;
                if (!overheatFlag & !overcurrentFlag & isEnabledCmd){
                    cmd_sendSlotR = 1;  
                }  
            }
            else{
                stateR = CHARGING;
            }
        }

        // send periodic sampling command slot R
        if (millis() - t_lastSampleR > delayBatterySampling){
            t_lastSampleR = millis();
            cmd_periodicBattInfoSampleR = 1;
        }
        
        // bila initial battery data sudah berhasil didapatkan, send cmd ambil battery data
        if (isValid_initialBattInfoR == 0){
            cmd_periodicBattInfoSampleR = 1;
        }

    }
    else
    {
        stateR = IDLE;
        digitalWrite(relayCharger, RELAY_OFF);
        if (!overheatFlag & !overcurrentFlag & isEnabledCmd){
            cmd_sendSlotR = 1;  
        }
    }
}

void stateFinishChargeR()
{
    //  Serial.print("R Finish Charging\n");
    byte battSWR = digitalRead(batteryButtonR);

    LED_1R(LOW, HIGH, LOW);

    if (battSWR == 1 && voltage > 40000)
    {
        stateR = FINISH_CHARGING;
    }
    else
    {
        stateR = IDLE;
        cmd_sendSlotR = 1;
    }
    vTaskDelay(50 / portTICK_PERIOD_MS);
}

void reconnectmqttserver()
{
    while (!client.connected())
    {
        Serial.print("Attempting MQTT connection...");
        String clientId = "ESP32Client-";
        clientId += String(random(0xffff), HEX);
        if (client.connect(clientId.c_str()))
        {
            Serial.println("connected");
            client.subscribe(commandTopic);
            client.subscribe(syncEnableTopicCallback);
            
        }
        else
        {
            Serial.print("failed, rc=");
            Serial.print(client.state());
            Serial.println(" try again in 5 seconds");
            vTaskDelay(5000 / portTICK_PERIOD_MS);
        }
    }
}

void callback(char *topic, byte *payload, unsigned int length)
{
    Serial.print("Message arrived on topic: ");
    Serial.print(topic);
    Serial.print(". Message: ");
    String MQTT_DATA = "";
    
    for (int i=0;i<length;i++) {
        // Serial.print((char)payload[i]);
        MQTT_DATA += (char)payload[i];
    }
    Serial.print(MQTT_DATA);
    
    if (strcmp(topic,commandTopic) || strcmp(topic,syncEnableTopicCallback) ){
        isEnabledCmd = MQTT_DATA.toInt();
        EEPROM.write(0, isEnabledCmd);
        EEPROM.commit();

        client.publish(commandTopicCallback, "received");
        Serial.println();

        
        // set initial sync to 1, untuk melanjutkan proses upload 
        Serial.println("HALO MASUK GAK KESINI?");
        if (strcmp(topic,syncEnableTopicCallback)){
            Serial.println("HALO MASUK GAK KESINI PART 2?");
            initialSyncEnable = 1;
        }
    }

}

void buildStringBatteryInfo(int battSelect, char *holder)
{
    char dbIndex[8][20] = {
        "\"Product ID\": ", "\"Status\": ", "\"Serial Number\": ", "\"Time\": ", "\"SoC\": ", "\"SoH\": ", " \"Volt\": ", "\"Charging Mode\": "};

    char sep[3] = ", ";
    char buildSN[18];
    char blank[1] = "";
    char ob = '{';
    char cb = '}';

    char stringHolder[30];
    // Openbracket
    strncat(holder, &ob, 1);

    // Product ID
    strcat(holder, dbIndex[0]);
    sprintf(stringHolder, "%d", PRODUCT_ID);
    strcat(holder, stringHolder);
    strcpy(stringHolder, blank);
    strcat(holder, sep);
    
    // Status
    strcat(holder, dbIndex[1]);
    if (battSelect == 0)
    {
        if (initialUpload == 0){
            sprintf(stringHolder, "%d", -1);
        }
        else{
            if(stateL == CHARGING){
                sprintf(stringHolder, "%d", 1);
            }
            else if(stateL == FINISH_CHARGING){
                sprintf(stringHolder, "%d", 2);
            }
            else{
                sprintf(stringHolder, "%d", 0);
            }
        }
            
    }
    else
    {
        if (initialUpload == 0){
            sprintf(stringHolder, "%d", -1);
        }
        else{
            if(stateR == CHARGING){
                sprintf(stringHolder, "%d", 1);
            }
            else if(stateR == FINISH_CHARGING){
                sprintf(stringHolder, "%d", 2);
            }
            else{
                sprintf(stringHolder, "%d", 0);
            }
        }
            
    }

    strcat(holder, stringHolder);
    strcpy(stringHolder, blank);
    strcat(holder, sep);

    // Serial Number
    strcat(holder, dbIndex[2]);
    if (battSelect == 0)
    {
        sprintf(stringHolder, "\"%s\"", serialNumberL);
        strcat(holder, stringHolder);
    }
    else
    {
        sprintf(stringHolder, "\"%s\"", serialNumberR);
        strcat(holder, stringHolder);
    }
    strcpy(stringHolder, blank);
    strcat(holder, sep);

    // Time
    strcat(holder, dbIndex[3]);
    strcpy(stringHolder, "\"\"");
    getCurrentTime(stringHolder);
    strcat(holder, stringHolder);
    strcpy(stringHolder, blank);
    strcat(holder, sep);

    // SOC
    strcat(holder, dbIndex[4]);
    if (battSelect == 0)
    {
        sprintf(stringHolder, "%.2f", SoCL*100);
    }
    else
    {
        sprintf(stringHolder, "%.2f", SoCR*100);
    }
    strcat(holder, stringHolder);
    strcpy(stringHolder, blank);
    strcat(holder, sep);
    
     // SOH
     strcat(holder, dbIndex[5]);
     if (battSelect == 0)
     {
         sprintf(stringHolder, "%.2f", float(SoHL)/10);
     }
     else
     {
         sprintf(stringHolder, "%.2f", float(SoHR)/10);
     }
     strcat(holder, stringHolder);
     strcpy(stringHolder, blank); 
     strcat(holder, sep);
     
     // Volt
     strcat(holder, dbIndex[6]);
     if (battSelect == 0)
     {
         sprintf(stringHolder, "%.2f", voltage/1000);
     }
     else
     {
         sprintf(stringHolder, "%.2f", voltage/1000);
     }
     strcat(holder, stringHolder);
     strcpy(stringHolder, blank);
     strcat(holder, sep);

    // Charging Mode
    strcat(holder, dbIndex[7]);
    sprintf(stringHolder, "%d", chargingMode);
    strcat(holder, stringHolder);
    strcpy(stringHolder, blank);

    // closebracket
    strncat(holder, &cb, 1);
}

void buildStringDeviceInfo(char *holder)
{
    char dbIndex[6][20] = {
        "\"Product ID\": ", "\"Charging Mode\": ", "\"MCC\": ", "\"MNC\": ", "\"LAC\": ", "\"Cell ID\": "};
    char sep[3] = ", ";
    char blank[1] = "";
    char ob = '{';
    char cb = '}';

    char stringHolder[30]; 

    // Openbracket
    strncat(holder, &ob, 1);

    // Product ID
    strcat(holder, dbIndex[0]);
    sprintf(stringHolder, "%d", PRODUCT_ID);
    strcat(holder, stringHolder);
    strcpy(stringHolder, blank);
    strcat(holder, sep);
    
    // Charging Mode
    strcat(holder, dbIndex[1]);
    sprintf(stringHolder, "%d", chargingMode);
    strcat(holder, stringHolder);
    strcpy(stringHolder, blank);
    strcat(holder, sep);

    // Location
    // getLocation(locDetails);

    for (int i = 0; i < 4; i++)
    {
        strcat(holder, dbIndex[i + 2]);
        sprintf(stringHolder, "%d", locDetails[i]);
        strcat(holder, stringHolder);
        strcpy(stringHolder, blank);
        if (i < 3)
        {
            strcat(holder, sep);
        }
    }

    // closebracket
    strncat(holder, &cb, 1);
}

void getLocation(int *param)
{
    int isReadingValid = 0;
    int isExit = 0;
    
    if (checkGsm() == 0)
    {
        Serial.println("SIM800L offline, cannot get CGI, retrying...");
        return;
    }
        
    while(isExit == 0){
        isReadingValid = 1;
        if (checkGsm() == 0)
        {
            Serial.println("dump");
        }
    
        int intercharTime = 0;
    
        Serial.println("Get nearby antenna info ...");
    
        Sim800l.print("AT+CNETSCAN=1\r");
        vTaskDelay(1000 / portTICK_PERIOD_MS);
    
        Sim800l.print("AT+CNETSCAN\r");
        vTaskDelay(100 / portTICK_PERIOD_MS);
    
        String buffer2;
    
        while ((intercharTime) < MAX_DELAY_MS_GEOLOC)
        {
            if (Sim800l.available())
            {
                int c = Sim800l.read();
                // Serial.print((char)c);
                buffer2.concat((char)c);
                intercharTime = 0;
            }
            else
            {
                intercharTime += LOOP_DELAY_MS;
            }
            vTaskDelay(LOOP_DELAY_MS / portTICK_PERIOD_MS); 
        }
    
        
        Serial.println("CHECK 1");
    
        int str_len = buffer2.length() + 1;
        char strProcess[str_len];
        buffer2.toCharArray(strProcess, str_len);
    
        // parsing
        /* get the first token */
        char sep[2] = {',', ':'};
        int CGI[5];
    
        String processing[10];
        char tempProcessing[50];
        char *token;
        char *token2;
    
        
        Serial.println("CHECK 2");
    
        // get op
        token = strtok(strProcess, ",");
        if (token == NULL)
        {
            Serial.println("\nBuffer error, force quit fx\n");
            return;
        }
    
        
        Serial.println("CHECK 3");
        // Parsing
        processing[0] = token;
        int loopCount = 0;
        for (int i = 1; i < 10; i++)
        {
            if (token == NULL)
            {
                break;
            }
            loopCount = i+1;
            processing[i] = strtok(NULL, ",");
        }
        
        Serial.println("CHECK 3.5");
        if (loopCount == 0){
            continue;
        }
        
        Serial.println("CHECK 4");
        // get mcc, mnc, lac, cellid
        int index = 0;
        for (int i = 1; i < 7; i++)
        {
            Serial.print("CHECK 4-");
            Serial.println(i);
            // skip untuk row 3, 5, 7
            if (i == 3 || i == 5 || i == 7)
            {
                continue;
            }
    
            // convert String to char[]
            char strBuf[50];
    
            Serial.print("PROCESSING:");
            Serial.println(processing[i]);
    
            if (processing[i] == NULL){
                Serial.println("Invalid location readings, retrying..");
                isReadingValid = 0;
                break;
            }
    
            processing[i].toCharArray(strBuf, 50);
            token2 = strtok(strBuf, ":");
    
            // mcc, mnc int
            if (index < 2)
            {
                CGI[index] = atoi(strtok(NULL, ":"));
            }
            // lac cellid hex
            else
            {
                CGI[index] = (int)strtol(strtok(NULL, ":"), NULL, 16);
            }
    
            index++;
        }

        if (isReadingValid == 0){
            Serial.println("lanjut");
        }
        else{
            Serial.println("CHECK 5");
            // masukkan nilai ke pointer args
            param[0] = CGI[0];
            param[1] = CGI[1];
            param[2] = CGI[3];
            param[3] = CGI[2];
            isExit = 1;
        }
    }

    return;
}

void getCurrentTime(char *currentTime)
{
    if (checkGsm() == 0)
    {
        Serial.println("SIM800L offline, cannot get time");
        return;
    }

    int intercharTime = 0;
    Serial.println("Get time info ...");
    Sim800l.print("AT+CCLK?\r");
    String buffer2;

    while (Sim800l.available())
    {
        Serial.write(Sim800l.read());
    }

    while ((intercharTime) < MAX_DELAY_MS_TIME)
    {
        if (Sim800l.available())
        {
            int c = Sim800l.read();
            // Serial.print((char)c);
            buffer2.concat((char)c);
            intercharTime = 0;
        }
        else
        {
            intercharTime += LOOP_DELAY_MS;
        }
        vTaskDelay(LOOP_DELAY_MS / portTICK_PERIOD_MS); 
    }

    int str_len = buffer2.length() + 1;
    char strProcess[str_len];
    buffer2.toCharArray(strProcess, str_len);

    // Parsing (+CCLK: "03/01/01,00:01:58+28")
    char *token;
    token = strtok(strProcess, "\"");
    token = strtok(NULL, "+");
    if (token == NULL)
    {
        Serial.println("\nBuffer error, force quit fx\n");
        return;
    }
    // the snprintf solution
    char timeString[str_len + 2];
    snprintf(timeString, sizeof timeString, "\"%s\"", token);
    strcpy(currentTime, timeString);
    return;
}

int checkGsm()
{
    String buffer2;
    int intercharTime = 0; 
    Sim800l.print("AT\r");
    
    while ((intercharTime) < 100)
    {     
        if (Sim800l.available())
        {
            int c = Sim800l.read();
            //Serial.print((char)c);
            buffer2.concat((char)c);
            intercharTime = 0;
        }
        else
        {
            intercharTime += 1;
        }
        vTaskDelay(1 / portTICK_PERIOD_MS); 
    }

    //    while (Sim800l.available()){
    //        Serial.write(Sim800l.read());
    //    }

    //    Serial.print("buf:");
    //    Serial.println(buffer2);
    //    Serial.println("DONE");

    if (buffer2.indexOf("OK") > 0)
    {
        return 1;
    }
    else
    {
        return 0;
    }
}

int checkGsmNetwork(){
    String buffer2;
    int intercharTime = 0;
    Sim800l.print("AT+CREG?\r");

    while ((intercharTime) < 100)
    {
        if (Sim800l.available())
        {
            int c = Sim800l.read(); 
            // Serial.print((char)c);
            buffer2.concat((char)c); 
            intercharTime = 0; 
        }
        else
        { 
            intercharTime += LOOP_DELAY_MS;
        }

        delay(LOOP_DELAY_MS);
    }
    
//    while (Sim800l.available()){
//        Serial.write(Sim800l.read());
//    }

//    Serial.print("buf:");
//    Serial.println(buffer2);
//    Serial.println("DONE");

    if (buffer2.indexOf("+CREG: 0,1")>0){
        return 1;        
    }
    else{
        return 0;
    }
}

void gprsConnectFuction(){
    Serial.println("Initializing modem...");
    modem.init();

    String modemInfo = modem.getModemInfo();
    Serial.print("Modem Info: ");
    Serial.println(modemInfo);

    Serial.print("Connecting to APN: ");
    Serial.print(apn);
    if (!modem.gprsConnect(apn)) {
        Serial.println(" fail");
        // try again in 30 secs
        // ESP.restart();
    }
    else {
        Serial.println(" -- OK");
    }
    
    if (modem.isGprsConnected()) {
        Serial.println("GPRS connected"); 
    }
}
