kevinnaoko/TA-2122024/(commit log)

2022-03-31 push Eagle dan rollback tanpa SoH
    [Interface.sch, LED_Indicator.brd, LED_Indicator.sch, charger.brd, charger.sch, charger_v2.brd, charger_v2.sch, charger_v3.brd]
2022-04-02 update website
    add alerts
    user session
    manage users
    [Untitled.skp, chRGER.skp]
2022-04-04 ubah 2n700 ke opto + nambahin snubber di mosfet sama dioda
    ubah 2n700 ke opto + nambahin snubber di mosfet sama dioda
    [charger_v3.brd, charger_v3.sch]
2022-04-04 routing v3
    routing v3: opto, snubber, momentary pb, fuse adjst
    [charger_v3.brd, charger_v3.sch]
2022-04-04 benerin opto
    benerin opto
    [charger_v3.brd, charger_v3.sch]
2022-04-04 reroute opto
    [charger_v3.brd]
2022-04-04 update board chg v3
    tambah probe buat D-S
    [charger_v3.brd, charger_v3.sch]
2022-04-05 update board chg v3
    lebarin jalur, snubber
    [charger_v3.brd]
2022-04-05 buat board charger v3.1
    spdt relay
    [charger_v3.1.brd, charger_v3.1.sch, charger_v3.brd, charger_v3.sch, sampling.brd, sampling.sch]
2022-04-05 update board charger v3.1
    update gnd lolipop
    [charger_v3.1.brd]
2022-04-06 update chg v3.1
    relay ganti jadi songle 1ch lagi
    [charger_v3.1.brd]
2022-04-06 update sampling board
    zener, divider HV, update divider batt
    [sampling.brd, sampling.sch]
2022-04-06 update chg v3.1
    benerin airwire, stubs
    [charger_v3.1.brd]
2022-04-06 push kode test standalone
    pwm cl + temp cutoff, gsm serial tx rx, dll
2022-04-12 +Design casing
    [Casing-Drawing.SLDDRW, Casing-v1.SLDPRT, Casing-v2.SLDPRT, Casing-v3.SLDPRT, Casing-v4.SLDPRT, Casing-v41.SLDDRW, Charger-v1.SLDDRW]
2022-04-25 update eagle, server, esp
    [charger_v3.1.brd, charger_v3.1.sch, charger_v3.brd, charger_v3.sch]
2022-04-25 ubah serial jadi serial1
    +nambahin kontrol v2
    [kontrol_v2.brd, kontrol_v2.sch]
2022-04-26 Charging berhenti berdasarkan arus
2022-04-28 edit kontrol v2
    [kontrol_v2.brd, kontrol_v2.sch]
2022-04-28 nambahin library eagle+update kontrolv2
    [kontrol_v2.brd, kontrol_v2.sch]
2022-04-28 Update board kontrol
    Harusnya sudah selesai
    [kontrol_v2.brd, kontrol_v2.sch]
2022-04-29 Buat board charger V4
    [charger_v4.brd, charger_v4.sch, kontrol_v2.brd]
2022-04-29 Update routing charger v4
    [charger_v4.brd, charger_v4.sch]
2022-04-29 Update kontrol
    XH8 -> xh10
    4p term -> 2p term x2
    [kontrol_v2.brd, kontrol_v2.sch]
2022-04-29 minor update charger
    [charger_v4.brd]
2022-04-29 update kontrol
    [kontrol_v2.brd, kontrol_v2.sch]
2022-04-30 update routing chg
    [charger_v4.brd]
2022-04-30 update charger
    [charger_v4.brd]
2022-05-07 gbr boards
2022-05-08 update webserver
    nambahin fitur view battery history, ubah ui main page sedikit
2022-05-09 update webserver
    Rapi rapiin css, bikin user friendly di handphone
2022-05-14 update control buat board baru
2022-06-02 update kode esp
    - task baru buat periodic batt data sampling
    - implementasi initial charging state delay 15s, periodic delay 1s
    - switch wifi/gprs lewat define
2022-06-03 minor fix dashboard
    tambahin advanced mode
    [testbench_openloop_50k.ino]
2022-06-07 update beberapa kode
    - buat testbench_closedloop_v2
    - tambah sync initial enable di b500_v2
    - tambah listener topic sync initial enable di listenMqtt
    - driver tlp250 di charger v4_tlp
    [Driver mosfet v1 4.brd, Driver mosfet v1 4.sch, charger_v4.brd, charger_v4.sch]
