kevinnaoko/TA-2122024/(notices)

Notices in the files:
parts and their libraries:
Sparkfun_LED: Licensing: Creative Commons ShareAlike 4.0 International - https://creativecommons.org/licenses/by-sa/4.0
